rogy-AquaLab/sinsei_UMIUSI_pcb/README.md

# 新生UMIUSIの回路
- 円形基板を積層し、スペースを有効利用
- 表面実装部品の多用による小型化
- 補助マイコン廃止によるプログラムの簡略化
