rogy-AquaLab/sinsei_UMIUSI_pcb/AQUA_VESC/silk.docx

VESC for azimuth thruster

Based on Cheap FOCer

You can use XA or XH for J1, J2, J3

VESC ID

CAN ID

set-servo

SERVO(output only)

This PCB is intended to drive tk Azimuth Thruster
