rogy-AquaLab/sinsei_UMIUSI_pcb/AQUA_VESC/20250817_073502733_iOS.jpg

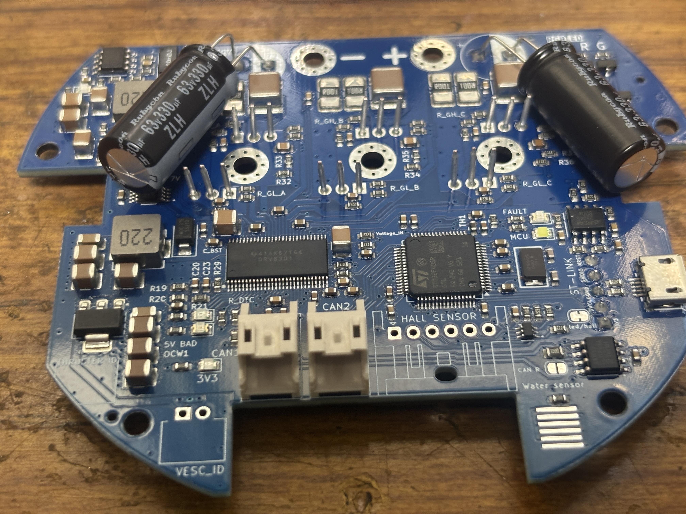
AQUA_VESC/20250817_073502733_iOS.jpg
