rogy-AquaLab/sinsei_UMIUSI_pcb/AQUA_VESC/20250819_080514195_iOS.jpg

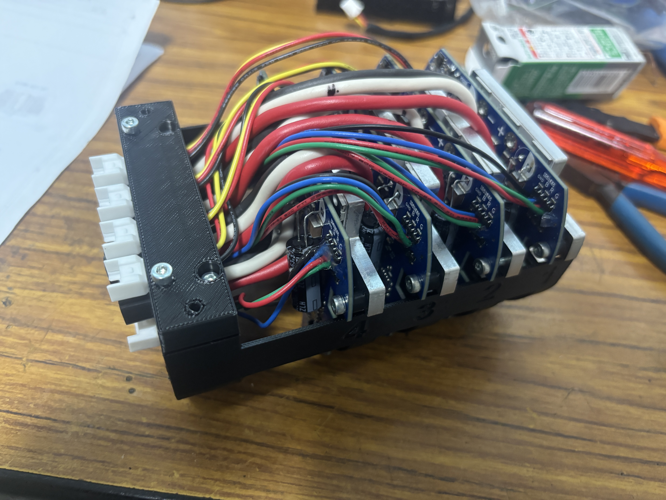
AQUA_VESC/20250819_080514195_iOS.jpg
