rogy-AquaLab/sinsei_UMIUSI_pcb/AQUA_VESC/no_limit.png

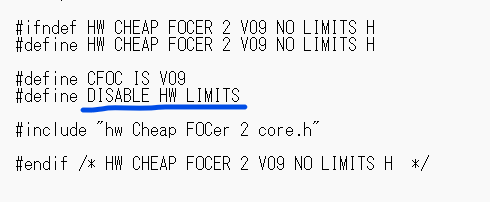
AQUA_VESC/no_limit.png
