rogy-AquaLab/sinsei_UMIUSI_pcb/AQUA_VESC/PSPICE/DRV8301.png

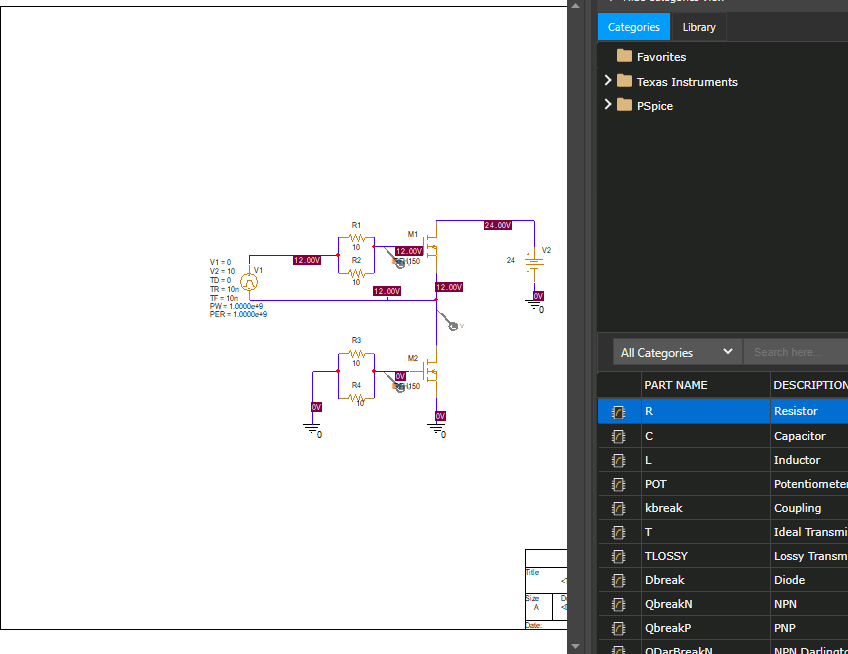
AQUA_VESC/PSPICE/DRV8301.png
