rogy-AquaLab/sinsei_UMIUSI_pcb/back_connector_base/aqua_rogo.png

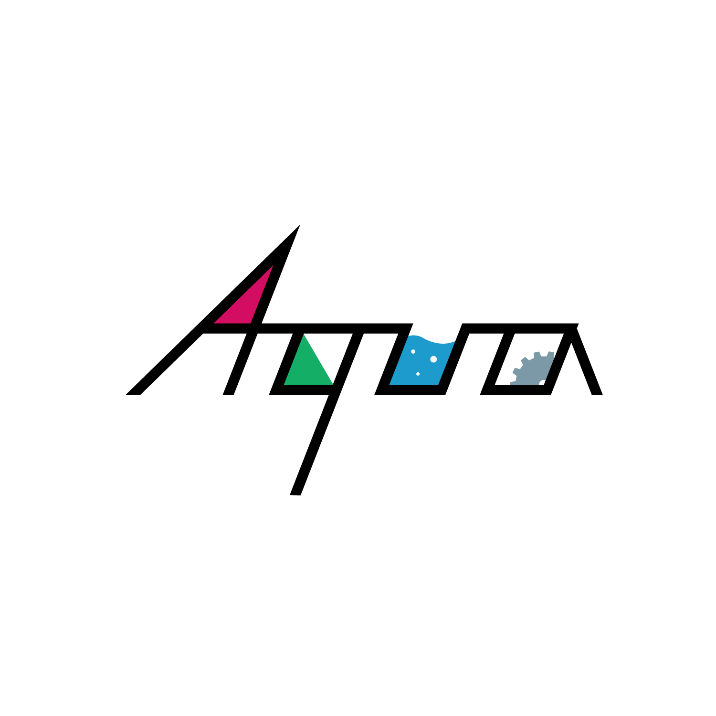
back_connector_base/aqua_rogo.png
