rogy-AquaLab/sinsei_UMIUSI_pcb/back_connector_base/auv_rov_core_unit.png

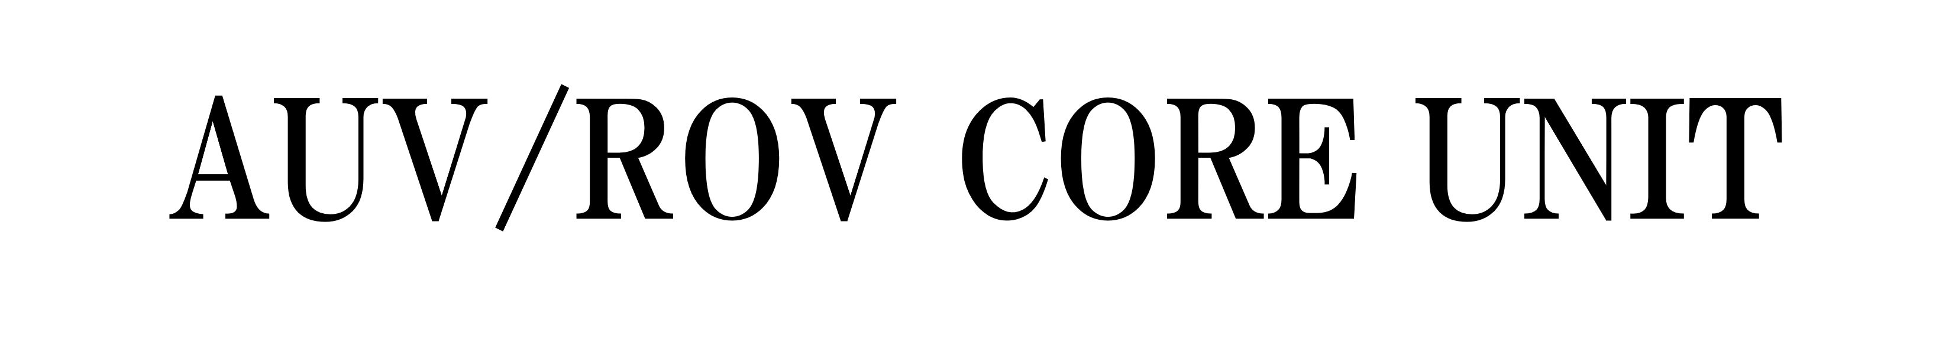
back_connector_base/auv_rov_core_unit.png
