rogy-AquaLab/sinsei_UMIUSI_pcb/control_unit/REV00 LED基板接続表.png

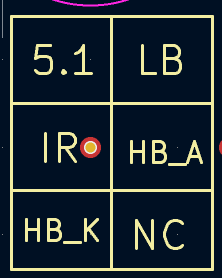
control_unit/REV00 LED基板接続表.png
