rogy-AquaLab/sinsei_UMIUSI_pcb/ESC画像.png

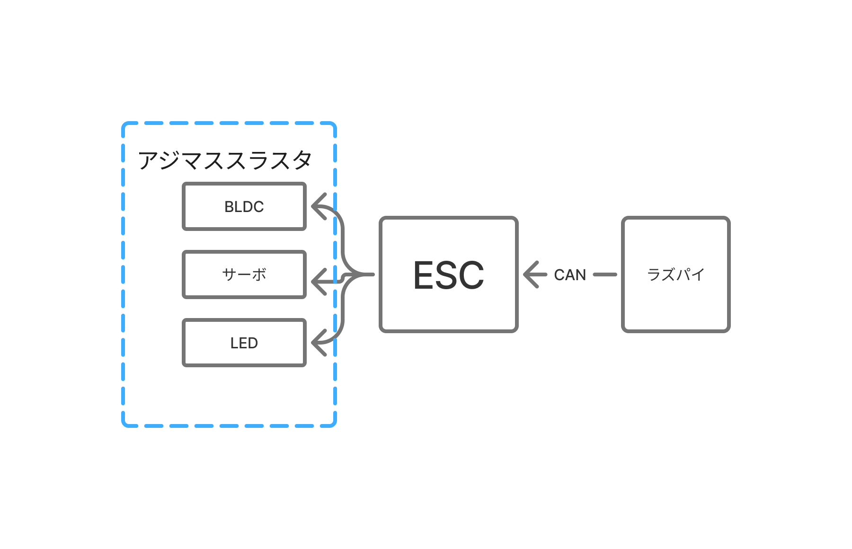
ESC画像.png
