rogy-AquaLab/sinsei_UMIUSI_pcb/新生UMIUSI回路.png

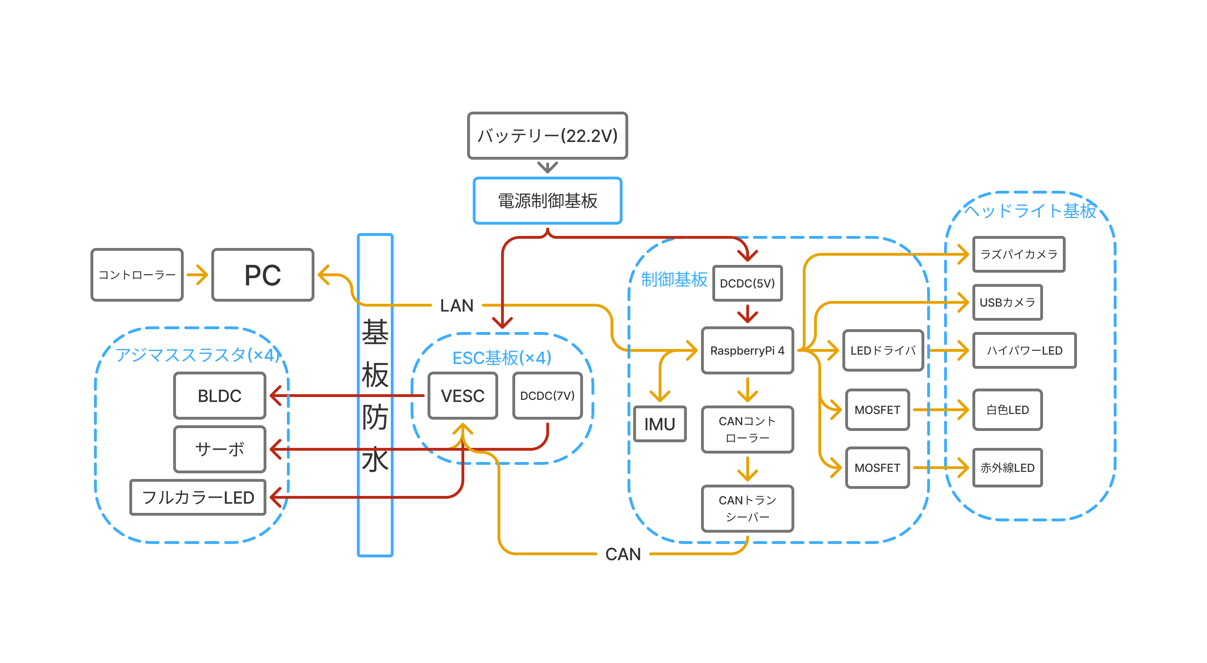
新生UMIUSI回路.png
