rogy-AquaLab/sinsei_UMIUSI_pcb/control_unit/bom.csv

Reference | Value | 所持 | 必要個数 | 売り場 | リンク
Analog_IN1 | Conn_01x04_Pin | 〇
CAN1 | Conn_01x02_Pin | 〇
CAN2 | Conn_01x02_Pin | 〇
Cc1 | 5.6n | 〇
Cc2 | 82p | 〇
Cc3 | 1500p | 〇
headlight1 | Conn_02x03_Odd_Even | △
J2 | Conn_01x02_Socket | 〇
J4 | SERVO_PWM | 〇
J5 | BLDC1 | 〇
J6 | BLDC1 | 〇
J7 | BLDC1 | 〇
J8 | BLDC1 | 〇
J9 | Barrel_Jack_Switch | 〇
M1 | Motor_Servo | 〇
M2 | Fan | 〇
Q1 | MTB7D0N6RJ3 |  | 2 | 36番売場 2段目 | https://akizukidenshi.com/catalog/g/g117191/
R1 | 20m |  | 1 | 1F 15番売場 下段スチール棚の引出 | https://akizukidenshi.com/catalog/g/g106668/
TP1 | TestPoint |  | 3 | 1F 12番売場 下段スチール棚の引出 | https://akizukidenshi.com/catalog/g/g107593/
U1 | CL6808 |  | 1 | 1F 34番売場 4段目 | https://akizukidenshi.com/catalog/g/g106278/
U2 | ~ | 〇
U3 | ATA6561-GAQW-N |  | 1 | 1F 38番売場 3段目 | https://akizukidenshi.com/catalog/g/g130008/
U4 | ADS1015IDGS |  | 1 | なし
U15 | BNO055 DIP | 〇
