rogy-AquaLab/sinsei_UMIUSI_pcb/LM25145_test/タイプ3位相補償設計/LM25145_quickstart_calculator_A5.xlsm

Sheet: Design Regulator
LM(2)5145/46-Q1 DC-DC Controller Design Tool
About |  | xx (http://www.ti.com/pol) |  |  | = Input Box |  |  |  |  | TERMS OF USE
Step 1: Operating Specifications
 |  |  | Input Voltage ‒ Min, VIN(min) | 18 | V
 |  |  | Input Voltage ‒ Nom, VIN(nom) | 24 | V
 |  |  | Input Voltage ‒ Max, VIN(max) | 36 | V
 |  |  | Output Voltage, VOUT | 5.1 | V
 |  |  | Maximum Output Current, IOUT | 6 | A
 |  |  | Free-running Switching Frequency, FSW | 300 | kHz
 |  |  | SYNC Frequency (if used), FSW-SYNC | 300 | kHz
 |  |  | Frequency Set Resistor, RRT | 33.2 | kΩ
Step 2: Filter Inductor
 |  |  | Recommended Filter Inductance | 6.7 | µH
 |  |  | Inductance, LF | 9.5 | µH
 |  |  | Inductor DCR | 20 | mΩ
 |  |  | Pk-to-Pk Ripple Current at VIN(nom), DIL | 1.5 | Apk-pk
 |  |  | Inductor Ripple Current as a % of Max IOUT | 24.20526316 | %
 |  |  | Estimate Core Loss at VIN(nom) | 0.2 | W
Step 3: RDS(on) or Shunt-Based Current Limit
 |  |  | Shunt, RS | 6 | mΩ |  |  |  |  |  | \
 |  |  | Required Current Limit Setpoint | 6.5 | A
 |  |  | Current Limit Set Resistor, RILIM | 174 | Ω
 |  |  | Min Inductor Sat Current, IL(SAT) | 8.4 | A
 |  |  | Power Loss in RS at Full Load, Max VIN | 0.16 | W
Step 4: Output Capacitance
 |  |  | Output Voltage Ripple Specification | 20 | mVpk-pk
 |  |  | Minimum Ideal Output Capacitance | 30.25657895 | µF
 |  |  | Total Output Capacitance (Derated), COUT | 135 | µF
 |  |  | Maximum Permitted ESR | 13.42078516 | mΩ
 |  |  | Output Capacitor ESR | 1 | mΩ
 |  |  | Resulting Output Voltage Ripple | 4.711861013 | mVpk-pk
 |  |  | Output Capacitor Ripple Current | 0.4 | A (rms)
Step 5: Input Capacitance
 |  |  | Input Voltage Ripple Specification | 50 | mVpk-pk
 |  |  | Minimum Ideal Input Capacitance | 68.4156 | µF
 |  |  | Total Input Capacitance (Derated), CIN | 110 | µF
 |  |  | Maximum Permitted ESR | 2.810222462 | mΩ
 |  |  | Input Capacitor ESR | 2 | mΩ
 |  |  | Resulting Input Voltage Ripple | 44.55031579 | mVpk-pk
 |  |  | Input Capacitor Ripple Current | 2.5 | A (rms)
Step 6: Soft-start, UVLO
 |  |  | Soft-Start Time, tSS | 8 | ms
 |  |  | Soft-Start Capacitance, CSS | 100 | nF
 |  |  | Input Voltage UVLO Turn-On | 8.33 | V
 |  |  | Input Voltage UVLO Turn-Off | 7.58 | V
 |  |  | UVLO Upper Resistor, RUV1 | 75 | kΩ
 |  |  | UVLO Lower Resistor, RUV2 | 12.7 | kΩ
If the SYNC feature is not required, connect SYNCIN to GND
or VCC for DCM or CCM operation, respectively
Step 7: Compensation Design
 |  |  | LC Complex Pole Frequency | 4.5 | kHz
 |  |  | ESR Zero Frequency | 1178.925506 | kHz
 |  |  | Desired Crossover Frequency | 48 | kHz
 |  |  | Appropriate Midband Gain | 0.71 | V/V
 |  |  | Upper Feedback Resistor, RFB1 | 18 | kΩ
 |  |  | Lower Feedback Resistor, RFB2 | 3.32 | kΩ
 |  |  | Actual Output Voltage, VOUT | 5.137 | V
Pole & Zero Placement |  |  | FZ1 | 4.1 | kHz
Baseline P/Z Frequencies: |  |  | FZ2 | 5.0 | kHz
 |  |  | FP1 | 200 | kHz
 |  |  | FP2 | 250 | kHz
Compensation Components
 | Calculated / | Std Values | Selected |  | Actual P/Z Frequencies
RC1 | 12.8 | 12.7 | 12 | kΩ | 4.0 | kHz (FZ1)
CC1 | 3028.309592 | 3300 | 3300 | pF | 5.7 | kHz (FZ2)
CC2 | 50.49235187 | 47 | 47 | pF | 225.7516926 | kHz (FP1)
RC2 | 461.5384615 | 464 | 470 | Ω | 286.20868 | kHz (FP2)
CC3 | 1724.178552 | 1800 | 1500 | pF |  |  | ** Specify Inductor Core Loss ** | 0.4 | W
Efficiency / Power Loss Analyzer
Step 8: Efficiency
 |  |  | High-Side MOSFET (Q1) Specifications | CSD18563Q5D
 |  |  | On-State Resistance, RDS(on) | 6 | mΩ
 |  |  | Total Gate Charge, QG | 27 | nC
 |  |  | Gate-Drain Charge, QGD | 9 | nC
 |  |  | Gate-Source Charge, QGS | 8 | nC
 |  |  | Output Capacitance, COSS | 338 | pF
 |  |  | Gate Resistance, RG | 2 | Ω
 |  |  | Transconductance, gFS | 100 | S
 |  |  | Gate-Source Plateau Voltage, VGS(MP) | 3.8 | V
 |  |  | Body Diode Forward Voltage, VBD1 | 0.8 | V
 |  |  | Thermal Resistance, θJA | 50 | °C/W
 |  |  | Low-Side MOSFET (Q2) Specifications | CSD18563Q5D
 |  |  | On-State Resistance, RDS(on) | 6 | mΩ
 |  |  | Total Gate Charge, QG | 27 | nC
 |  |  | Output Charge, QOSS | 20 | nC
 |  |  | Output Capacitance, COSS | 338 | pF
 |  |  | Body Diode Forward Voltage, VBD2 | 0.8 | V
 |  |  | Body Diode Recovery Charge, QRR | 19 | nC
 |  |  | Thermal Resistance, θJA | 50 | °C/W
 |  |  | Antiparallel Schottky Diode (if applicable)
 |  |  | Schottky Diode Forward Voltage, VSD | 0 | V
 |  |  | Schottky Diode Recovery Charge, QRR2 | 0 | nC
Step 9: IC Power Loss
 |  |  | IC Power Dissipation | 0.17 | W
 |  |  | IC Junction Temperature Rise (est) | 8.5 | °C

Sheet: Schematic & BOM
 | ** Tie SYNCIN to VCC and GND for CCM and DCM operation, respectively **
VIN = 24 V, VOUT = 5.1 V, IOUT = 6 A, Fsw = 300 kHz, Current Limit = 7 A
Wide VIN, High Efficiency Synchronous Buck Regulator BOM
Count | Ref Des | Value | Description | Size | Part Number | MFR | Footprint (mm) | Area (mm2)
1 | CBOOT | 0.1µF | Capacitor, Ceramic,0.1µF, 25V, X7R, 20% |  | Std | Std | 1.6 x 0.8 | 1.3 |  |  |  | 2
1 | CC1 | 3300pF | Capacitor, Ceramic,3300pF, 16V, X7R, 10% |  | Std | Std | 1.0 x 0.5 | 0.5 |  |  |  | 1
1 | CC2 | 47pF | Capacitor, Ceramic,47pF, 50V, NP0, 5% |  | Std | Std | 1.0 x 0.5 | 0.5 |  |  |  | 1
1 | CC3 | 1500pF | Capacitor, Ceramic,1500pF, 50V, NP0, 5% |  | Std | Std | 1.0 x 0.5 | 0.5 |  |  |  | 1
1 | CS | 33pF | Capacitor, Ceramic, 33pF, 100V, X7R, 20% |  | Std | Std | 1.6 x 0.8 | 1.3 |  |  |  | 2
11 | CIN | 4.7µF | Capacitor, Ceramic, 4.7µF, 50V, X7R, 10% |  | Std | Std | 3.2 x 2.5 | 88.0 |  |  |  | 5
3 | COUT | 47µF | Capacitor, Ceramic, 47µF, 10V, X7R, 10% |  | Std | Std | 3.2 x 2.5 | 24.0 |  |  |  | 5
1 | CSS | 100nF | Capacitor, Ceramic,100nF, 16V, X7R, 10% |  | Std | Std | 1.6 x 0.8 | 1.3 |  |  |  | 2
1 | CVCC | 2.2µF | Capacitor, Ceramic,2.2µF, 25V, X7R, 20% |  | Std | Std | 2.0 x 1.25 | 2.5 |  |  |  | 3
1 | CVIN | 0.1µF | Capacitor, Ceramic,0.1µF, 50V, X7R, 20% |  | Std | Std | 1.6 x 0.8 | 1.3 |  |  |  | 2
1 | LF | 9.5µH | Inductor, 9.5µH, 20mΩ, >9A |  | Various | Various | 10.0 x 10.0 | 100.0 |  |  |  | 7
1 | Q1 | See description | MOSFET, N-CH, 80V/100V,6mΩ |  | CSD18563Q5D | TI | 5.0 x 6.0 | 30.0 |  |  |  | 1 | 1
1 | Q2 | See description | MOSFET, N-CH, 80V/100V,6mΩ |  | CSD18563Q5D | TI | 5.0 x 6.0 | 30.0 |  |  |  | 1 | 1
1 | RC1 | 12k | Resistor, Chip,12kΩ, 1/16W, 1% |  | Std | Std | 1.0 x 0.5 | 0.5 |  |  |  | 1
1 | RC2 | 470 | Resistor, Chip,470Ω, 1/16W, 1% |  | Std | Std | 1.0 x 0.5 | 0.5 |  |  |  | 1
1 | RILIM | 174 | Resistor, Chip,174Ω, 1/16W, 1% |  | Std | Std | 1.0 x 0.5 | 2.5 |  |  |  | 3
1 | RRT | 33.2k | Resistor, Chip,33.2kΩ, 1/16W, 1% |  | Std | Std | 1.0 x 0.5 | 0.5 |  |  |  | 1
1 | RFB1 | 18k | Resistor, Chip,18kΩ, 1/16W, 1% |  | Std | Std | 1.0 x 0.5 | 0.5 |  |  |  | 1
1 | RFB2 | 3.32k | Resistor, Chip,3.32kΩ, 1/16W, 1% |  | Std | Std | 1.0 x 0.5 | 0.5 |  |  |  | 1
1 | RPGOOD | 20k | Resistor, Chip,20kΩ, 1/16W, 1% |  | Std | Std | 1.0 x 0.5 | 0.5 |  |  |  | 1
1 | RS | 6mΩ | Resistor,6mΩ, 1/4W, 1% | 1206 | Std | Std | 3.2 x 1.6 | 0.0
1 | RUV1 | 75k | Resistor, Chip,75kΩ, 1/16W, 1% |  | Std | Std | 1.6 x 0.8 | 1.3 |  |  |  | 2
1 | RUV2 | 12.7k | Resistor, Chip,12.7kΩ, 1/16W, 1% |  | Std | Std | 1.0 x 0.5 | 0.5 |  |  |  | 1
1 | RVIN | 2.2 | Resistor, Chip,2.2Ω, 1/16W, 1% |  | Std | Std | 1.0 x 0.5 | 0.5 |  |  |  | 1
1 | U1 | LM25145 | IC, LM25145, PWM Controller, 6V-42V Input | VQFN-20 | LM25145RGYR | TI | 3.5 x 4.5 x 1.0 | 15.75
 |  |  |  |  | Total Solution Size (buffered by 25%) |  |  | 380.9 | mm2 = | 0.5905 | in2
NOTES:
** Inductor saturation current should be higher than the current limit setpoint at all operating temperatures **
** Effective output capacitance should be appropriately derated for applied voltage and temperature, particularly with ceramics **
 |  |  |  |  |  |  |  |  |  |  |  | 2

Sheet: EVMs
LM(2)5145/6/-Q1 Quickstart Calculator
 | LM5146-Q1-EVM12V
 | LM5145EVM-HD-20A PCB Layout
 |  | Top
 |  | Layer | x
 |  | Layer 2
 |  | Layer 3
 |  | Bottom
