rogy-AquaLab/sinsei_UMIUSI_pcb/AQUA_VESC-to-relay-pcb/AQUA_VESC-to-relay-pcb.step

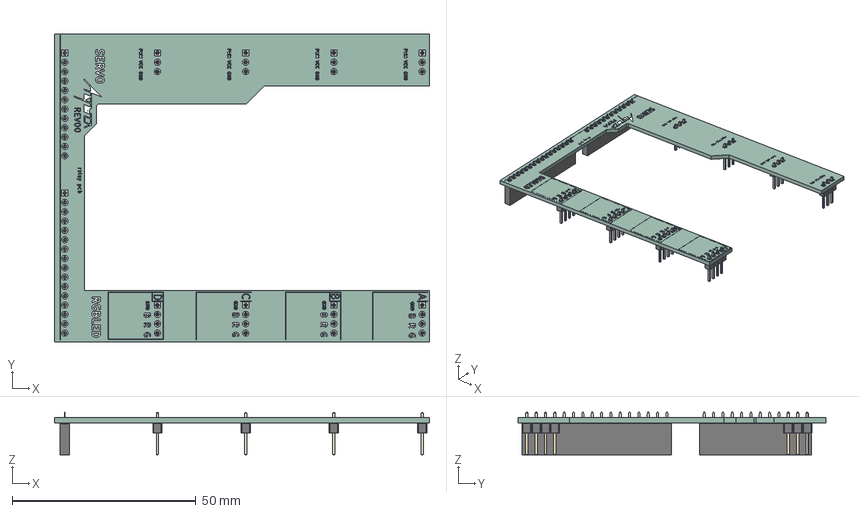
[picture p12: CAD file, 2025-10-03]
AQUA_VESC-to-relay-pcb/AQUA_VESC-to-relay-pcb.step
102.0 x 83.7 x 11.6 mm
PinHeader_1x04_P2.54mm_Vertical x 4
PinHeader_1x03_P2.54mm_Vertical x 4
PinSocket_1x16_P2.54mm_Vertical
PinSocket_1x12_P2.54mm_Vertical
AQUA_VESC-to-relay-pcb_pad
AQUA_VESC-to-relay-pcb_silkscreen
AQUA_VESC-to-relay-pcb_PCB
