rogy-AquaLab/sinsei_UMIUSI_pcb/back_connector_base/back_connector_base.dxf

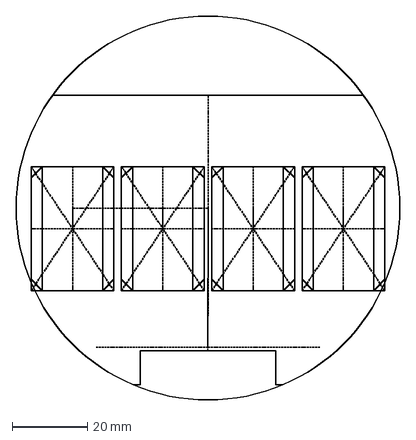
[picture p13: CAD file, 2025-10-03]
back_connector_base/back_connector_base.dxf
102.0 x 102.0 mm
