rogy-AquaLab/sinsei_UMIUSI_pcb/back_connector_esc/back_connector_esc.step

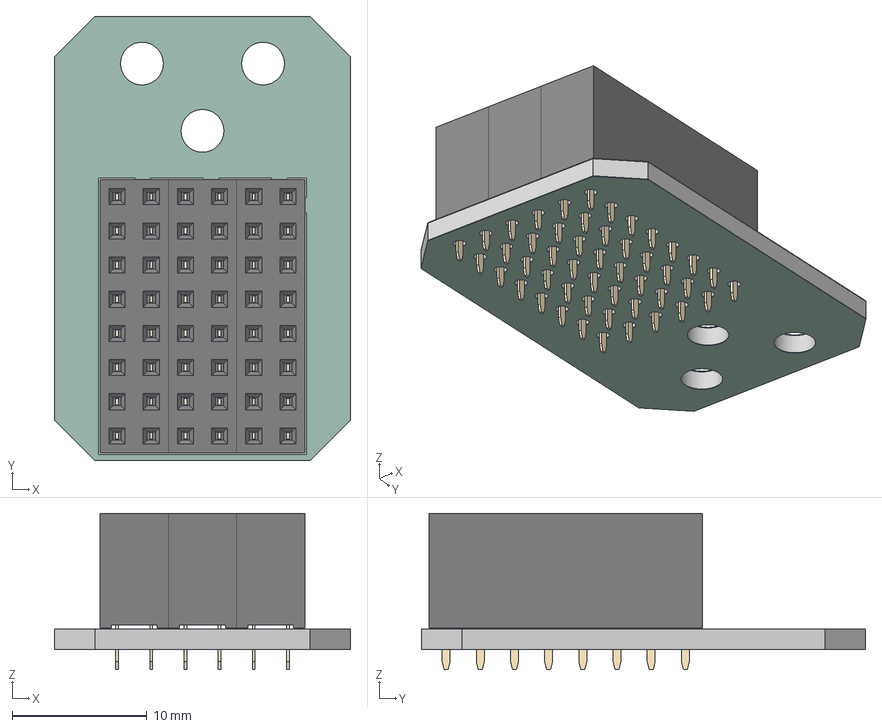
[picture p14: CAD file, 2025-10-03]
back_connector_esc/back_connector_esc.step
22.0 x 33.0 x 11.6 mm
PinSocket_2x08_P2.54mm_Vertical x 3
back_connector_esc_silkscreen
back_connector_esc_soldermask
back_connector_esc_PCB
