rogy-AquaLab/sinsei_UMIUSI_pcb/can_connector/can_connector.step

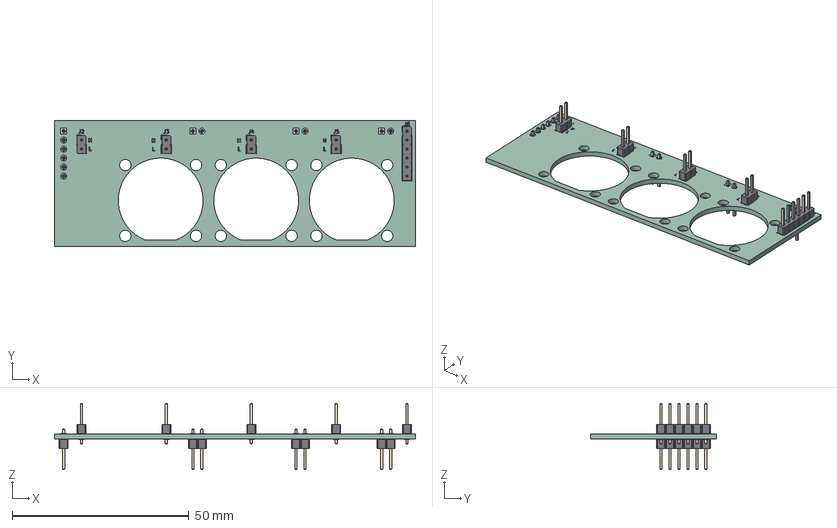
[picture p15: CAD file, 2025-10-03]
can_connector/can_connector.step
102.0 x 35.6 x 18.8 mm
PinHeader_1x02_P2.54mm_Vertical x 7
PinHeader_1x06_P2.54mm_Vertical x 2
can_connector_pad
can_connector_silkscreen
can_connector_PCB
