rogy-AquaLab/sinsei_UMIUSI_pcb/control_unit/CAD/Pin Header - RaspberryPi - Stacking - 2.54mm_V2.step

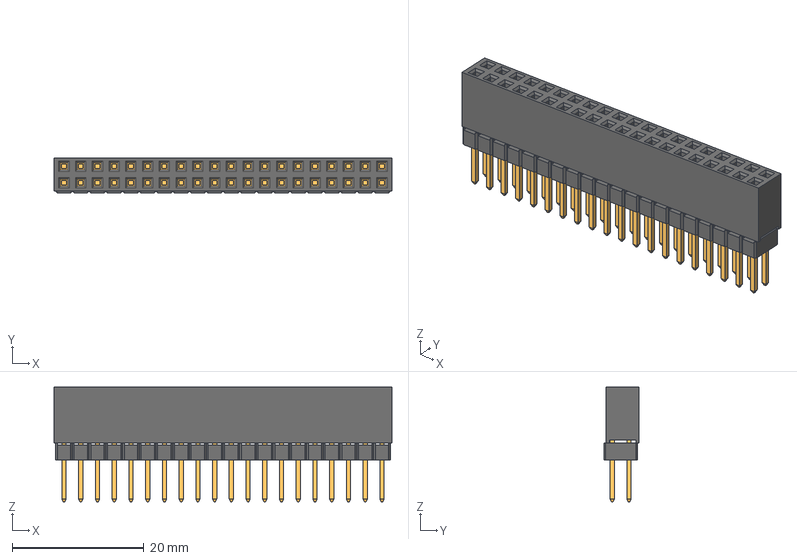
[picture p16: CAD file, 2025-06-03]
control_unit/CAD/Pin Header - RaspberryPi - Stacking - 2.54mm_V2.step
51.3 x 5.33 x 17.4 mm
