rogy-AquaLab/sinsei_UMIUSI_pcb/frame/基板ホルダ3.step

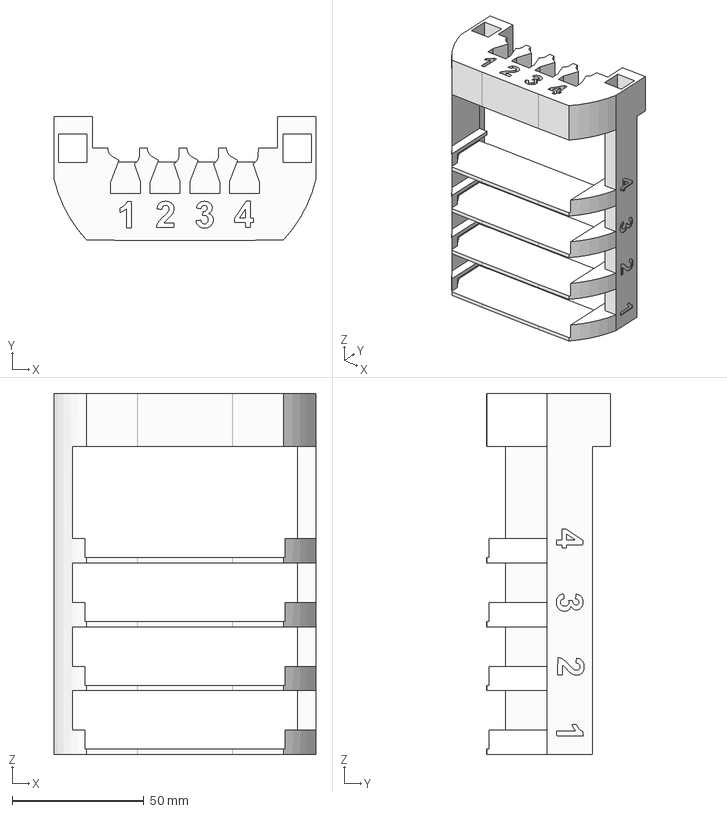
[picture p17: CAD file, 2025-08-26]
frame/基板ホルダ3.step
99.1 x 47.0 x 136.8 mm
