rogy-AquaLab/sinsei_UMIUSI_pcb/headlight_lower_side/headlight_lower_side.step

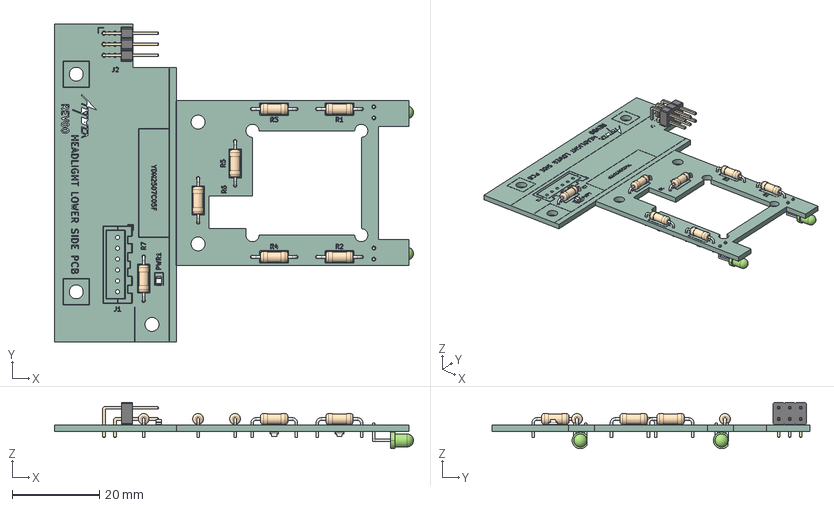
[picture p18: CAD file, 2025-07-05]
headlight_lower_side/headlight_lower_side.step
82.5 x 73.0 x 10.7 mm
R_Axial_DIN0207_L6.3mm_D2.5mm_P10.16mm_Horizontal x 7
LED_0805_2012Metric x 5
PinHeader_2x03_P2.54mm_Horizontal
LED_D3.0mm_Horizontal_O3.81mm_Z2.0mm x 2
headlight_lower_side_silkscreen
headlight_lower_side_PCB
