rogy-AquaLab/sinsei_UMIUSI_pcb/headlight_upper_side/headlight_upper_side.step

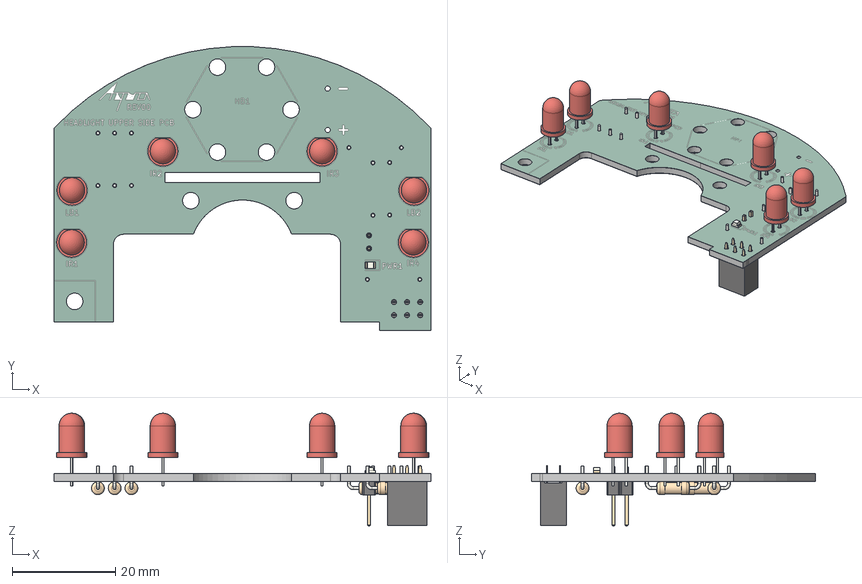
[picture p19: CAD file, 2025-07-05]
headlight_upper_side/headlight_upper_side.step
73.0 x 54.9 x 21.8 mm
LED_D5.0mm x 6
LED_0805_2012Metric
R_Axial_DIN0207_L6.3mm_D2.5mm_P10.16mm_Horizontal x 7
PinSocket_2x03_P2.54mm_Vertical
PinHeader_1x02_P2.54mm_Vertical
headlight_upper_side_silkscreen
headlight_upper_side_soldermask
headlight_upper_side_PCB
