rogy-AquaLab/sinsei_UMIUSI_pcb/LED基板概要.dxf

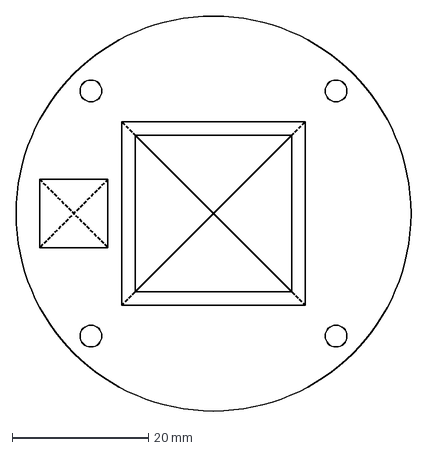
[picture p20: CAD file, 2025-04-20]
LED基板概要.dxf
58.0 x 58.0 mm
