rogy-AquaLab/sinsei_UMIUSI_pcb/pcb_connector_azimuth_thruster/pcb_connector_azimuth_thruster.step

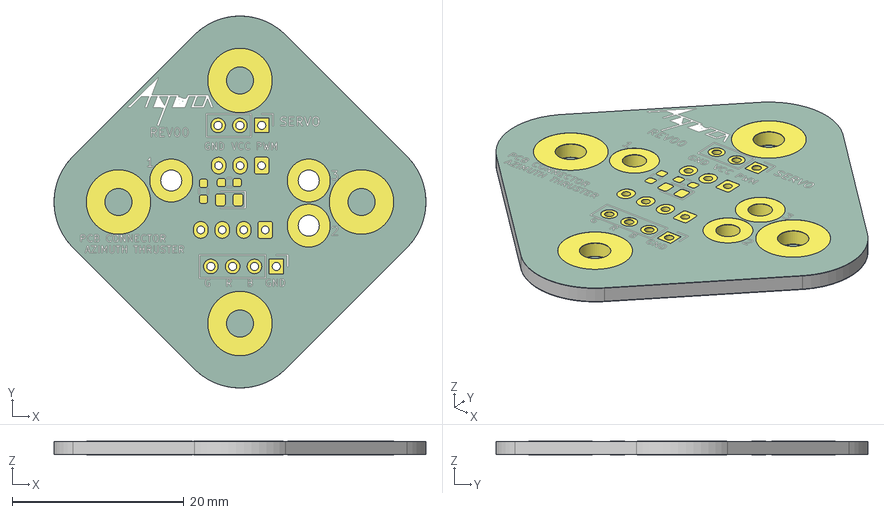
[picture p21: CAD file, 2025-07-05]
pcb_connector_azimuth_thruster/pcb_connector_azimuth_thruster.step
43.3 x 43.3 x 1.66 mm
pcb_connector_azimuth_thruster_pad
pcb_connector_azimuth_thruster_silkscreen
pcb_connector_azimuth_thruster_soldermask
pcb_connector_azimuth_thruster_PCB
