rogy-AquaLab/sinsei_UMIUSI_pcb/pcb_connector_lan(inner)/pcb_connector_lan(inner).step

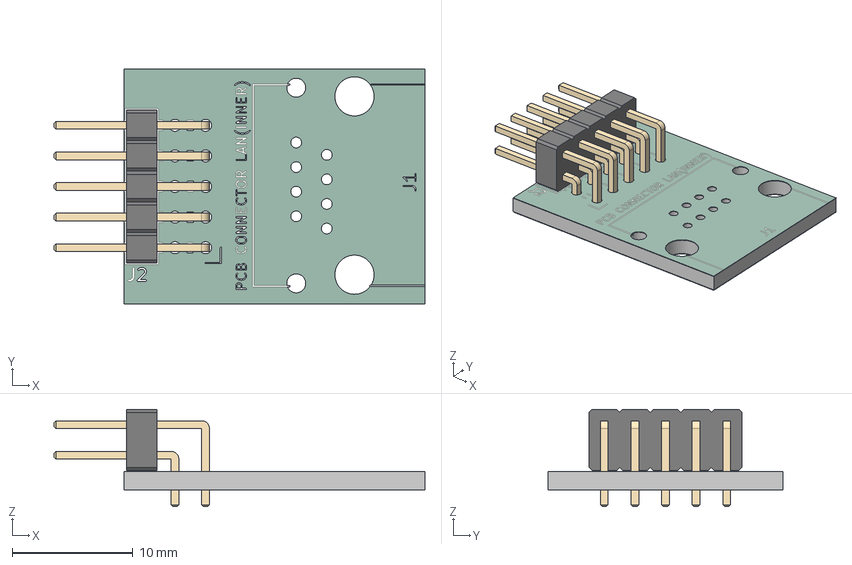
[picture p22: CAD file, 2025-07-05]
pcb_connector_lan(inner)/pcb_connector_lan(inner).step
30.8 x 19.5 x 8.08 mm
PinHeader_2x05_P2.54mm_Horizontal
pcb_connector_lan_silkscreen
pcb_connector_lan_soldermask
pcb_connector_lan_PCB
