rogy-AquaLab/sinsei_UMIUSI_pcb/pcb_connector_lan(outer)/pcb_connector_lan(outer).step

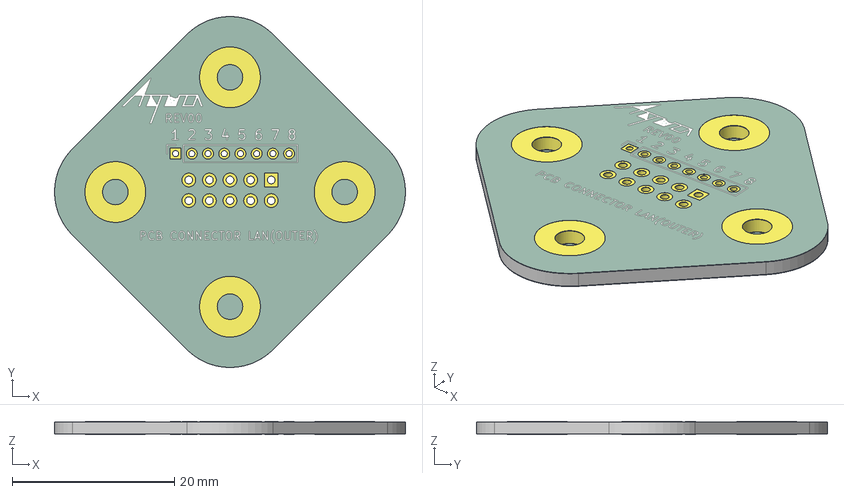
[picture p23: CAD file, 2025-07-05]
pcb_connector_lan(outer)/pcb_connector_lan(outer).step
43.3 x 43.3 x 1.66 mm
pcb_connector_lan(outer)_pad
pcb_connector_lan(outer)_silkscreen
pcb_connector_lan(outer)_soldermask
pcb_connector_lan(outer)_PCB
