rogy-AquaLab/sinsei_UMIUSI_pcb/pcb_connector_led_tape/pcb_connector_led_tape.step

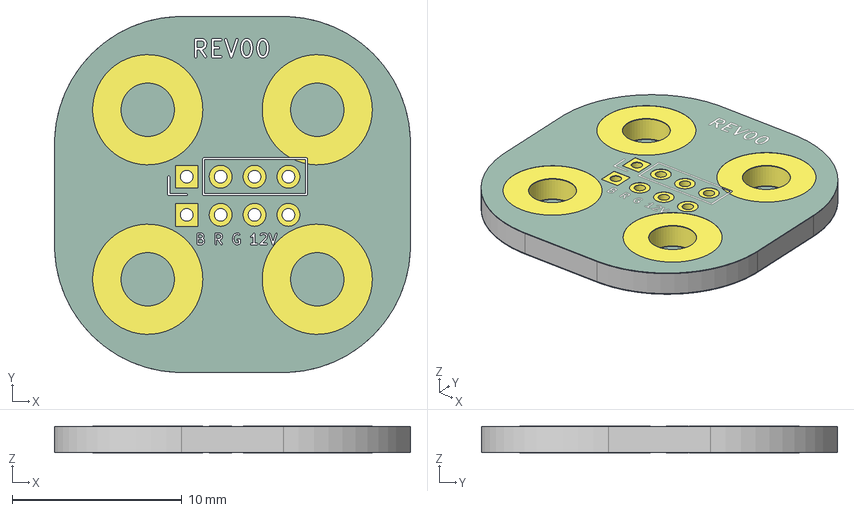
[picture p24: CAD file, 2025-07-05]
pcb_connector_led_tape/pcb_connector_led_tape.step
21.0 x 21.0 x 1.66 mm
pcb_connector_led_tape_pad
pcb_connector_led_tape_silkscreen
pcb_connector_led_tape_soldermask
pcb_connector_led_tape_PCB
