rogy-AquaLab/sinsei_UMIUSI_pcb/power_circuit_2/スケッチ1.dxf

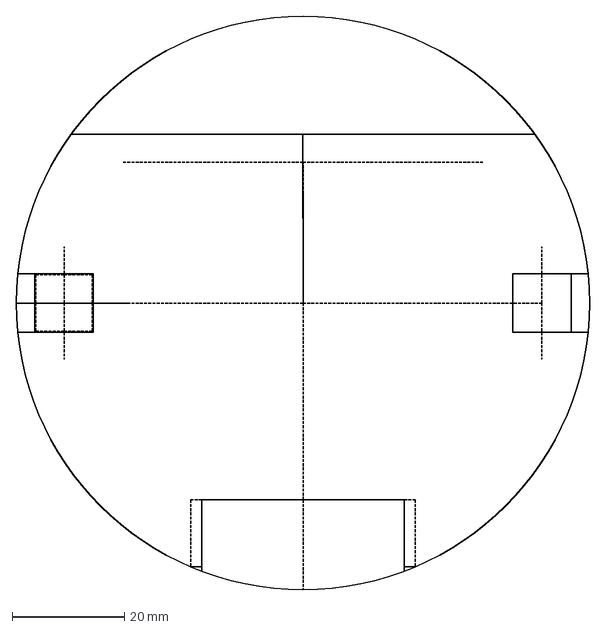
[picture p25: CAD file, 2025-07-21]
power_circuit_2/スケッチ1.dxf
102.0 x 102.0 mm
