rogy-AquaLab/sinsei_UMIUSI_pcb/UmiusiThrusterLEDUnit/UmiusiThrusterLEDUnit.step

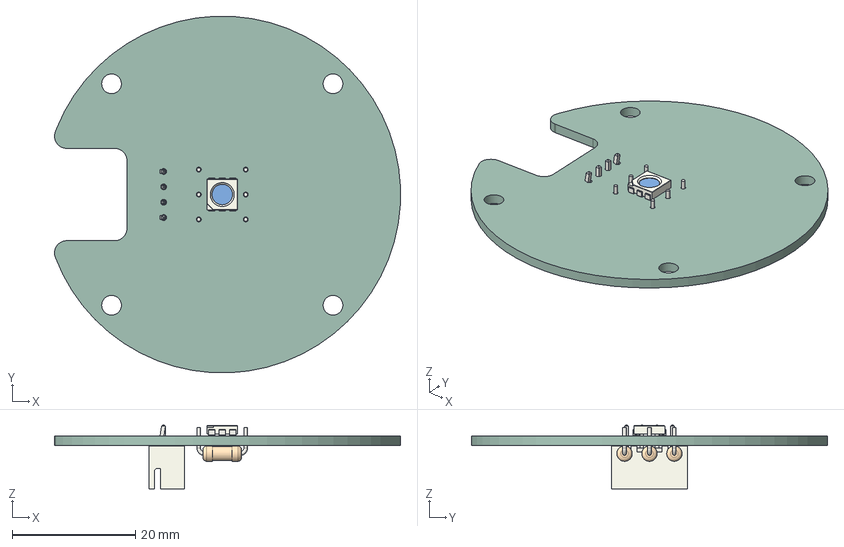
[picture p26: CAD file, 2025-04-28]
UmiusiThrusterLEDUnit/UmiusiThrusterLEDUnit.step
56.3 x 57.9 x 10.4 mm
LED_RGB_5050_6
JST_B4B_XH_A
R_Axial_DIN0207_L63mm_D25mm_P762mm_Horizontal x 3
_autosave-UmiusiThrusterLEDUnit_PCB
