rogy-AquaLab/sinsei_UMIUSI_pcb/frame/制御基板取付用 v6.stl

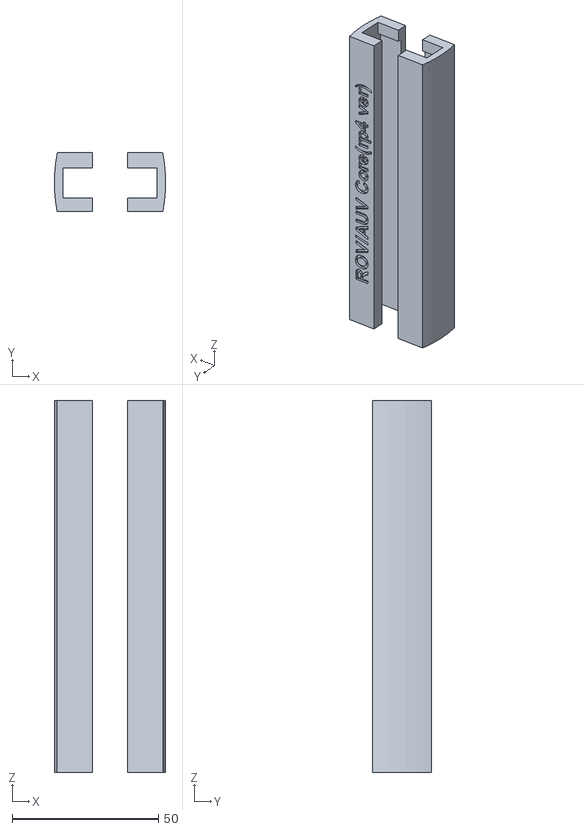
[picture p27: CAD file, 2025-08-26]
frame/制御基板取付用 v6.stl
38.0 x 20.0 x 127.0
