rogy-AquaLab/sinsei_UMIUSI_pcb/headlight_lower_side/headlight_upper_side.dxf

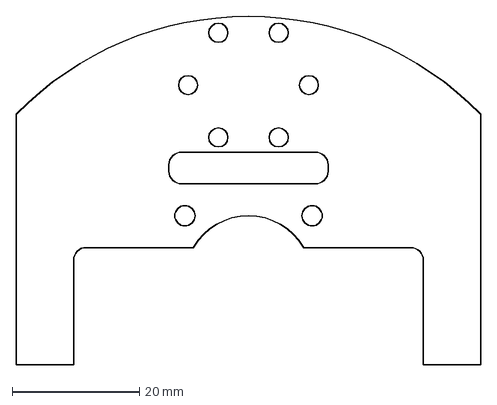
[picture p28: CAD file, 2025-06-10]
headlight_lower_side/headlight_upper_side.dxf
73.0 x 54.8 mm
