rogy-AquaLab/sinsei_UMIUSI_pcb/UmiusiThrusterLEDUnit/UmiusiThrusterLEDUnit-User_1.dxf

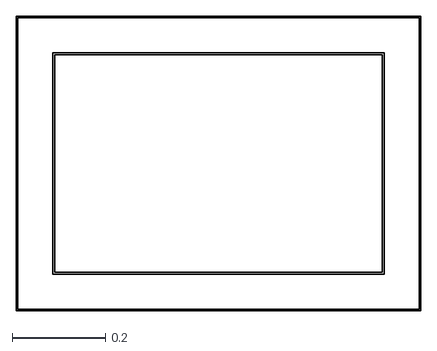
[picture p29: CAD file, 2025-04-28]
UmiusiThrusterLEDUnit/UmiusiThrusterLEDUnit-User_1.dxf
0.87 x 0.634
