rogy-AquaLab/sinsei_UMIUSI_pcb/headlight_lower_side/スケッチ9.dxf

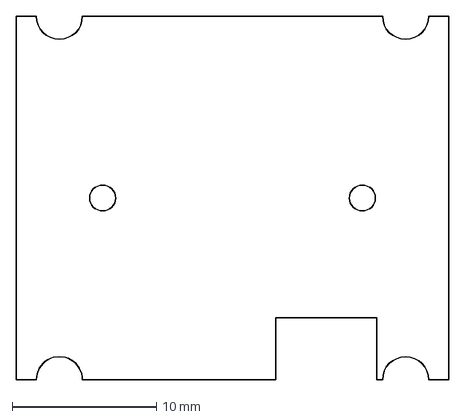
[picture p30: CAD file, 2025-06-03]
headlight_lower_side/スケッチ9.dxf
30.0 x 25.2 mm
