rogy-AquaLab/sinsei_UMIUSI_pcb/UmiusiThrusterLEDUnit/Component8.step

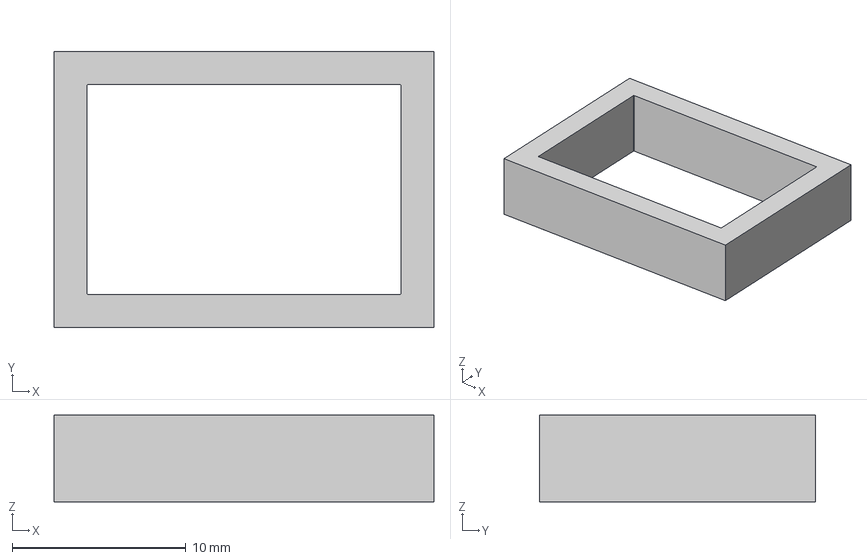
[picture p31: CAD file, 2025-04-28]
UmiusiThrusterLEDUnit/Component8.step
21.9 x 15.9 x 5.00 mm
