rogy-AquaLab/sinsei_UMIUSI_pcb/frame/基板ホルダ2.step

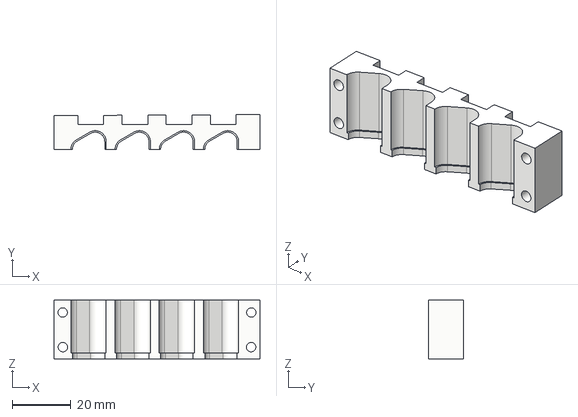
[picture p32: CAD file, 2025-08-26]
frame/基板ホルダ2.step
70.0 x 11.8 x 20.0 mm
