rogy-AquaLab/sinsei_UMIUSI_pcb/headlight_lower_side/high power LED.dxf

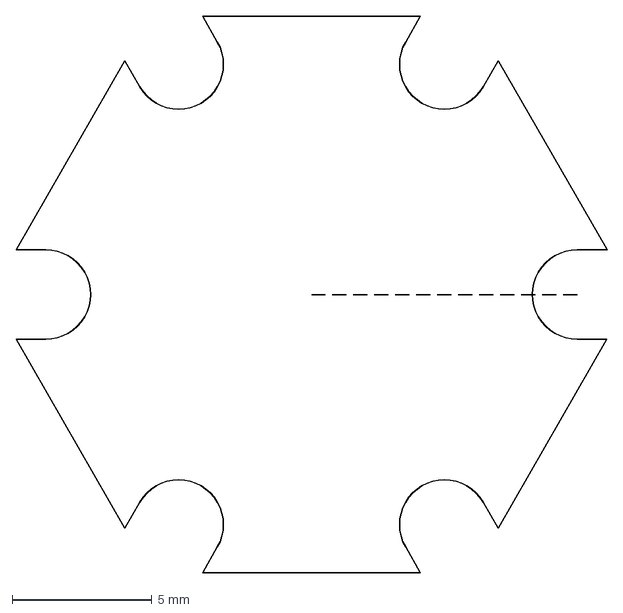
[picture p33: CAD file, 2025-06-03]
headlight_lower_side/high power LED.dxf
21.1 x 19.9 mm
