rogy-AquaLab/sinsei_UMIUSI_pcb/frame/4.5mmスペーサ- 3Dプリンター製 v3.stl

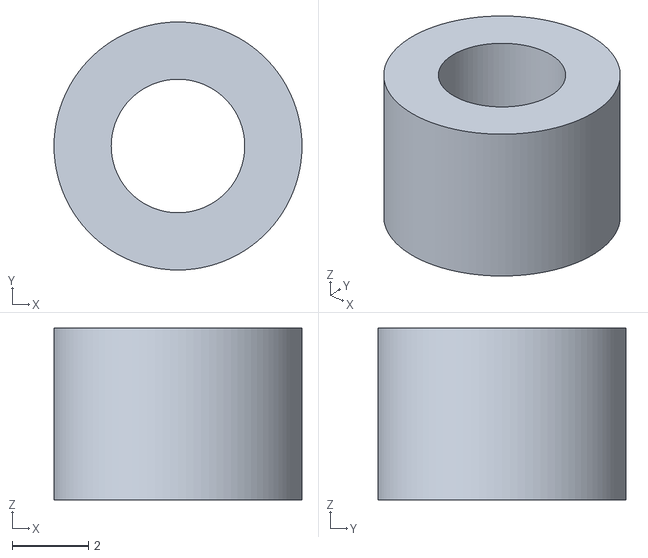
[picture p34: CAD file, 2025-08-18]
frame/4.5mmスペーサ- 3Dプリンター製 v3.stl
6.50 x 6.50 x 4.50
