rogy-AquaLab/sinsei_UMIUSI_pcb/frame/基盤ホルダ蓋1.step

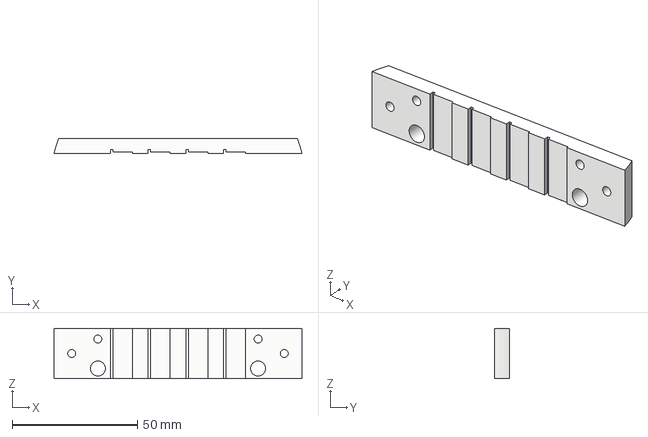
[picture p35: CAD file, 2025-08-18]
frame/基盤ホルダ蓋1.step
99.1 x 6.00 x 20.0 mm
