rogy-AquaLab/sinsei_UMIUSI_pcb/frame/基盤防水ガード(小型) v1.stl

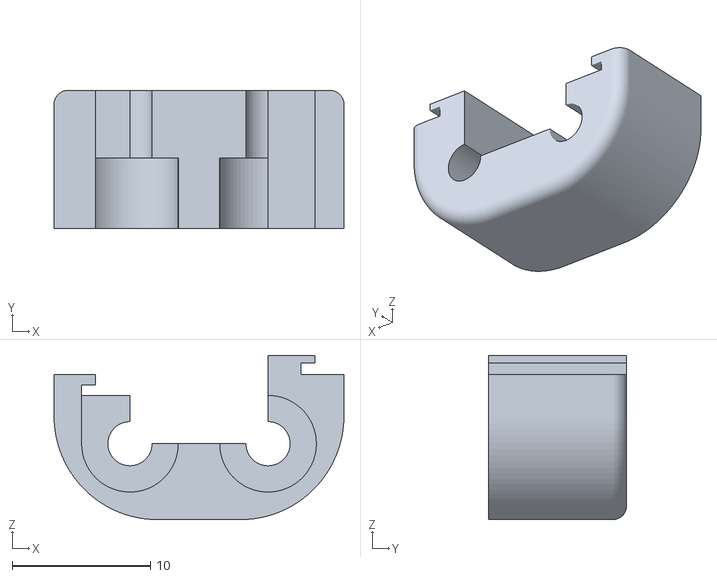
[picture p36: CAD file, 2025-07-05]
frame/基盤防水ガード(小型) v1.stl
21.0 x 10.0 x 11.9
