rogy-AquaLab/sinsei_UMIUSI_pcb/frame/カメラ用 v1.stl

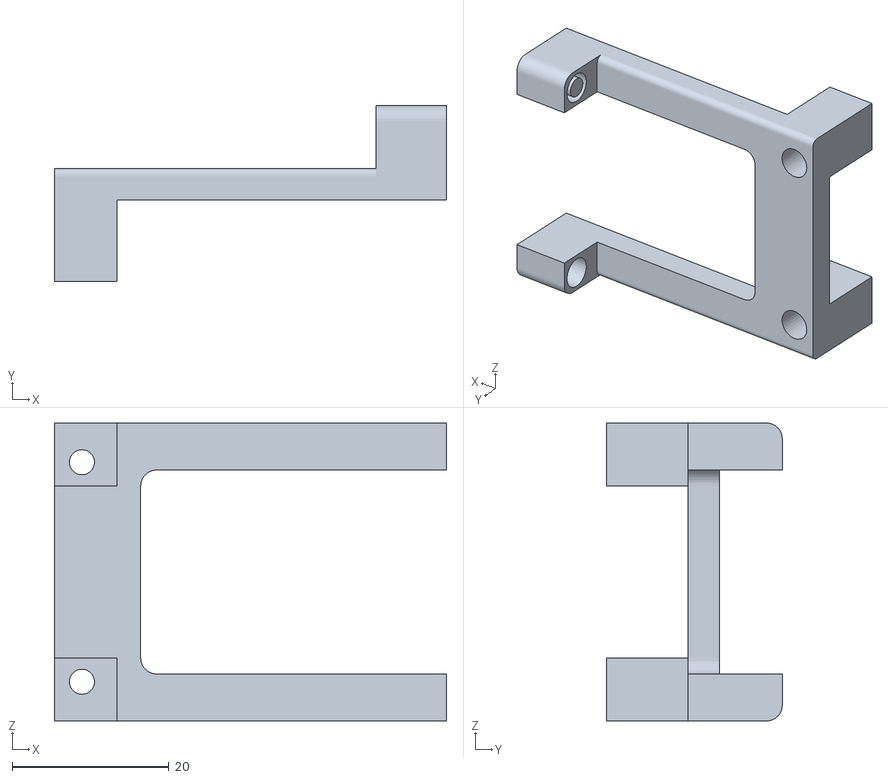
[picture p37: CAD file, 2025-07-05]
frame/カメラ用 v1.stl
50.0 x 22.4 x 38.0
