rogy-AquaLab/sinsei_UMIUSI_pcb/frame/基盤防水ガード(大型)　印刷用 v1.stl

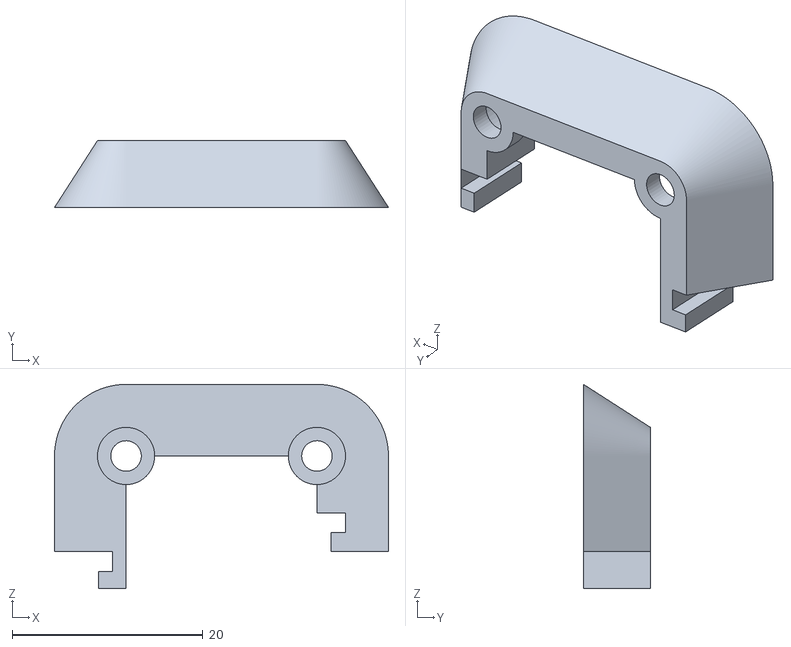
[picture p38: CAD file, 2025-07-05]
frame/基盤防水ガード(大型) 印刷用 v1.stl
35.0 x 7.00 x 21.4
