rogy-AquaLab/sinsei_UMIUSI_pcb/frame/battery_holder_front v5.stl

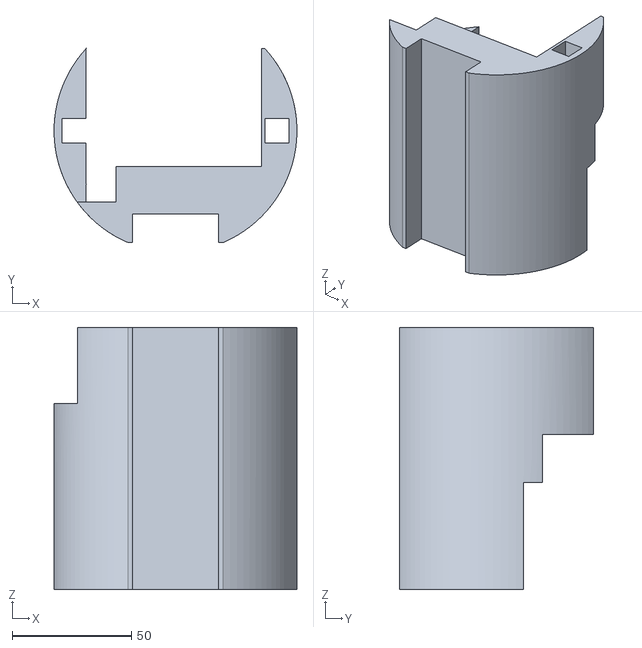
[picture p39: CAD file, 2025-06-10]
frame/battery_holder_front v5.stl
102.0 x 81.5 x 110.0
