rogy-AquaLab/sinsei_UMIUSI_pcb/frame/battery_holder_back v3.stl

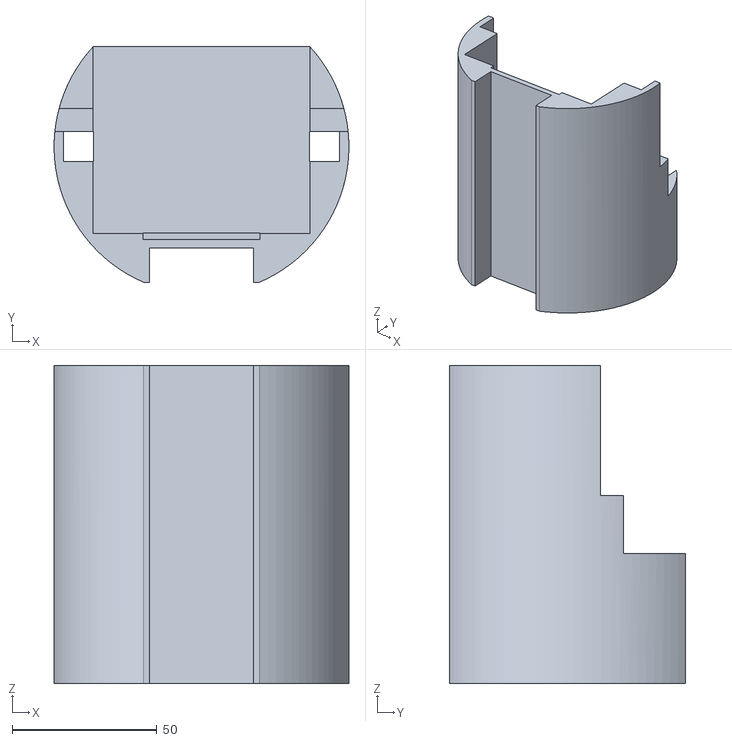
[picture p40: CAD file, 2025-06-10]
frame/battery_holder_back v3.stl
102.0 x 81.5 x 110.0
