rogy-AquaLab/sinsei_UMIUSI_pcb/(list of files, cad)

Other CAD files:
frame/ESCホルダ蓋2.f3d
frame/制御基板取付用 v4.stl
frame/制御基板取付用 v5.stl
frame/基板ホルダ2.f3d
headlight_lower_side/headlight_lower_side.dxf
headlight_upper_side/headlight_upper_side.dxf
