rogy-AquaLab/sinsei_UMIUSI_pcb/LM25145_test/タイプ3位相補償設計/タイプ3位相補償、5パターン.xlsx

インダクタ |  | 9.5uF
出力コンデンサ |  | 135uF
LCダブルポール |  | 4444Hz
応答性重視 | 0 | ① | ② | ③(デフォルト） | ④ | 安定性重視 | ⑤（WEBBENCH DESINGERの推奨）
位相交差周波数(kHz) |  | 43 | 37 | 31 | 29 |  | 34
位相余裕(°) |  | 60 | 58 | 59 | 57 |  | 45
ゲイン余裕(dB) |  | 12 | 12 | 13 | 24 |  | 25
Fz1(kHz) |  | 3.2 | 4.1 | 3 | 3 |  | 1.5
Fz2(kHz) |  | 5.8 | 5 | 6 | 6 |  | 10.7
Fp1(kHz) |  | 322 | 200 | 200 | 100 |  | 1903
Fp2(kHz) |  | 229 | 250 | 200 | 1700 |  | 74
Rc1(Ω) |  | 15k | 10k | 10k | 9.1k |  | 22k
Cc1(F) |  | 3300p | 3300p | 6800p | 5600p |  | 4700p
Cc2(F) |  | 47p | 47p | 82p | 10p |  | 100p
Rc2(Ω) |  | 330 | 470 | 560 | 1150 |  | 102
Cc3(F) |  | 1500p | 1500p | 1500p | 1500p |  | 820p
ボード線図 |  | #VALUE! | #VALUE! | #VALUE! | #VALUE! |  | #VALUE!
Vout(ave) |  | 5.21V |  | 5.14
fsw |  | 309k |  | 307.8
Ven |  | 8.7 |  | 8.7
Vdis |  | 7.9 |  | 7.9
以下はVin=24V
Ilim(おおよそ) |  | 7.5 |  | 7.5
ΔVout(Iout=1A)
ΔVout(Iout=2.5A)
ΔVout(Iout=5A)
ΔIL(Iout=5A) |  | 測定不能
ΔVin(Iout=5A)
ΔIin(Iout=5A) |  | 分解能20mVでも測定不能
負荷変動時の過渡応答 （Iout = 1A --> 3.5A)
ΔVundershoot
負荷変動時の過渡応答 (Iout = 3.5A --> 1A)
ΔVovershoot
負荷変動時の過渡応答 （Iout = 1A --> 6A)
ΔVundershoot
負荷変動時の過渡応答 （Iout = 6A --> 1A)
ΔVovershoot
