rogy-AquaLab/sinsei_UMIUSI_pcb/LM25145_test/タイプ3位相補償設計/5.png

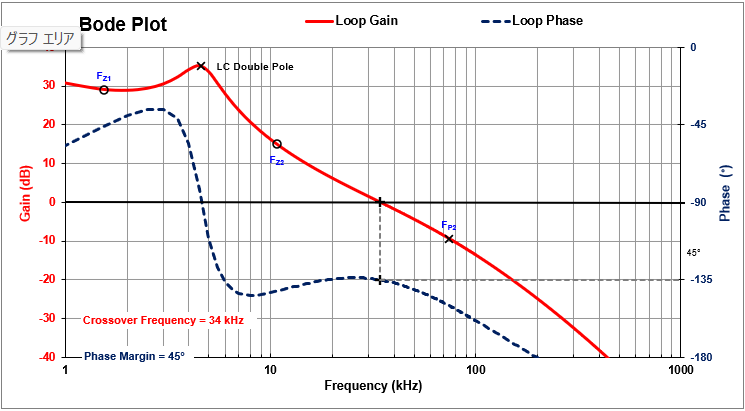
LM25145_test/タイプ3位相補償設計/5.png
