rogy-AquaLab/sinsei_UMIUSI_pcb/LM25145_test/タイプ3位相補償設計/過渡応答試験/1/1A ΔVout.jpg

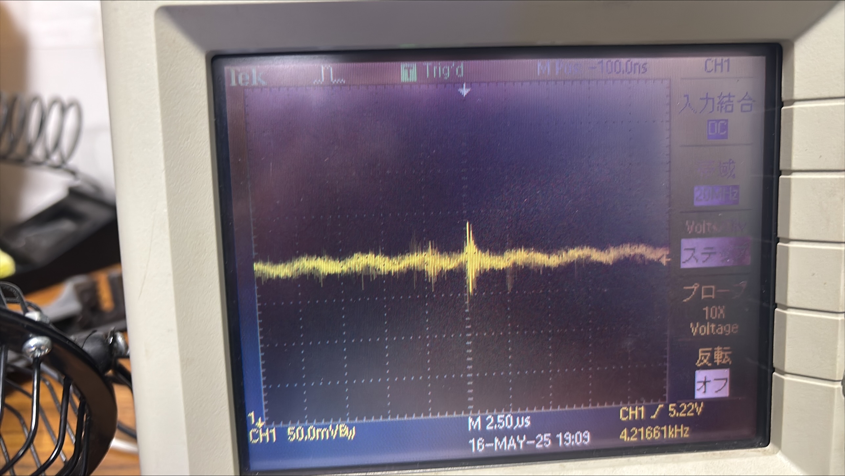
LM25145_test/タイプ3位相補償設計/過渡応答試験/1/1A ΔVout.jpg
