rogy-AquaLab/sinsei_UMIUSI_pcb/LM25145_test/タイプ3位相補償設計/過渡応答試験/OKL-T6-W12N-C/0 2.5.jpg

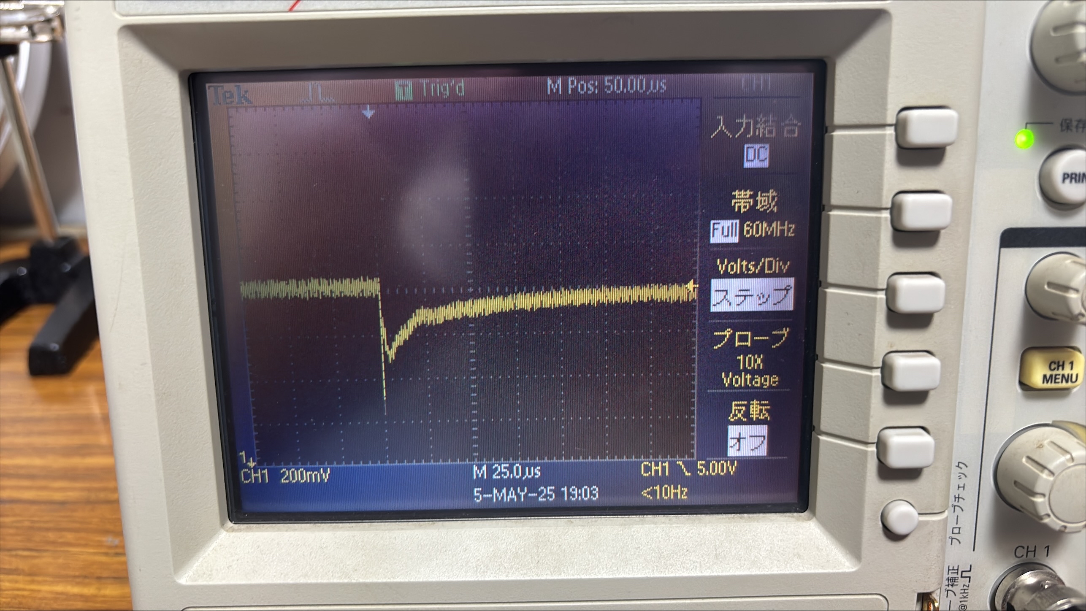
LM25145_test/タイプ3位相補償設計/過渡応答試験/OKL-T6-W12N-C/0 2.5.jpg
