rogy-AquaLab/sinsei_UMIUSI_pcb/(list of files, drawings)

Other design files:
AQUA_VESC/PSPICE/DRV8301.opj
AQUA_VESC/PSPICE/TK3R2E06PL.OLB
