rogy-AquaLab/sinsei_UMIUSI_pcb/back_connector_esc/back_connector_esc.kicad_pcb

## KiCad design back_connector_esc/back_connector_esc.kicad_pcb (2025-10-03)

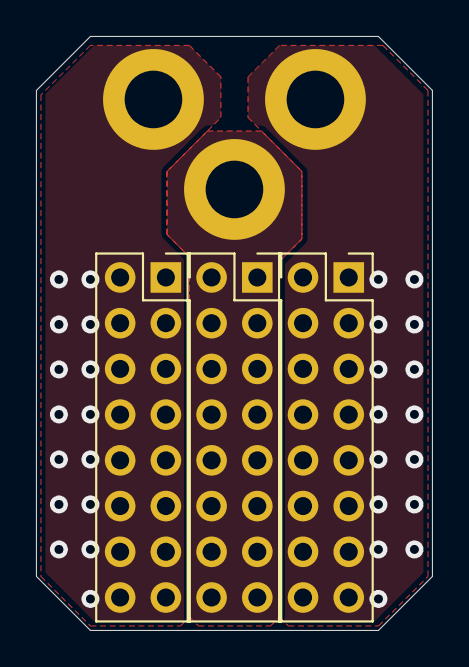
[picture p76: board back_connector_esc.kicad_pcb from above]

Board: 2 copper layers, 22.0 x 33.0 mm, 6 parts (0 on the bottom side), 3 nets, no tracks yet.

Parts:
H1, H2, H3: MountingHole_Pad; MountingHole_3.2mm_M3_DIN965_Pad
J2, J3, J4: Conn_02x08_Odd_Even; PinSocket_2x08_P2.54mm_Vertical

Connections:
PHASE1: H1.1, J2.1, J2.2, J2.3, J2.4, J2.5, J2.6, J2.7, J2.8, J2.9, J2.10, J2.11, J2.12, J2.13, J2.14, J2.15, J2.16
PHASE2: H2.1, J3.1, J3.2, J3.3, J3.4, J3.5, J3.6, J3.7, J3.8, J3.9, J3.10, J3.11, J3.12, J3.13, J3.14, J3.15, J3.16
PHASE3: H3.1, J4.1, J4.2, J4.3, J4.4, J4.5, J4.6, J4.7, J4.8, J4.9, J4.10, J4.11, J4.12, J4.13, J4.14, J4.15, J4.16
