rogy-AquaLab/sinsei_UMIUSI_pcb/can_connector/can_connector.kicad_pcb

## KiCad design can_connector/can_connector.kicad_pcb (2025-10-03)

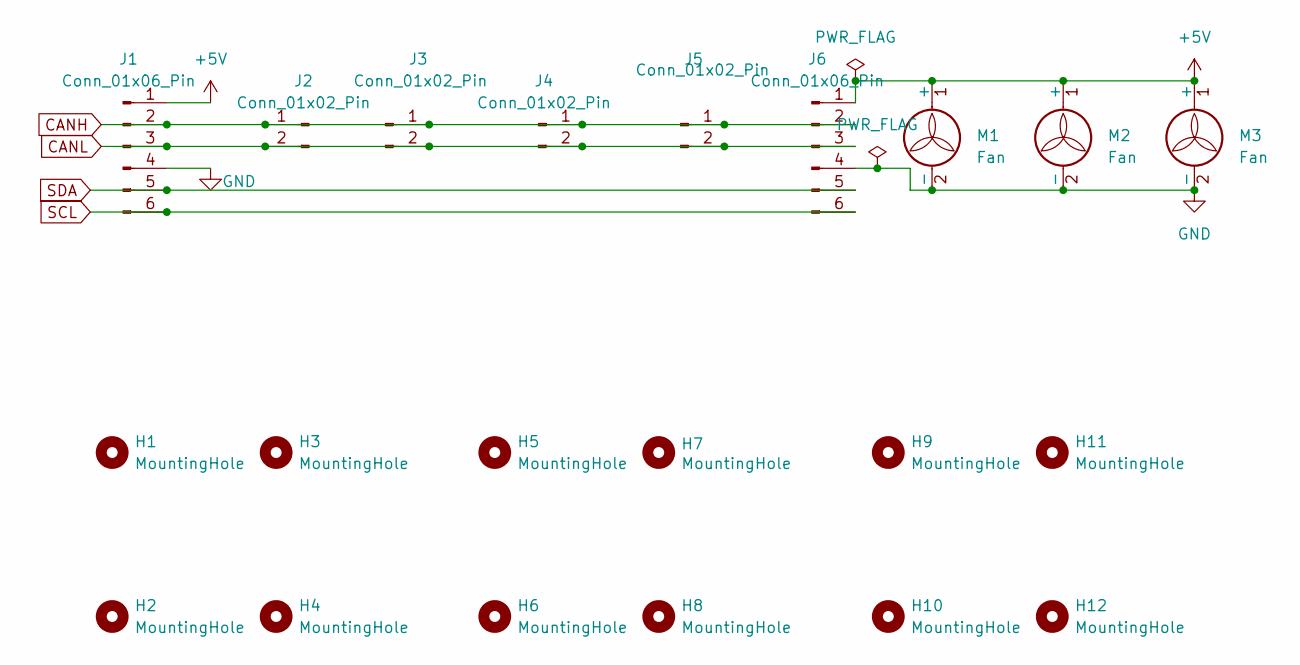
[picture p77: schematic can_connector.kicad_sch, can connector]

Parts:
H1, H2, H3, H4, H5, H6, H7, H8, H9, H10, H11, H12: MountingHole; MountingHole_3.2mm_M3
J1: Conn_01x06_Pin; PinHeader_1x06_P2.54mm_Vertical
J2, J3, J4, J5: Conn_01x02_Pin; PinHeader_1x02_P2.54mm_Vertical
J6: Conn_01x06_Pin; JST_XH_S6B-XH-A-1_1x06_P2.50mm_Horizontal
M1, M2, M3: Fan; PinHeader_1x02_P2.54mm_Vertical

Connections:
+5V: J1.1, J6.1, M1.1 (+), M2.1 (+), M3.1 (+)
CANH: J1.2, J2.1, J3.1, J4.1, J5.1, J6.2
CANL: J1.3, J2.2, J3.2, J4.2, J5.2, J6.3
GND: J1.4, J6.4, M1.2 (-), M2.2 (-), M3.2 (-)
SCL: J1.6, J6.6
SDA: J1.5, J6.5

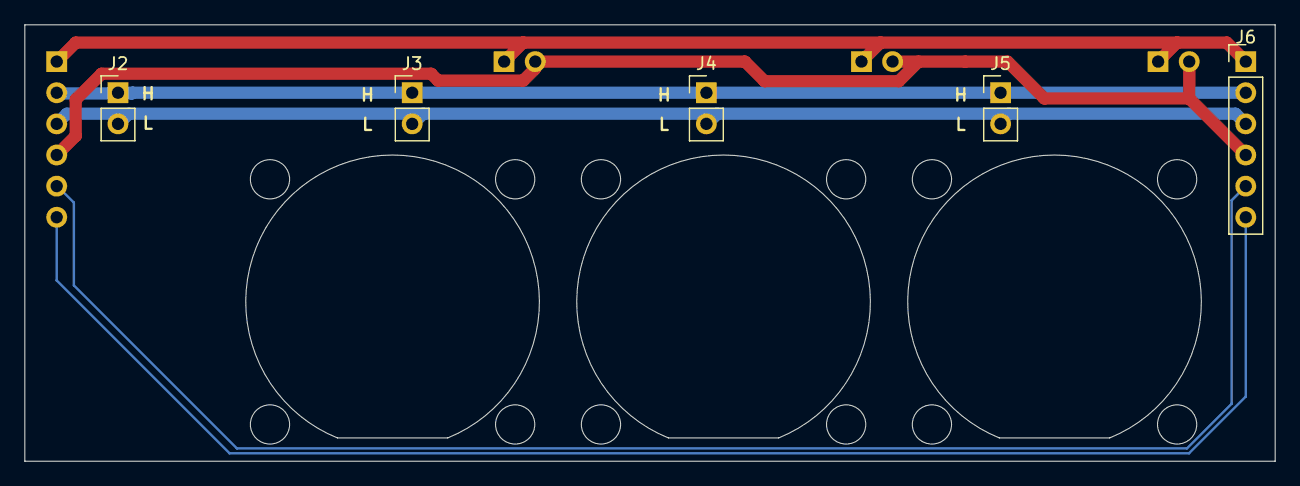
[picture p78: board can_connector.kicad_pcb from above]

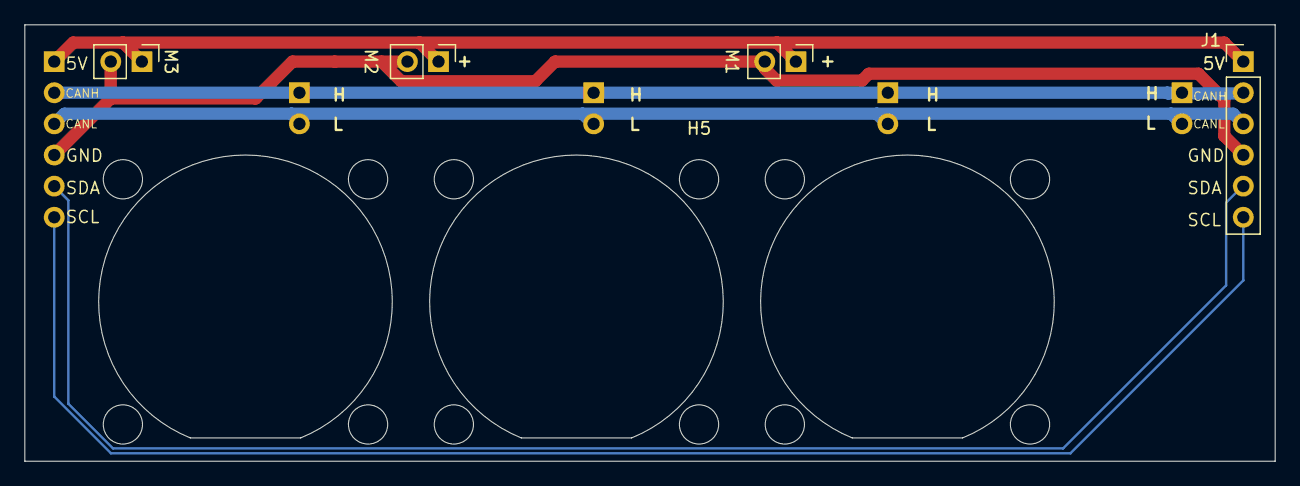
[picture p79: board can_connector.kicad_pcb from below]

Board: 2 copper layers, 102.0 x 35.6 mm, 21 parts (16 on the bottom side), 6 nets.
