rogy-AquaLab/sinsei_UMIUSI_pcb/back_connector_base/back_connector_base.kicad_pcb

## KiCad design back_connector_base/back_connector_base.kicad_pcb (2025-10-03)

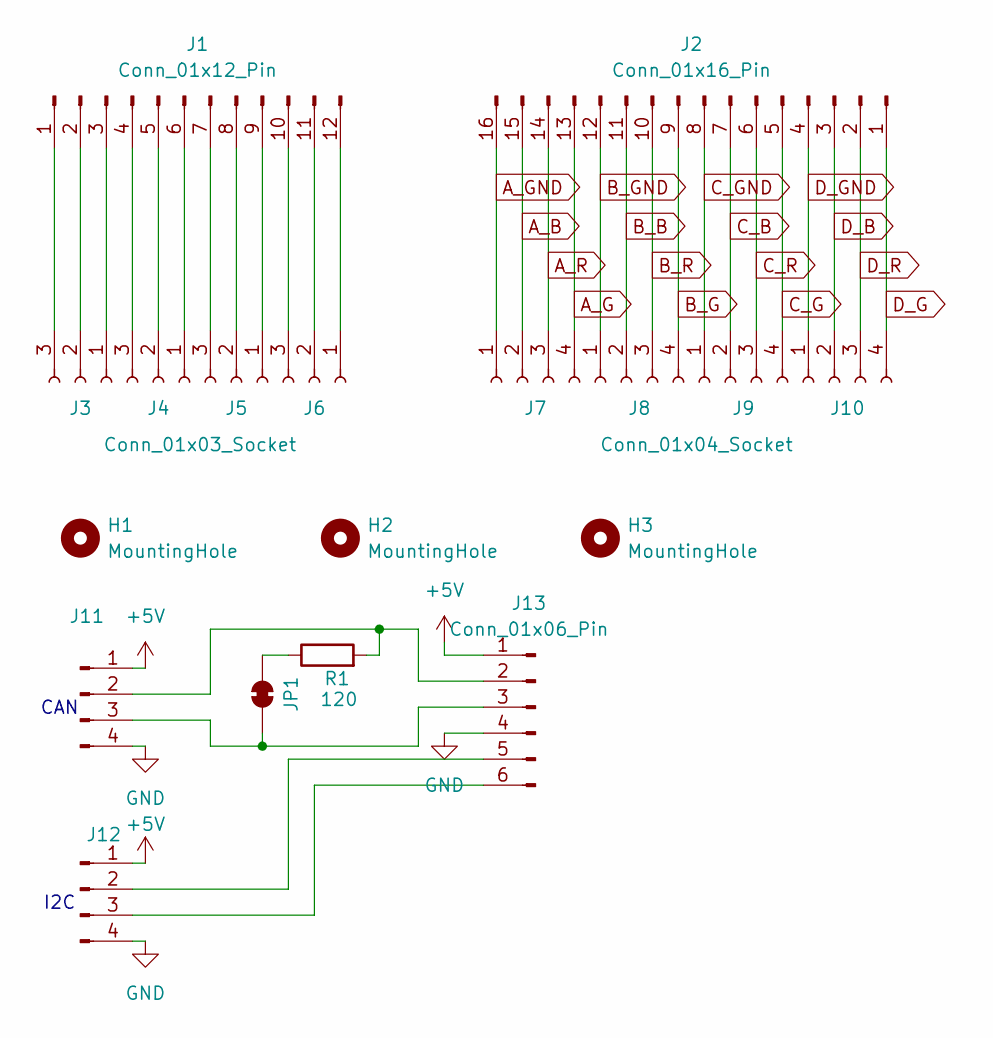
[picture p80: schematic back_connector_base.kicad_sch]

Parts:
H1, H2, H3: MountingHole; MountingHole_3.2mm_M3
J1: Conn_01x12_Pin; PinHeader_1x12_P2.54mm_Horizontal
J2: Conn_01x16_Pin; PinHeader_1x16_P2.54mm_Horizontal
J3, J4, J5, J6: Conn_01x03_Socket; PinSocket_1x03_P2.54mm_Vertical
J7, J8, J9, J10: Conn_01x04_Socket; PinSocket_1x04_P2.54mm_Vertical
J11, J12: Conn_01x04_Pin; JST_XH_B4B-XH-A_1x04_P2.50mm_Vertical
J13: Conn_01x06_Pin; JST_XH_B6B-XH-A_1x06_P2.50mm_Vertical
JP1: SolderJumper_2_Bridged; SolderJumper-2_P1.3mm_Bridged_RoundedPad1.0x1.5mm
R1: 120; R_Axial_DIN0207_L6.3mm_D2.5mm_P10.16mm_Horizontal

Connections:
+5V: J11.1, J12.1, J13.1
A_B: J2.15, J7.2
A_G: J2.13, J7.4
A_GND: J2.16, J7.1
A_R: J2.14, J7.3
B_B: J2.11, J8.2
B_G: J2.9, J8.4
B_GND: J2.12, J8.1
B_R: J2.10, J8.3
C_B: J2.7, J9.2
C_G: J2.5, J9.4
C_GND: J2.8, J9.1
C_R: J2.6, J9.3
D_B: J2.3, J10.2
D_G: J2.1, J10.4
D_GND: J2.4, J10.1
D_R: J2.2, J10.3
GND: J11.4, J12.4, J13.4
unnamed: J1.1, J3.3
unnamed: J1.2, J3.2
unnamed: J1.3, J3.1
unnamed: J1.4, J4.3
unnamed: J1.5, J4.2
unnamed: J1.6, J4.1
unnamed: J1.7, J5.3
unnamed: J1.8, J5.2
unnamed: J1.9, J5.1
unnamed: J1.10, J6.3
unnamed: J1.11, J6.2
unnamed: J1.12, J6.1
unnamed: J11.2, J13.2, R1.2
unnamed: J11.3, J13.3, JP1.2 (B)
unnamed: J12.2, J13.5
unnamed: J12.3, J13.6
unnamed: JP1.1 (A), R1.1

Notes on the sheet:
CAN
I2C

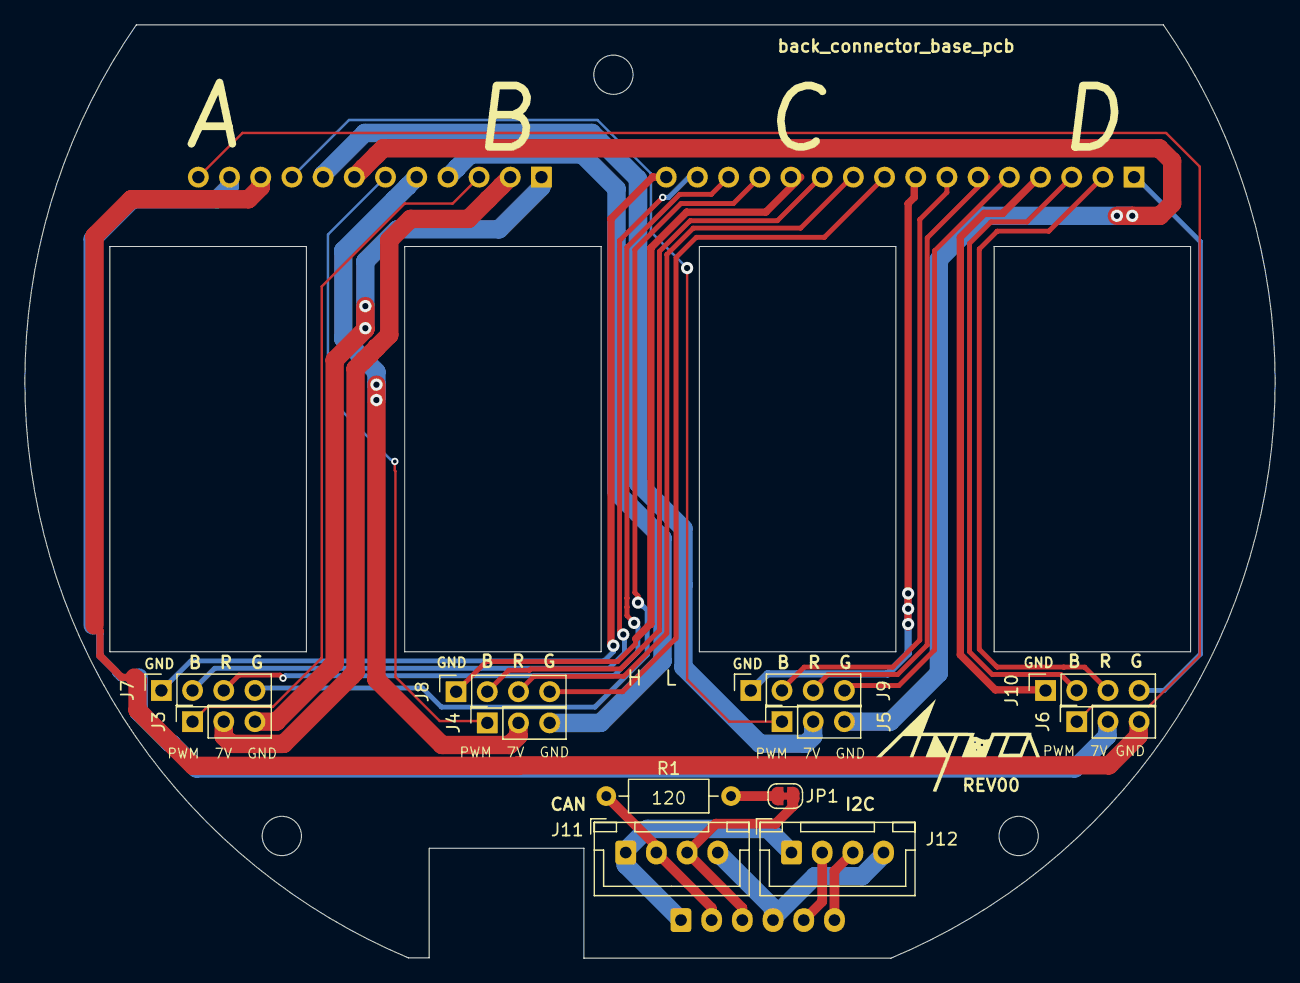
[picture p81: board back_connector_base.kicad_pcb from above]

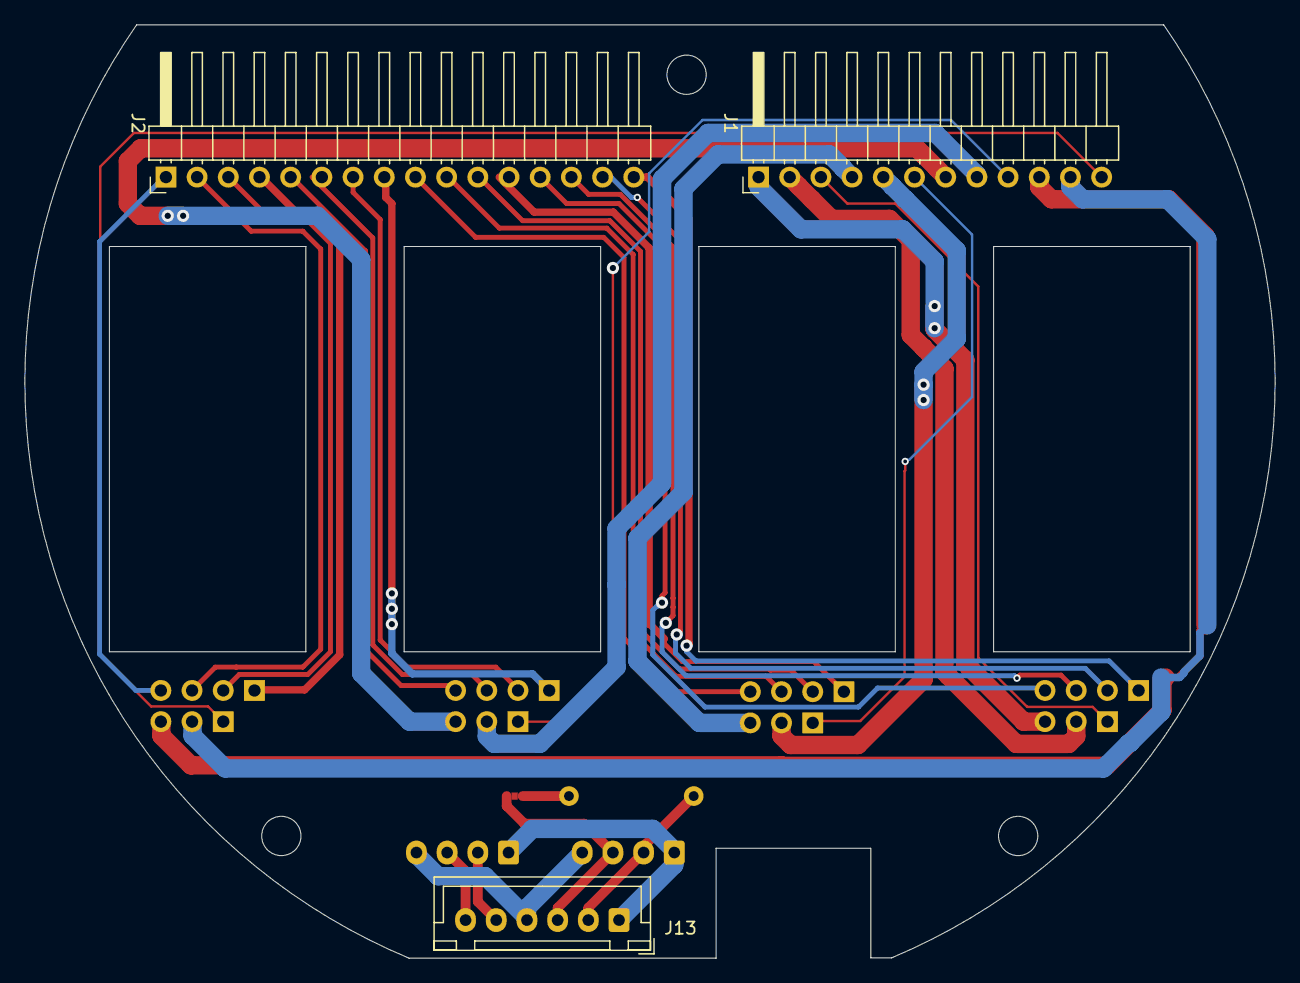
[picture p82: board back_connector_base.kicad_pcb from below]

Board: 2 copper layers, 101.8 x 76.0 mm, 18 parts (3 on the bottom side), 35 nets.
