rogy-AquaLab/sinsei_UMIUSI_pcb/AQUA_VESC/AQUA_VESC.kicad_pcb

## KiCad design AQUA_VESC/AQUA_VESC.kicad_pcb (2025-10-03)

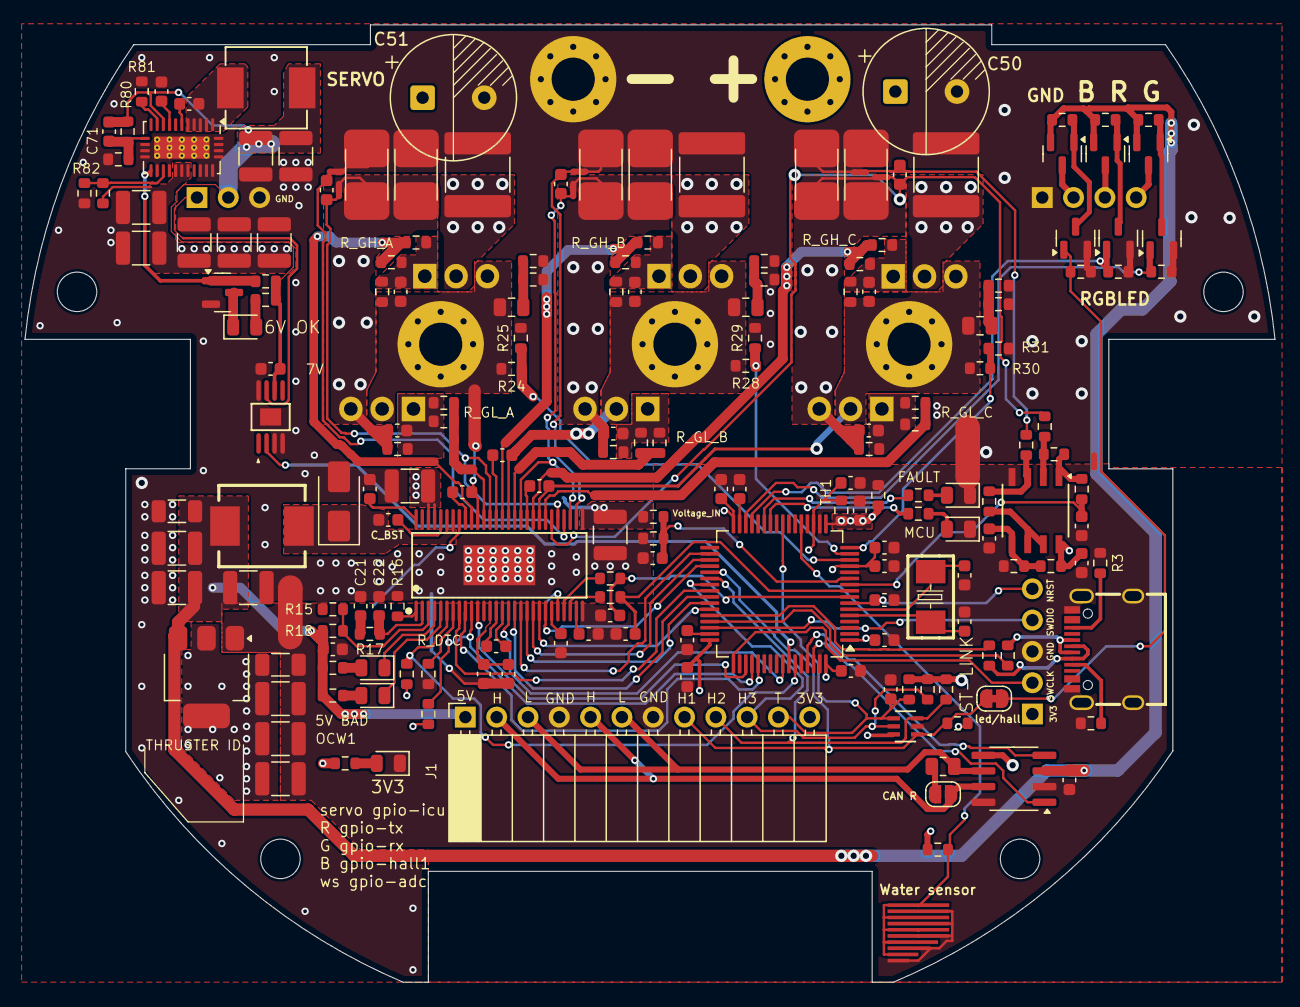
[picture p86: board AQUA_VESC.kicad_pcb from above]

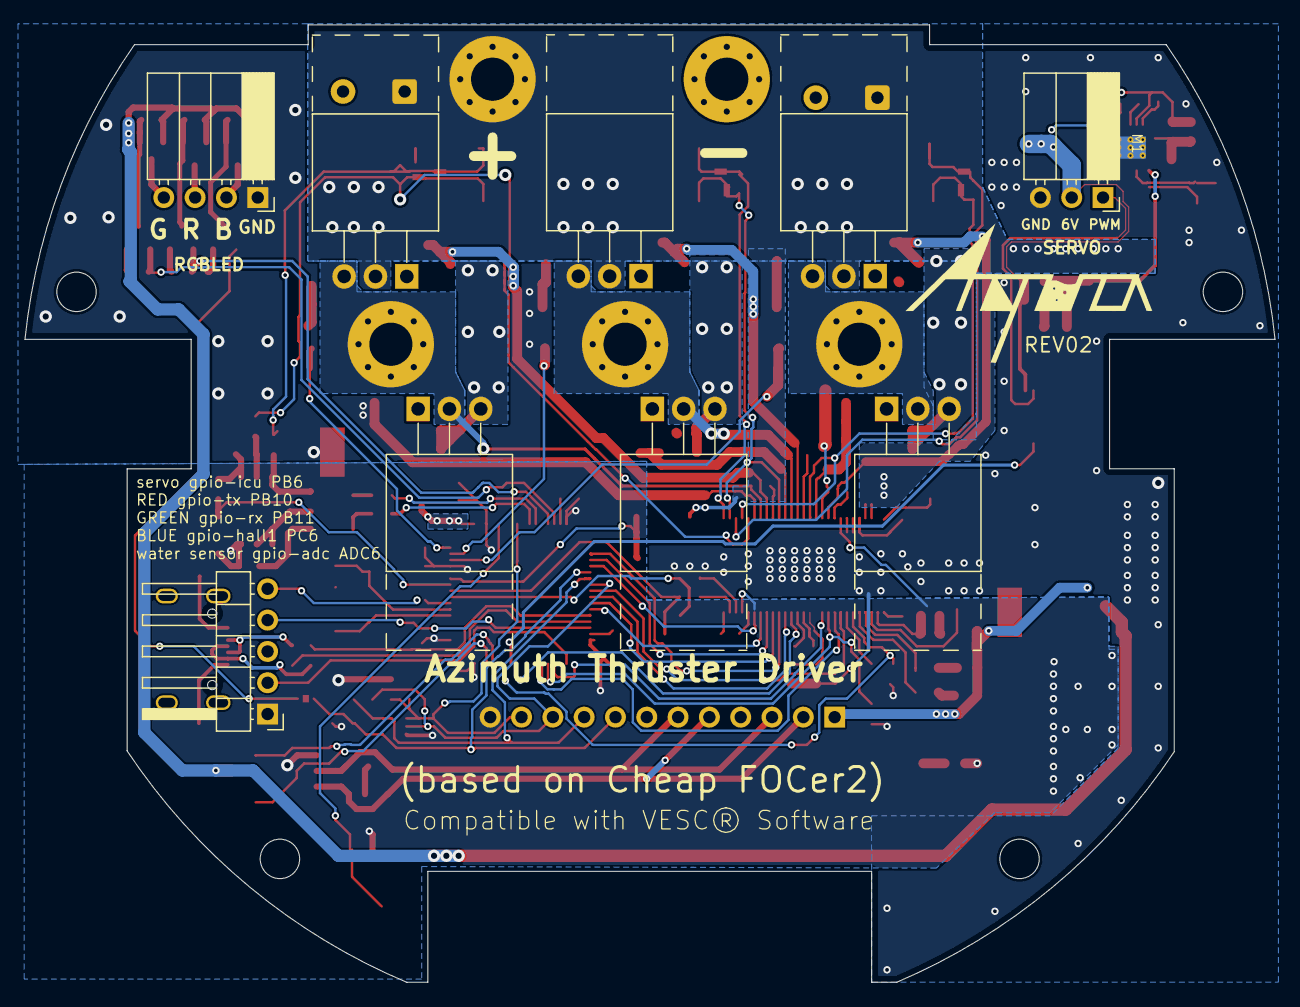
[picture p87: board AQUA_VESC.kicad_pcb from below]

Board: 2 copper layers, 101.4 x 77.7 mm, 213 parts (9 on the bottom side), 128 nets.

Parts:
5V1, 6V_OK1: YELLOW; LED_0805_2012Metric
C1, C2, C4, C5, C6, C7, C8, C10, C15, C16, C25, C44, C46: 100n; C_0603_1608Metric
C3: 4.7u; C_0603_1608Metric
C9, C62: 1u; C_0603_1608Metric
C11, C12: 15p; C_0603_1608Metric
C13, C14, C32, C33, C36, C41, C52, C72: 2.2u; C_0603_1608Metric
C17, C26: 2.2u; C_1206_3216Metric
C18, C19, C20, C27, C28, C29, C69, C70: 22u; C_1210_3225Metric
C21: 6.8n; C_0603_1608Metric
C22: 150p; C_0603_1608Metric
C23, C53, C54, C55, C59, C60, C61: 10n; C_0603_1608Metric
C24, C42, C63, C64, C65, C66, C67: 4.7u, 100V; C_1210_3225Metric
C30, C34, C35: 220n; C_0603_1608Metric
C31: 22n; C_0603_1608Metric
C37, C38, C39, C40, C43, C45: 1n; C_0603_1608Metric
C47, C48, C49: 10uF, 100V; C_2220_5750Metric
C50, C51: 330u; CP_Radial_D10.0mm_P5.00mm_nofill
C56, C57, C58: 4.7n, 100V; C_0805_2012Metric
C68: 0.47u; C_0603_1608Metric
C71: 12p; C_0603_1608Metric
D1: RED; LED_0805_2012Metric
D2: WHITE; LED_0805_2012Metric
D3: EMERALD; LED_0805_2012Metric
D4: SS210; D_SMA
H1, H6, H7, H8, H9: MountingHole_Pad; MountingHole_3.5mm_Pad_Via
H2, H3, H4, H5: MountingHole; MountingHole_3.2mm_M3
J1: Conn_01x12_Socket; PinSocket_1x12_P2.54mm_Horizontal
J2: Conn_01x05_Pin; PinHeader_1x05_P2.54mm_Horizontal
JP1: SolderJumper_2_Bridged; SolderJumper-2_P1.3mm_Bridged_RoundedPad1.0x1.5mm
JP2: SolderJumper_2_Open; SolderJumper-2_P1.3mm_Open_RoundedPad1.0x1.5mm
M1: Motor_Servo_Hitec; PinSocket_1x03_P2.54mm_Horizontal
NT1, NT2: NetTie_2; NetTie-2_SMD_Pad2.0mm
NT3, NT4, NT5, NT6, NT7, NT8, NT9: NetTie_2; NetTie-2_SMD_Pad0.5mm
OCW1: RED; LED_0805_2012Metric
Q1, Q2, Q3, Q4, Q5, Q6: TK3R2E06PL; TO-220-3_Horizontal_TabUp_no_hole
Q7, Q8, Q9: AO3401A; SOT-23
Q10, Q11, Q12, Q13: 2N7002; SOT-23
R1, R24, R28, R30: 39k; R_0603_1608Metric
R2, R7, R8, R9, R25, R29, R31: 2.2k; R_0603_1608Metric
R3, R6: 5.1k; R_0603_1608Metric
R4, R5: 22; R_0603_1608Metric
R10, R21, R22, R34, R37, R39, R70, R71, R72, R73, R74, R75: 10k; R_0603_1608Metric
R11, R77, R80: 100k; R_0603_1608Metric
R12, R13, R14: 100; R_0603_1608Metric
R15: 3.3k; R_0603_1608Metric
R16: 220k; R_0603_1608Metric
R17, R33, R38, R82: 20k; R_0603_1608Metric
R18: 18k; R_0603_1608Metric
R19, R20, R23, R26, R27, R32, R35, R36: 1k; R_0603_1608Metric
R40, R41, R42, R43, R44, R45, R49, R50, R51, R52, R53, R54, R55, R56, R57, R58, R59, R60: 10; R_0603_1608Metric
R46, R47, R48, R61, R62, R63: 4.7k; R_0603_1608Metric
R64, R65, R66, R67, R68, R69: 1mΩ; R_2512_Yageo_big_pads
R76: 390; R_0603_1608Metric
R78: 15k; R_0603_1608Metric
R79: 51k; R_0603_1608Metric
R81: 82k; R_0603_1608Metric
RGBLED1: Conn_01x04_Pin; PinSocket_1x04_P2.54mm_Horizontal
R_can_termination1: 120; R_0805_2012Metric
TH1: Thermistor_NTC; R_0603_1608Metric
U1: SMF05CT1G; SOT-363-6_2P2X1P35_ONS
U2: wetness sensor
U3: STM32F405RGTx; LQFP-64_10x10mm_P0.5mm
U4: TJA1051T-3; SOIC-8_3.9x4.9mm_P1.27mm
U5: AMS1117-3.3; SOT-223-3_TabPin2
U6: DRV8301QDCAQ1; HTSSOP-56_L14.0-W6.0-P0.50-LS8.0-BL
U7: 22uH; IND-SMD_L7.0-W6.6
U8: TP2604-SR; SO-8SOIC-8_TPK
U9: MX27524ES; EMSOP-8_L3.0-W3.0-P0.65-LS4.9-BL-EP
U10: 15uH; IND-SMD_L7.1-W6.6
U11: LM76002; Texas_RNP0030B_WQFN-30-1EP_4x6mm_P0.5mm_EP1.8x4.5mm_Thermal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
USB1: TYPEC; USB-C_SMD-TYPE-C-31-M-12
X1: 8MHz; CRYSTAL-SMD_L5.0-W3.2

Connections:
+3V3: C3.1, C4.1, C5.1, C6.1, C7.1, C8.1, C9.1, C17.1, C18.1, C19.1, C20.1, C44.1, J1.12, J2.1, R7.1, R8.1, R9.1, R10.1, R11.2, R14.1, R21.1, R23.1, R34.1, TH1.1, U1.6 (CATHODE), U3.1 (VBAT), U3.13 (VDDA), U3.19 (VDD), U3.32 (VDD), U3.48 (VDD), U3.64 (VDD), U4.5 (VIO), U5.2 (VO), U6.24 (REF), U6.49 (VDD_SPI), U8.8 (+VS)
+5V: C15.1, C16.1, C26.1, C27.1, C28.1, C29.1, J1.1, Q7.2 (S), Q8.2 (S), Q9.2 (S), R18.2, R19.1, R20.1, R70.2, R71.2, R72.2, U4.3 (VCC), U5.3 (VI), U7.2
+6V: C62.1, C69.1, C70.1, C71.2, M1.2 (+), R76.1, R79.1, R80.2, U9.6 (VCC), U10.2, U11.9 (BIAS)
/CAN/CANH: J1.2, J1.5, JP2.2 (B), U4.7 (CANH)
/CAN/CANL: J1.3, J1.6, R_can_termination1.2, U4.6 (CANL)
/CAN/CAN_RX: U3.61 (PB8), U4.4 (RXD)
/CAN/CAN_TX: U3.62 (PB9), U4.1 (TXD)
/DRV8301/BR_SO1: C38.1, R26.2, U3.8 (PC0)
/DRV8301/BR_SO2: C39.1, R27.2, U3.9 (PC1)
/DRV8301/BR_SO3: C43.1, R32.1, U3.10 (PC2)
/DRV8301/CS: U3.40 (PC9), U6.8 (*SCS)
/DRV8301/EN_GATE: U3.57 (PB5), U6.16 (EN_GATE)
/DRV8301/FAULT: R21.2, U3.59 (PB7), U6.6 (*FAULT)
/DRV8301/GH_A: R40.1, R43.1, U6.47 (GH_A)
/DRV8301/GH_B: R41.1, R44.1, U6.42 (GH_B)
/DRV8301/GH_C: R42.1, R45.1, U6.37 (GH_C)
/DRV8301/GL_A: R49.1, R52.1, U6.45 (GL_A)
/DRV8301/GL_B: R50.1, R53.1, U6.40 (GL_B)
/DRV8301/GL_C: R51.1, R54.1, U6.35 (GL_C)
/DRV8301/H1: U3.41 (PA8), U6.17 (INH_A)
/DRV8301/H1_LOW: C37.2, NT4.1, U6.33 (SN1), U6.44 (SL_A)
/DRV8301/H1_VS: C30.2, C53.2, C56.1, H7.1, Q1.3 (S), Q4.2 (D), R24.2, R46.2, U6.46 (SH_A)
/DRV8301/H2: U3.42 (PA9), U6.19 (INH_B)
/DRV8301/H2_LOW: C40.2, NT5.1, U6.31 (SN2), U6.39 (SL_B)
/DRV8301/H2_VS: C34.2, C54.2, C57.1, H8.1, Q2.3 (S), Q5.2 (D), R28.2, R47.2, U6.41 (SH_B)
/DRV8301/H3: U3.43 (PA10), U6.21 (INH_C)
/DRV8301/H3_LOW: C45.1, NT6.1, R35.1, U6.34 (SL_C)
/DRV8301/H3_VS: C35.2, C55.2, C58.1, H9.1, Q3.3 (S), Q6.2 (D), R30.2, R48.2, U6.36 (SH_C)
/DRV8301/L1: U3.34 (PB13), U6.18 (INL_A)
/DRV8301/L2: U3.35 (PB14), U6.20 (INL_B)
/DRV8301/L3: U3.36 (PB15), U6.22 (INL_C)
/DRV8301/SCLK: U3.51 (PC10), U6.11 (SCLK)
/DRV8301/SDI: U3.53 (PC12), U6.9 (SDI)
/DRV8301/SDO: R23.2, U3.52 (PC11), U6.10 (SDO)
/DRV8301/SENS1: R24.1, R25.1, U3.14 (PA0)
/DRV8301/SENS2: R28.1, R29.1, U3.15 (PA1)
/DRV8301/SENS3: R30.1, R31.1, U3.16 (PA2)
/DRV8301/SPA: C37.1, NT7.1, U6.32 (SP1)
/DRV8301/SPB: C40.1, NT8.1, U6.30 (SP2)
/DRV8301/SPC: C45.2, NT9.1, R36.1
/Power MOSFETs/TEMP: C52.1, R39.1, TH1.2, U3.17 (PA3)
/RGBLED_Driver/BLUE_OUT: Q9.3 (D), RGBLED1.2
/RGBLED_Driver/GREEN_GATE: Q11.1 (G), R74.1, U3.30 (PB11)
/RGBLED_Driver/GREEN_OUT: Q8.3 (D), RGBLED1.4
/RGBLED_Driver/RED_GATE: Q10.1 (G), R73.1, U3.29 (PB10)
/RGBLED_Driver/RED_OUT: Q7.3 (D), RGBLED1.3
/SERVO/SERVO_PWM: U3.58 (PB6), U9.2 (INA)
/STM32F405/ADC_EXT: R11.1, U2.1 (A), U3.21 (PA5)
/STM32F405/AN_IN: C1.1, R1.2, R2.1, U3.11 (PC3)
/STM32F405/HALL_1: J1.8, JP1.1 (A), R7.2, U1.1 (CATHODE), U3.37 (PC6)
/STM32F405/HALL_2: J1.9, R8.2, U1.3 (CATHODE), U3.38 (PC7)
/STM32F405/HALL_3: J1.10, R9.2, U1.5 (CATHODE), U3.39 (PC8)
/STM32F405/LED_GREEN: R13.1, U3.26 (PB0)
/STM32F405/LED_RED: R12.1, U3.27 (PB1)
/STM32F405/TEMP_MOTER: C2.1, J1.11, R10.2, U1.4 (CATHODE), U3.24 (PC4)
/STM32F405/USB_DM: R4.1, U3.44 (PA11)
/STM32F405/USB_DP: R5.1, U3.45 (PA12)
BLUE_GATE: JP1.2 (B), Q12.1 (G), R75.1
GNDD: C2.2, C3.2, C4.2, C5.2, C6.2, C7.2, C8.2, C9.2, C10.2, C11.2, C12.2, C13.2, C14.2, C15.2, C16.2, C17.2, C18.2, C19.2, C20.2, C36.1, C38.2, C39.2, C41.2, C43.2, C44.2, C46.2, C52.2, D1.1 (K), D2.1 (K), D3.1 (K), J1.4, J1.7, J2.3, NT1.1, NT2.1, NT3.1, R3.1, R6.2, R22.1, R37.2, R39.2, U1.2 (ANODE), U2.2 (B), U3.12 (VSSA), U3.18 (VSS), U3.60 (BOOT0), U3.63 (VSS), U4.2 (GND), U4.8 (S), U5.1 (GND), U6.28 (AGND), U8.4 (-VS), USB1.0 (SH), USB1.1 (SH), USB1.2 (SH), USB1.3 (SH), USB1.A1 (GND), USB1.A12 (GND), USB1.B1 (GND), USB1.B12 (GND)
GNDPWR: C1.2, C21.1, C22.1, C23.2, C24.2, C26.2, C27.2, C28.2, C29.2, C32.2, C33.2, C42.2, C47.2, C48.2, C49.2, C50.2, C51.2, C62.2, C63.2, C64.2, C65.2, C66.2, C67.2, C69.2, C70.2, C72.2, D4.2 (A), H6.1, M1.3 (-), NT1.2, NT2.2, NT3.2, NT7.2, NT8.2, NT9.2, Q10.2 (S), Q11.2 (S), Q12.2 (S), Q13.2 (S), R2.2, R15.1, R16.1, R25.2, R29.2, R31.2, R55.1, R56.1, R57.1, R58.1, R59.1, R60.1, R64.1, R65.1, R66.1, R67.1, R68.1, R69.1, R73.2, R74.2, R75.2, R78.2, R81.1, R82.2, RGBLED1.1, U6.57 (EPAD), U9.3 (GND), U9.4 (INB), U9.8 (ENB), U9.9 (EP), U11.13 (AGND), U11.14 (AGND), U11.15 (AGND), U11.17 (SYNC/MODE), U11.19 (NC_{GND}), U11.24 (PGND), U11.25 (PGND), U11.26 (PGND), U11.27 (NC_{GND}), U11.28 (NC_{GND}), U11.29 (NC_{GND}), U11.30 (NC_{GND}), U11.31 (AGND)
NRST: C10.1, J2.5, U3.7 (NRST)
unnamed: 5V1.2 (A), R19.2
unnamed: 5V1.1 (K), U6.4 (PWRGD)
unnamed: 6V_OK1.2 (A), R76.2
unnamed: 6V_OK1.1 (K), Q13.3 (D)
unnamed: C21.2, R17.1
unnamed: C56.2, R55.2, R56.2
unnamed: C57.2, R57.2, R58.2
unnamed: C58.2, R59.2, R60.2
unnamed: C68.2, U10.1, U11.1 (SW), U11.2 (SW), U11.3 (SW), U11.4 (SW), U11.5 (SW)
unnamed: D1.2 (A), R12.2
unnamed: D2.2 (A), R13.2
unnamed: D3.2 (A), R14.2
unnamed: C25.2, D4.1 (K), U6.50 (PH), U6.51 (PH), U7.1
unnamed: JP2.1 (A), R_can_termination1.1
unnamed: M1.1 (PWM), U9.7 (OUTA)
unnamed: OCW1.2 (A), R20.2
unnamed: OCW1.1 (K), U6.5 (*OCTW)
unnamed: C53.1, Q1.1 (G), R40.2, R43.2, R46.1
unnamed: C54.1, Q2.1 (G), R41.2, R44.2, R47.1
unnamed: C55.1, Q3.1 (G), R42.2, R45.2, R48.1
unnamed: C59.1, Q4.1 (G), R49.2, R52.2, R61.1
unnamed: C59.2, NT4.2, Q4.3 (S), R61.2, R64.2, R65.2
unnamed: C60.1, Q5.1 (G), R50.2, R53.2, R62.1
unnamed: C60.2, NT5.2, Q5.3 (S), R62.2, R66.2, R67.2
unnamed: C61.1, Q6.1 (G), R51.2, R54.2, R63.1
unnamed: C61.2, NT6.2, Q6.3 (S), R63.2, R68.2, R69.2
unnamed: Q7.1 (G), Q10.3 (D), R70.1
unnamed: Q8.1 (G), Q11.3 (D), R71.1
unnamed: Q9.1 (G), Q12.3 (D), R72.1
unnamed: Q13.1 (G), R79.2, U11.16 (PGOOD)
unnamed: C11.1, U3.5 (PH0), X1.2 (OSC2)
unnamed: C12.1, U3.6 (PH1), X1.1 (OSC1)
unnamed: C13.1, U3.31 (VCAP_1)
unnamed: C14.1, U3.47 (VCAP_2)
unnamed: C41.1, U6.27 (AVDD)
unnamed: C30.1, U6.48 (BST_A)
unnamed: C34.1, U6.43 (BST_B)
unnamed: C25.1, U6.52 (BST_BK)
unnamed: C35.1, U6.38 (BST_C)
unnamed: C22.2, R17.2, U6.2 (COMP)
unnamed: C31.2, U6.14 (CP1)
unnamed: C31.1, U6.15 (CP2)
unnamed: R22.2, U6.7 (DTC)
unnamed: C36.2, U6.23 (DVDD)
unnamed: C32.1, C33.1, U6.13 (GVDD)
unnamed: R16.2, U6.1 (RT_CLK)
unnamed: R26.1, U6.25 (SO1)
unnamed: R27.1, U6.26 (SO2)
unnamed: C23.1, U6.56 (SS_TR)
unnamed: R15.2, R18.1, U6.3 (VSENSE)
unnamed: R36.2, R38.1, U8.3 (+INA)
unnamed: C46.1, R34.2, R37.1, U8.5 (+INB)
unnamed: R33.1, R35.2, U8.2 (-INA)
unnamed: R38.2, U8.6 (-INB), U8.7 (OUTB)
unnamed: R32.2, R33.2, U8.1 (OUTA)
unnamed: C68.1, U11.6 (BOOT)
unnamed: R77.2, R78.1, U11.18 (EN)
unnamed: C71.1, R80.1, R82.1, U11.12 (FB)
unnamed: R81.2, U11.10 (RT)
unnamed: C72.1, U11.8 (VCC)
unnamed: R6.1, USB1.A5 (CC1)
unnamed: R3.2, USB1.B5 (CC2)
SWCLK: J2.2, U3.49 (PA14)
SWDIO: J2.4, U3.46 (PA13)
USB_D+: R5.2, USB1.A6 (DP1), USB1.B6 (DP2)
USB_D-: R4.2, USB1.A7 (DN1), USB1.B7 (DN2)
V_SUPPLY: C24.1, C42.1, C47.1, C48.1, C49.1, C50.1, C51.1, C63.1, C64.1, C65.1, C66.1, C67.1, H1.1, Q1.2 (D), Q2.2 (D), Q3.2 (D), R1.1, R77.1, U6.29 (PVDD1), U6.53 (PVDD2), U6.54 (PVDD2), U11.20 (PVIN), U11.21 (PVIN), U11.22 (PVIN)
