rogy-AquaLab/sinsei_UMIUSI_pcb/AQUA_VESC-to-relay-pcb/AQUA_VESC-to-relay-pcb.kicad_pcb

## KiCad design AQUA_VESC-to-relay-pcb/AQUA_VESC-to-relay-pcb.kicad_pcb (2025-10-03)

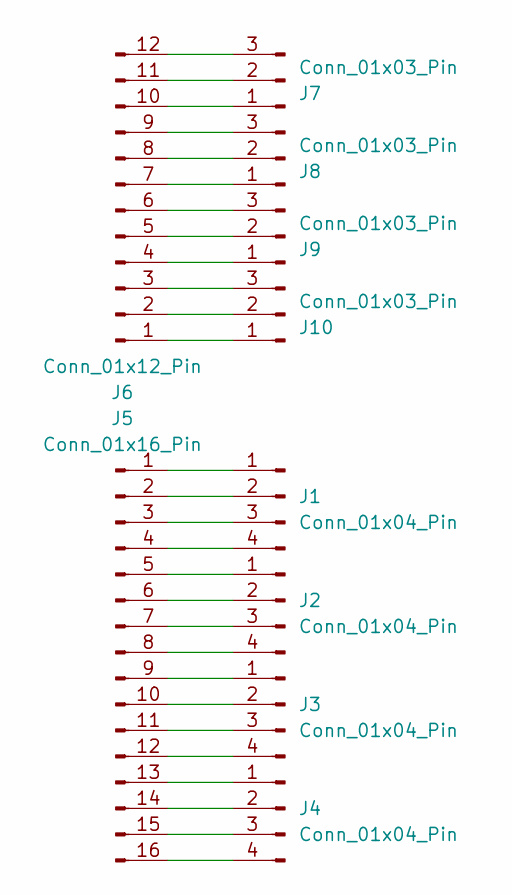
[picture p88: schematic AQUA_VESC-to-relay-pcb.kicad_sch]

Parts:
J1, J2, J3, J4: Conn_01x04_Pin; PinHeader_1x04_P2.54mm_Vertical
J5: Conn_01x16_Pin; PinSocket_1x16_P2.54mm_Vertical
J6: Conn_01x12_Pin; PinSocket_1x12_P2.54mm_Vertical
J7, J8, J9, J10: Conn_01x03_Pin; PinHeader_1x03_P2.54mm_Vertical

Connections:
unnamed: J1.1, J5.1
unnamed: J1.2, J5.2
unnamed: J1.3, J5.3
unnamed: J1.4, J5.4
unnamed: J2.1, J5.5
unnamed: J2.2, J5.6
unnamed: J2.3, J5.7
unnamed: J2.4, J5.8
unnamed: J3.1, J5.9
unnamed: J3.2, J5.10
unnamed: J3.3, J5.11
unnamed: J3.4, J5.12
unnamed: J4.1, J5.13
unnamed: J4.2, J5.14
unnamed: J4.3, J5.15
unnamed: J4.4, J5.16
unnamed: J6.4, J9.1
unnamed: J6.5, J9.2
unnamed: J6.6, J9.3
unnamed: J6.7, J8.1
unnamed: J6.8, J8.2
unnamed: J6.9, J8.3
unnamed: J6.10, J7.1
unnamed: J6.11, J7.2
unnamed: J6.12, J7.3
unnamed: J6.1, J10.1
unnamed: J6.2, J10.2
unnamed: J6.3, J10.3

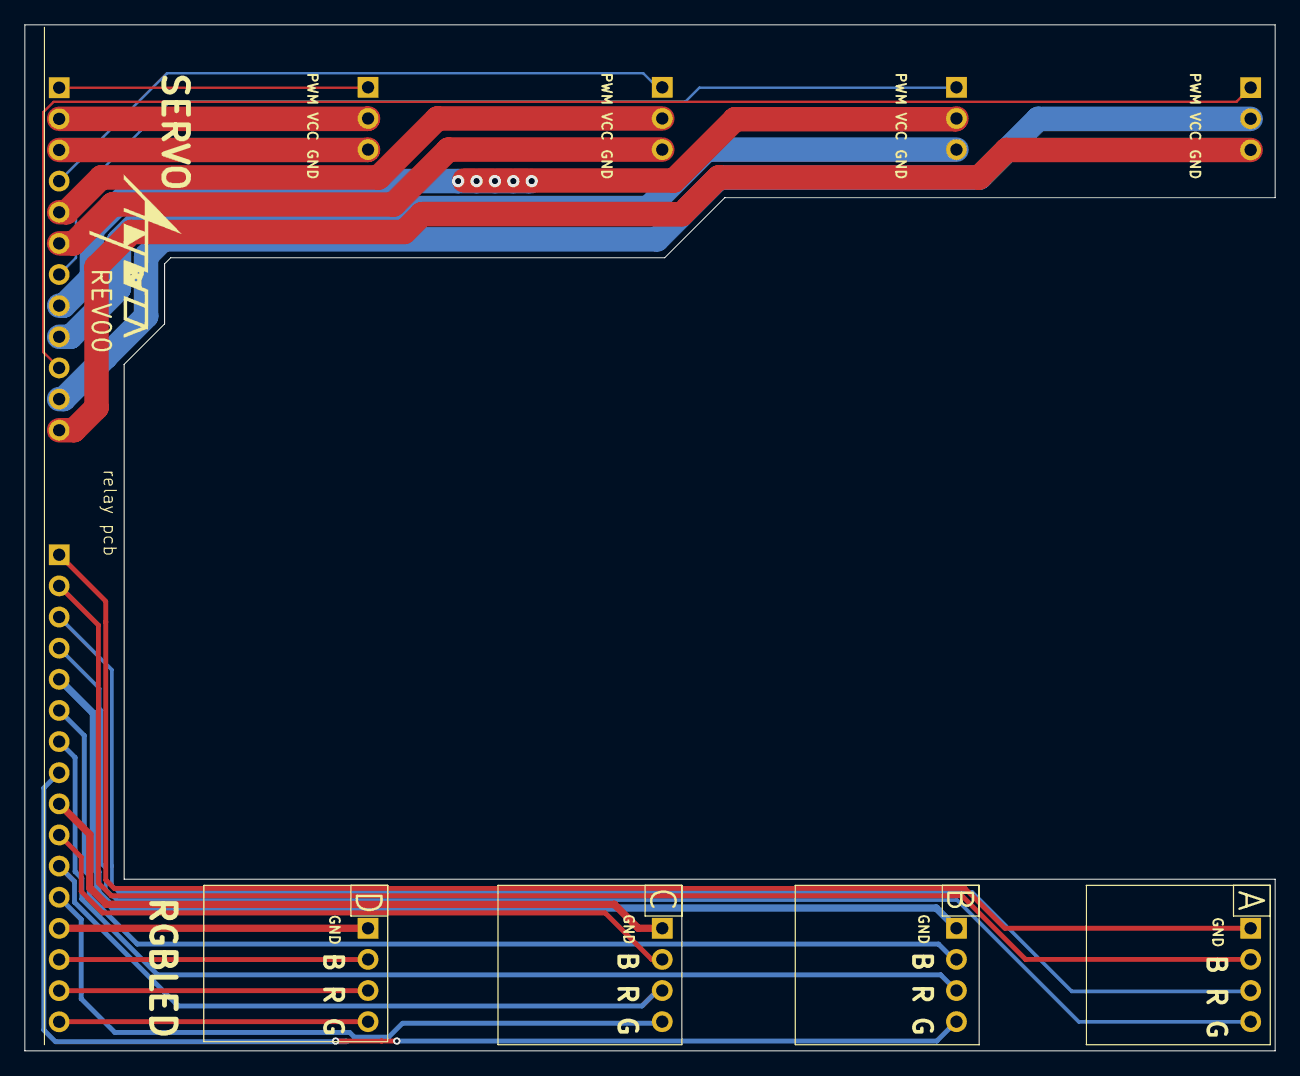
[picture p89: board AQUA_VESC-to-relay-pcb.kicad_pcb from above]

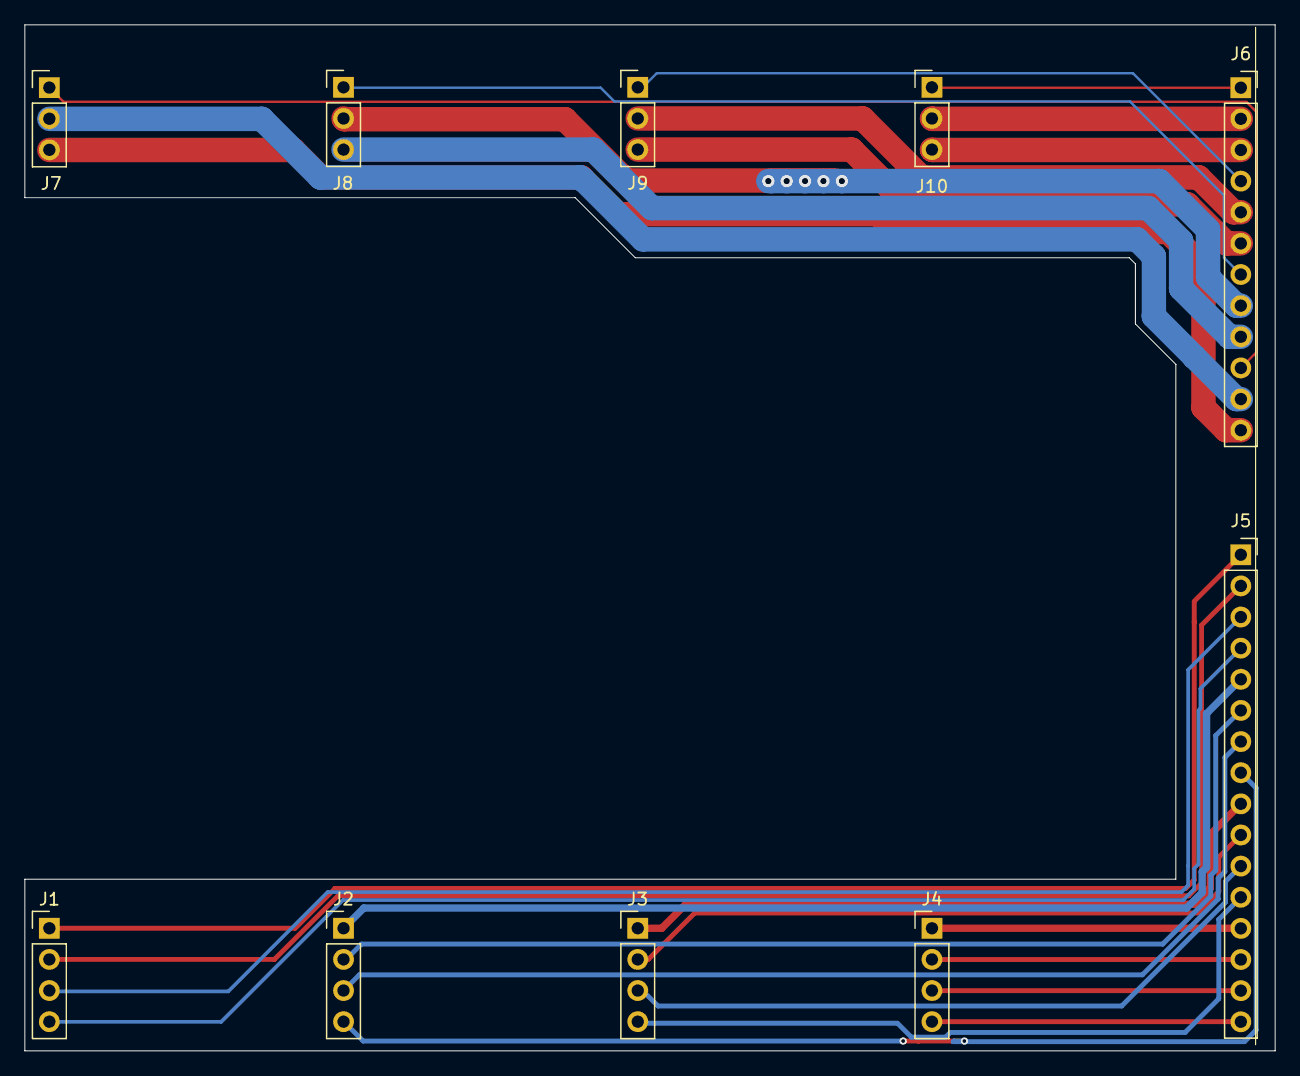
[picture p90: board AQUA_VESC-to-relay-pcb.kicad_pcb from below]

Board: 2 copper layers, 102.0 x 83.7 mm, 10 parts (10 on the bottom side), 28 nets.
