rogy-AquaLab/sinsei_UMIUSI_pcb/pcb_connector_old/pcb_connector_azimuth_thruster/pcb_connector_azimuth_thruster.kicad_pcb

## KiCad design pcb_connector_old/pcb_connector_azimuth_thruster/pcb_connector_azimuth_thruster.kicad_pcb (2025-08-26, an earlier design)

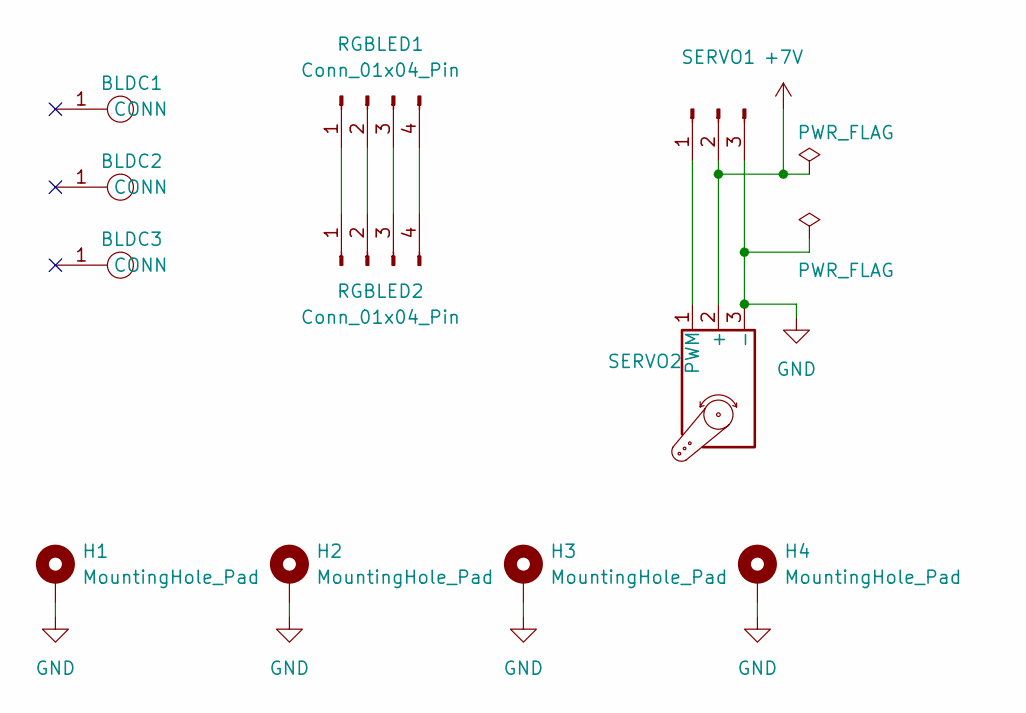
[picture p91: schematic pcb_connector_azimuth_thruster.kicad_sch, pcb connector azimuth thruster]

Parts:
BLDC1, BLDC2, BLDC3: bldc_connector
H1, H2, H3, H4: MountingHole_Pad; MountingHole_3.2mm_M3_large_PAD_for_spacer
RGBLED1, RGBLED2: Conn_01x04_Pin; PinHeader_1x04_P2.54mm_Vertical
SERVO1: PinSocket_1x03_P2.54mm_Vertical
SERVO2: PinHeader_1x03_P2.54mm_Vertical

Connections:
+7V: SERVO1.2, SERVO2.2 (+)
GND: H1.1, H2.1, H3.1, H4.1, SERVO1.3, SERVO2.3 (-)
unnamed: RGBLED1.1, RGBLED2.1
unnamed: RGBLED1.2, RGBLED2.2
unnamed: RGBLED1.3, RGBLED2.3
unnamed: RGBLED1.4, RGBLED2.4
unnamed: SERVO1.1, SERVO2.1 (PWM)

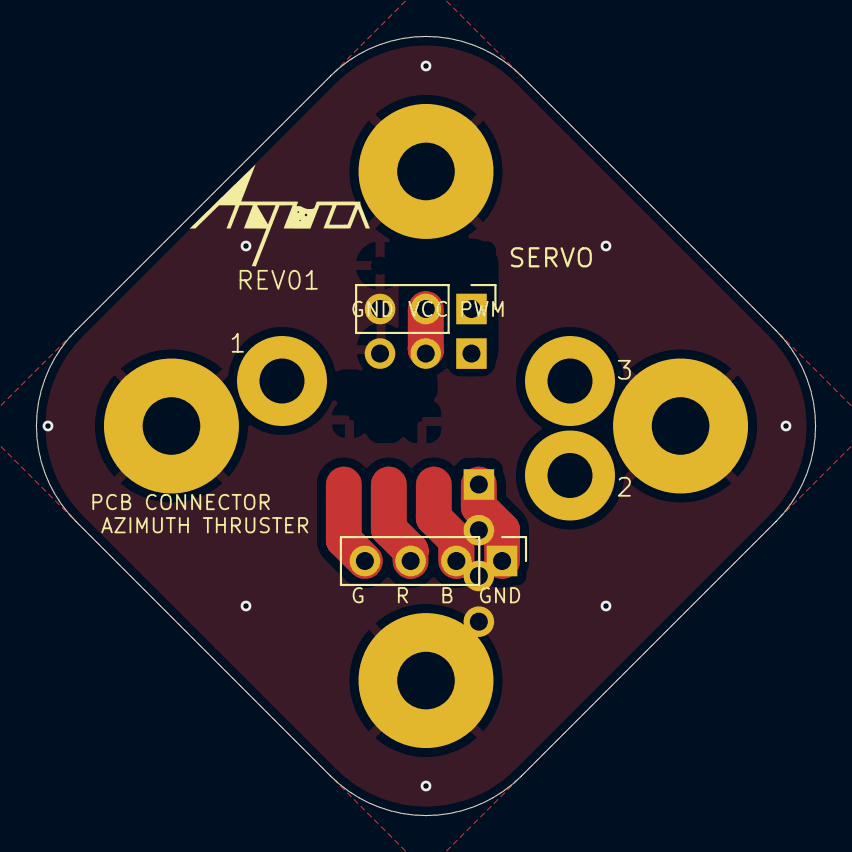
[picture p92: board pcb_connector_azimuth_thruster.kicad_pcb from above]

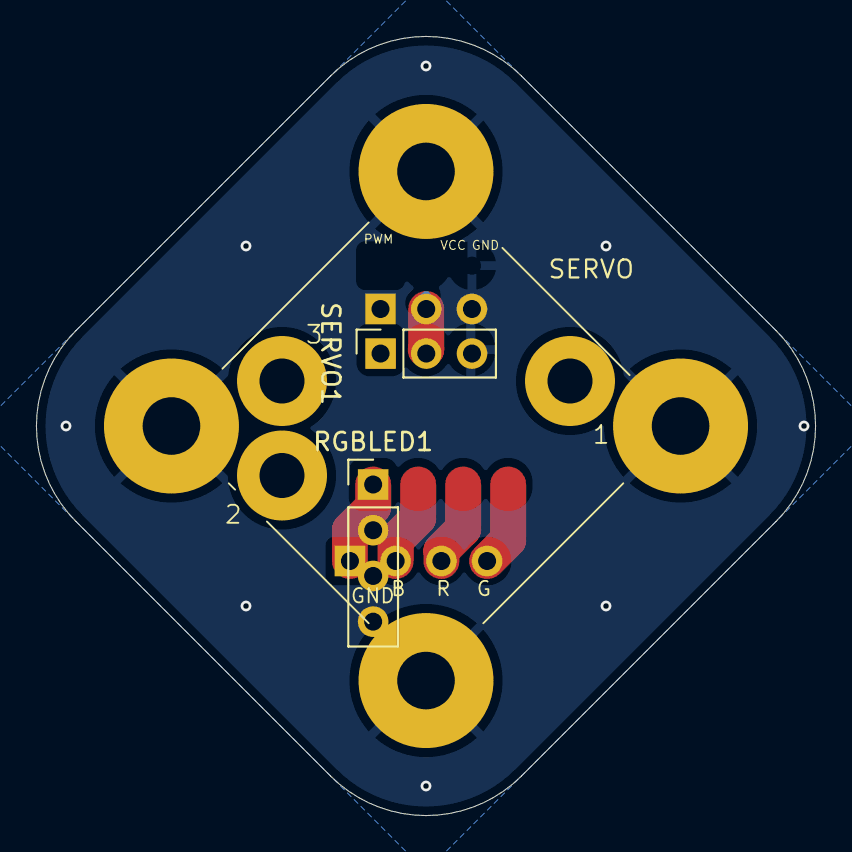
[picture p93: board pcb_connector_azimuth_thruster.kicad_pcb from below]

Board: 2 copper layers, 43.3 x 43.3 mm, 11 parts (2 on the bottom side), 7 nets.
