rogy-AquaLab/sinsei_UMIUSI_pcb/pcb_connector_led_tape/pcb_connector_led_tape.kicad_pcb

## KiCad design pcb_connector_old/pcb_connector_led_tape/pcb_connector_led_tape.kicad_pcb (2025-07-05, an earlier design)

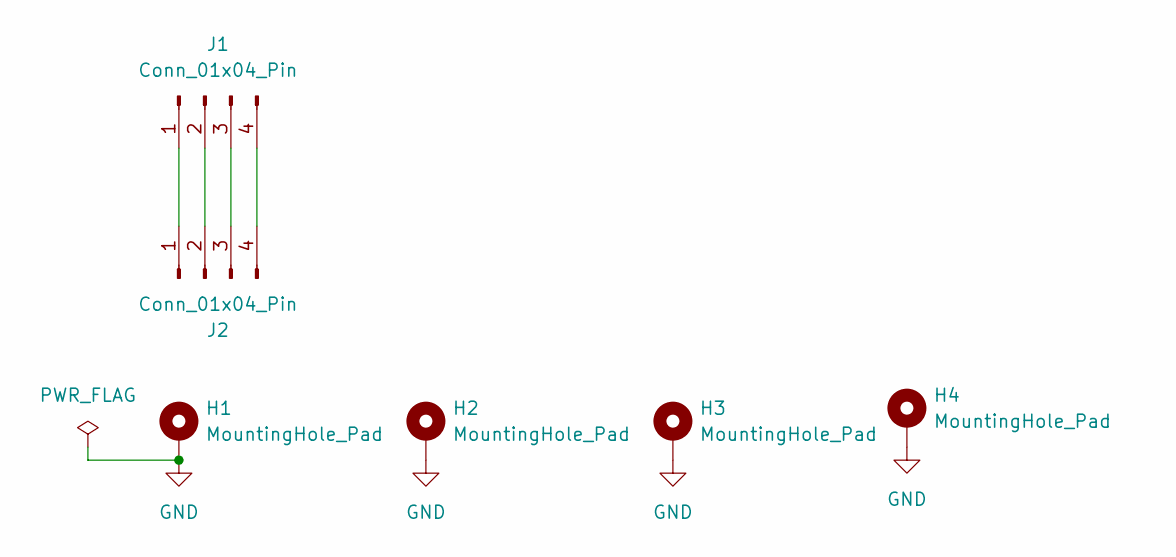
[picture p94: schematic pcb_connector_led_tape.kicad_sch, pcb connector led tape]

Parts:
H1, H2, H3, H4: MountingHole_Pad; MountingHole_3.2mm_M3_PAD_for_spacer
J1, J2: Conn_01x04_Pin; PinHeader_1x04_P2.00mm_Vertical

Connections:
GND: H1.1, H2.1, H3.1, H4.1
unnamed: J1.1, J2.1
unnamed: J1.2, J2.2
unnamed: J1.3, J2.3
unnamed: J1.4, J2.4

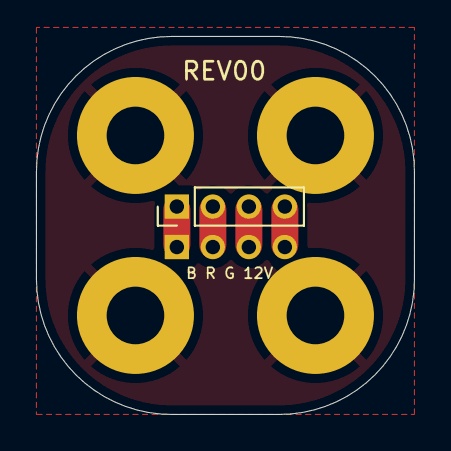
[picture p95: board pcb_connector_led_tape.kicad_pcb from above]

Board: 2 copper layers, 21.0 x 21.0 mm, 6 parts (1 on the bottom side), 5 nets.
