rogy-AquaLab/sinsei_UMIUSI_pcb/power_circuit_2/power_circuit_2.kicad_pcb

## KiCad design power_circuit_2/power_circuit_2.kicad_pcb (2025-08-18)

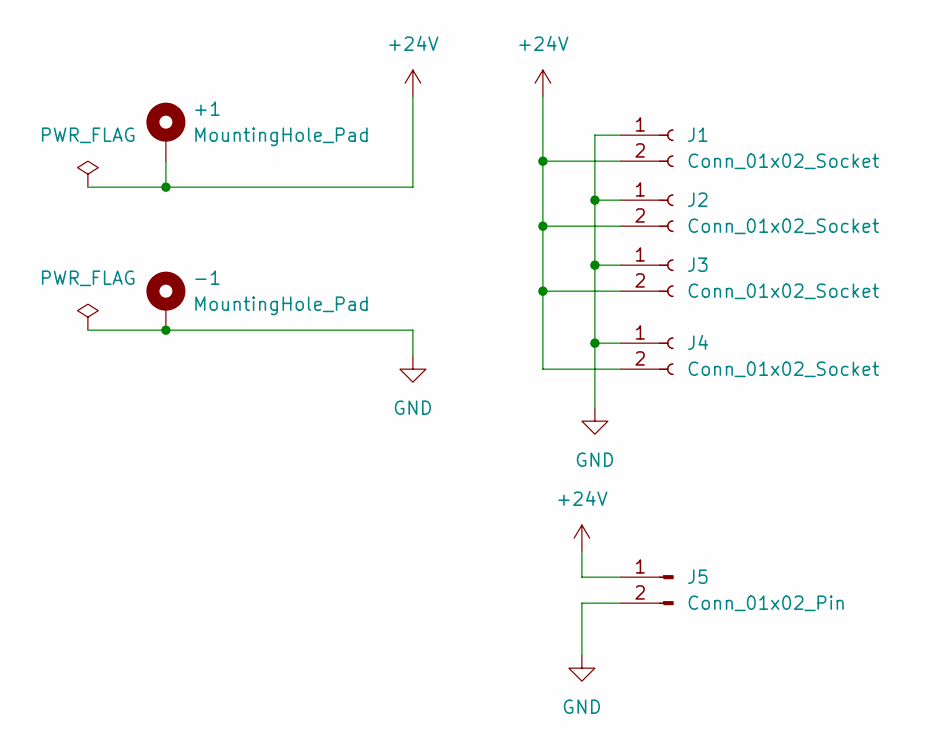
[picture p96: schematic power_circuit_2.kicad_sch]

Parts:
+1: MountingHole_Pad; MountingHole_3.2mm_M3_DIN965_Pad
-1: MountingHole_Pad; MountingHole_3.2mm_M3_DIN965_Pad
J1, J2, J3, J4: Conn_01x02_Socket; AMASS_XT60PW-F_1x02_P7.20mm_Horizontal
J5: Conn_01x02_Pin; JST_VH_B2PS-VH_1x02_P3.96mm_Horizontal

Connections:
+24V: +1.1, J1.2, J2.2, J3.2, J4.2, J5.1
GND: -1.1, J1.1, J2.1, J3.1, J4.1, J5.2

Board: 2 copper layers, 7 parts (4 on the bottom side), 2 nets, no tracks yet.
