rogy-AquaLab/sinsei_UMIUSI_pcb/power_circuit/power_circuit.kicad_pcb

## KiCad design power_circuit/power_circuit.kicad_pcb (2025-08-18)

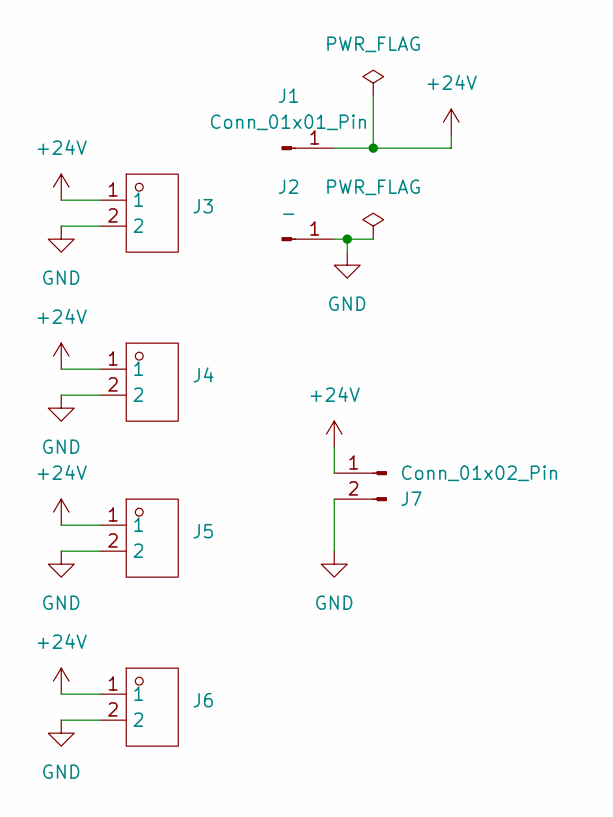
[picture p97: schematic power_circuit.kicad_sch, power circuit]

Parts:
J1: Conn_01x01_Pin; MountingHole_4.5mm_Pad_Via
J2: -; MountingHole_4.5mm_Pad_Via
J3, J4, J5, J6: TH_XT90PB-F; Manufacturer Part XT90H-F.G.Y; LCSC Part Name 两件套 AMASS(艾迈斯)焊接注塑型 2PIN 接头XT90H-F.G.Y
J7: Conn_01x02_Pin; JST_VH_B2PS-VH_1x02_P3.96mm_Horizontal

Connections:
+24V: J1.1, J3.1, J4.1, J5.1, J6.1, J7.1
GND: J2.1, J3.2, J4.2, J5.2, J6.2, J7.2

Board: 2 copper layers, 7 parts (0 on the bottom side), 2 nets, no tracks yet.
