rogy-AquaLab/sinsei_UMIUSI_pcb/UmiusiThrusterLEDUnit/UmiusiThrusterLEDUnit.kicad_pcb

## KiCad design UmiusiThrusterLEDUnit/UmiusiThrusterLEDUnit.kicad_pcb (2025-07-31)

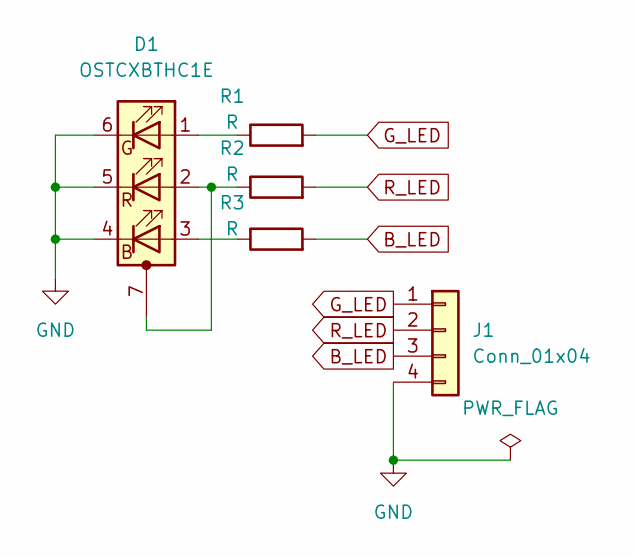
[picture p98: schematic UmiusiThrusterLEDUnit.kicad_sch]

Parts:
D1: OSTCXBTHC1E
J1: Conn_01x04; PinHeader_1x04_P2.54mm_Vertical
R1, R2, R3: R; R_Axial_DIN0207_L6.3mm_D2.5mm_P7.62mm_Horizontal

Connections:
B_LED: J1.3, R3.2
GND: D1.4 (BK), D1.5 (RK), D1.6 (GK), J1.4
G_LED: J1.1, R1.2
unnamed: D1.3 (BA), R3.1
unnamed: D1.1 (GA), R1.1
unnamed: D1.2 (RA), D1.7 (PAD), R2.1
R_LED: J1.2, R2.2

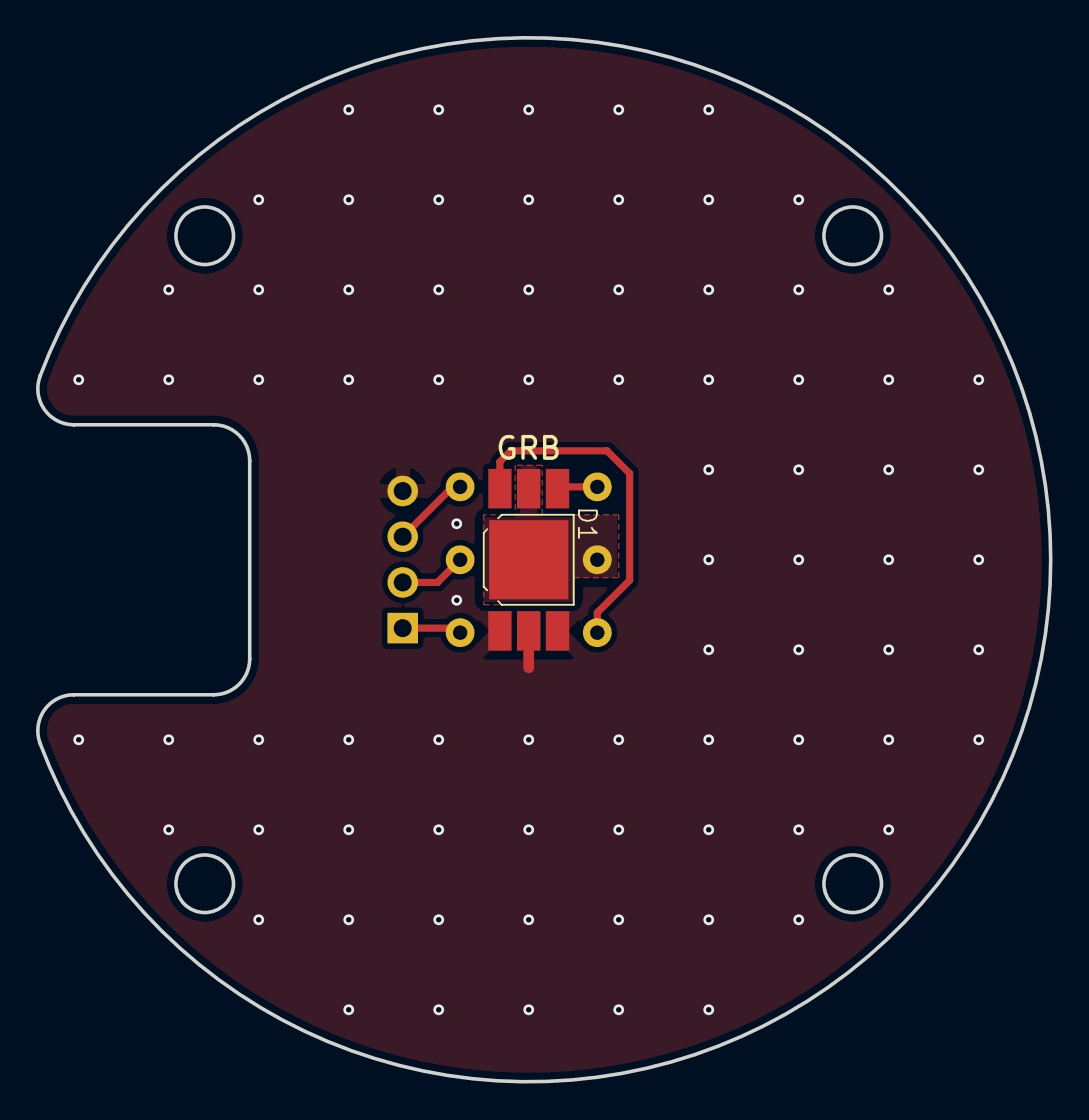
[picture p99: board UmiusiThrusterLEDUnit.kicad_pcb from above]

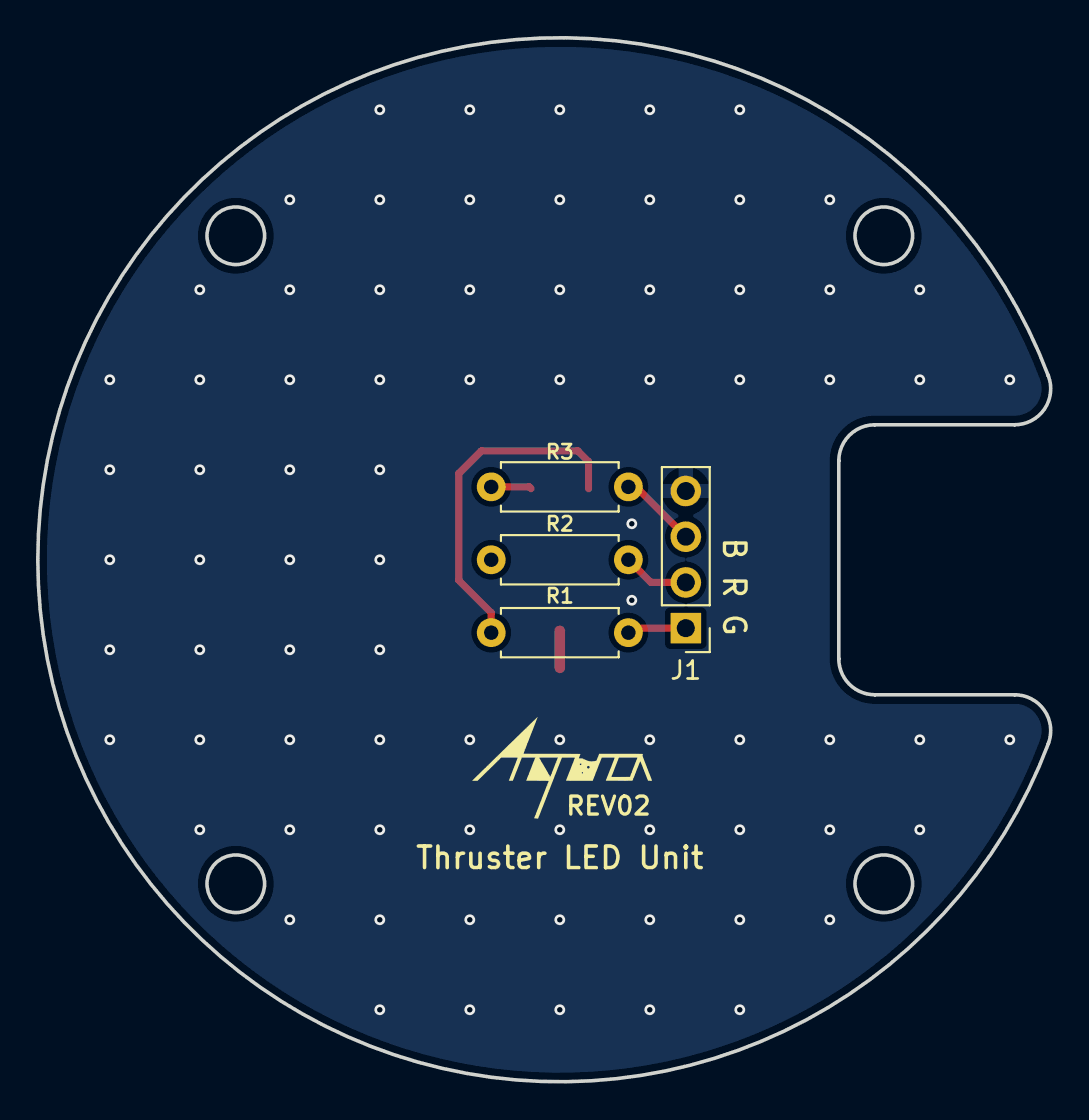
[picture p100: board UmiusiThrusterLEDUnit.kicad_pcb from below]

Board: 2 copper layers, 56.3 x 58.0 mm, 5 parts (4 on the bottom side), 7 nets.
