rogy-AquaLab/sinsei_UMIUSI_pcb/headlight_lower_side/headlight_lower_side.kicad_pcb

## KiCad design headlight_lower_side/headlight_lower_side.kicad_pcb (2025-07-05)

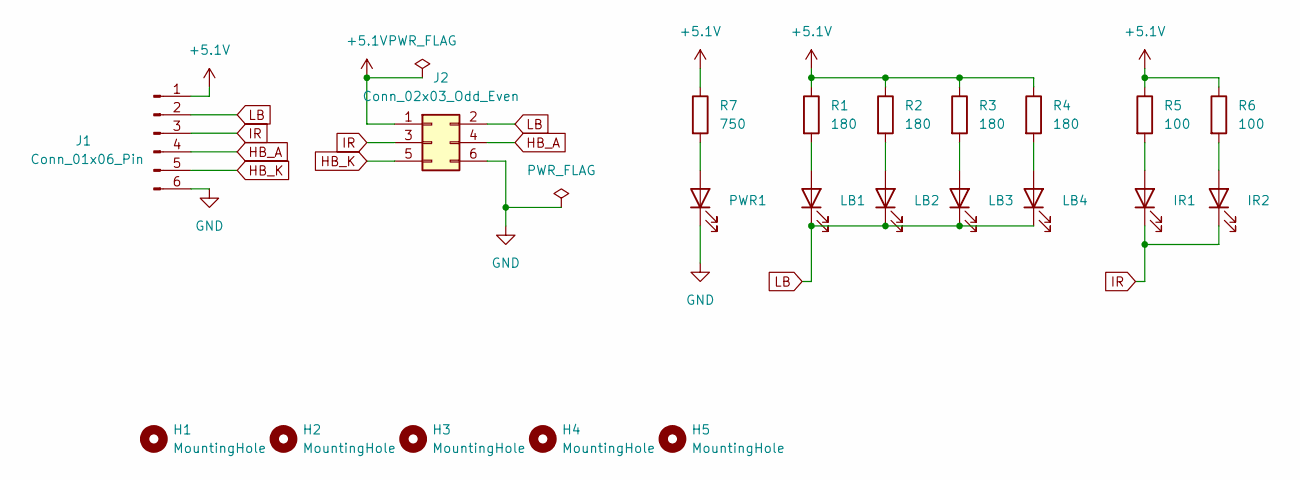
[picture p101: schematic headlight_lower_side.kicad_sch]

Parts:
H1, H2, H3, H4, H5: MountingHole; MountingHole_3.2mm_M3
IR1, IR2: LED_D3.0mm_Horizontal_O3.81mm_Z2.0mm
J1: Conn_01x06_Pin; JST_XA_B06B-XASK-1_1x06_P2.50mm_Vertical
J2: Conn_02x03_Odd_Even; PinHeader_2x03_P2.54mm_Horizontal
LB1, LB2, LB3, LB4: white; LED_0805_2012Metric_Pad1.15x1.40mm_HandSolder
PWR1: white; LED_0805_2012Metric_Pad1.15x1.40mm_HandSolder
R1, R2, R3, R4: 180; R_Axial_DIN0207_L6.3mm_D2.5mm_P10.16mm_Horizontal
R5, R6: 100; R_Axial_DIN0207_L6.3mm_D2.5mm_P10.16mm_Horizontal
R7: 750; R_Axial_DIN0207_L6.3mm_D2.5mm_P10.16mm_Horizontal

Connections:
+5.1V: J1.1, J2.1, R1.1, R2.1, R3.1, R4.1, R5.1, R6.1, R7.1
GND: J1.6, J2.6, PWR1.1 (K)
HB_A: J1.4, J2.4
HB_K: J1.5, J2.5
IR: IR1.1 (K), IR2.1 (K), J1.3, J2.3
LB: J1.2, J2.2, LB1.1 (K), LB2.1 (K), LB3.1 (K), LB4.1 (K)
unnamed: IR1.2 (A), R5.2
unnamed: IR2.2 (A), R6.2
unnamed: LB1.2 (A), R1.2
unnamed: LB2.2 (A), R2.2
unnamed: LB3.2 (A), R3.2
unnamed: LB4.2 (A), R4.2
unnamed: PWR1.2 (A), R7.2
