rogy-AquaLab/sinsei_UMIUSI_pcb/headlight_lower_side/headlight_lower_side.kicad_pcb

## KiCad design headlight_lower_side/headlight_lower_side.kicad_pcb (continued)

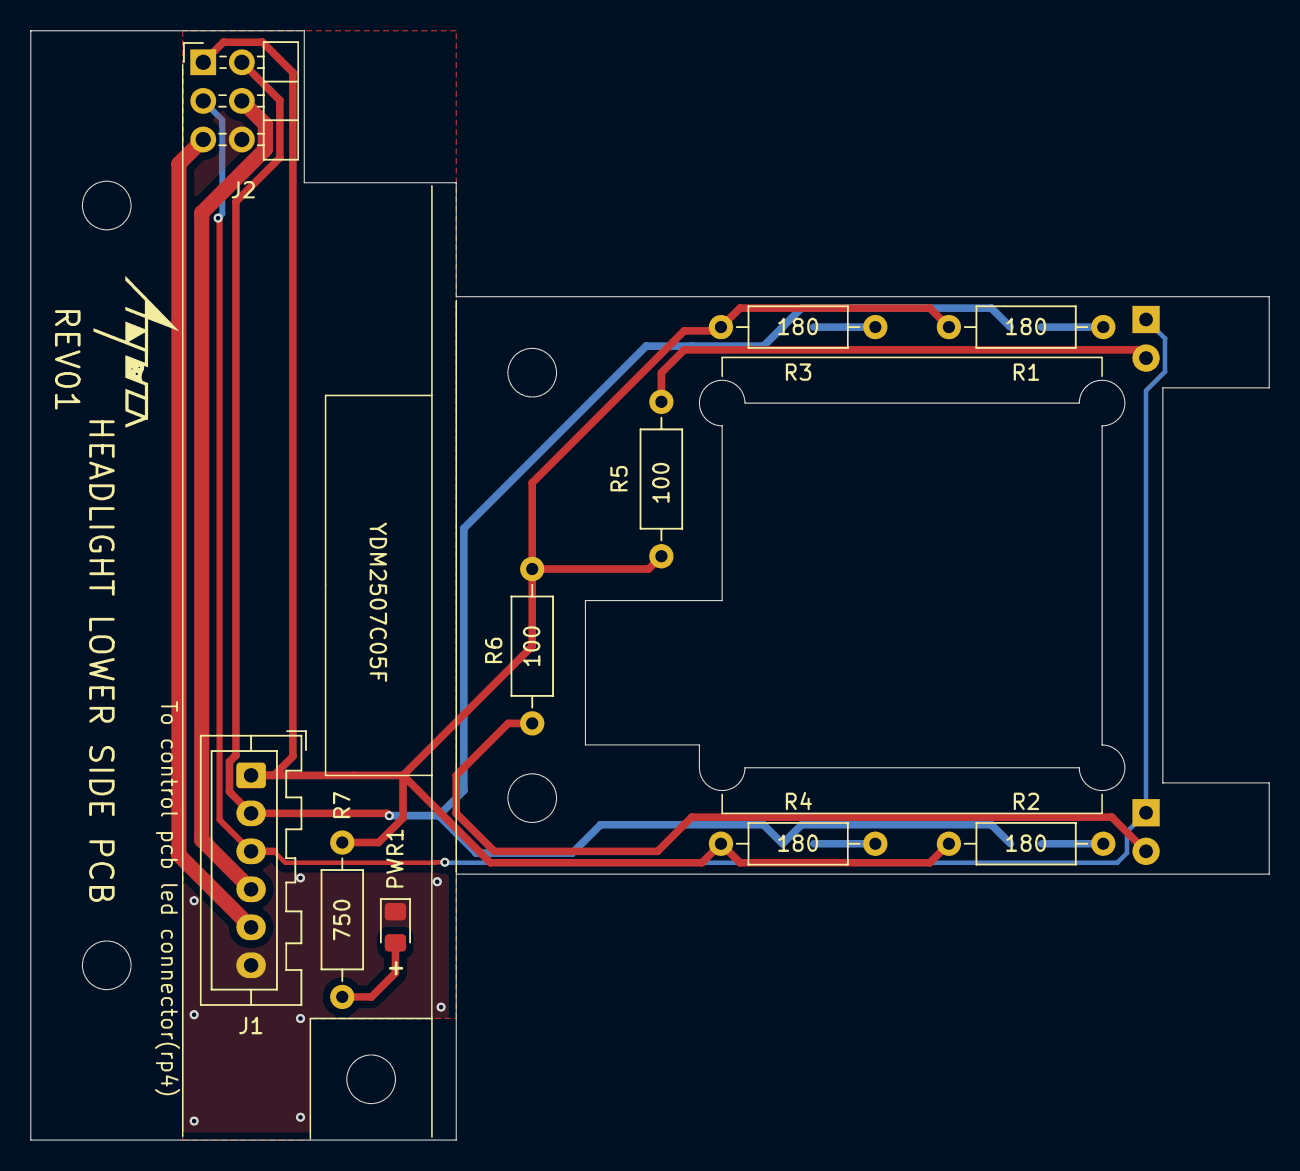
[picture p102: board headlight_lower_side.kicad_pcb from above]

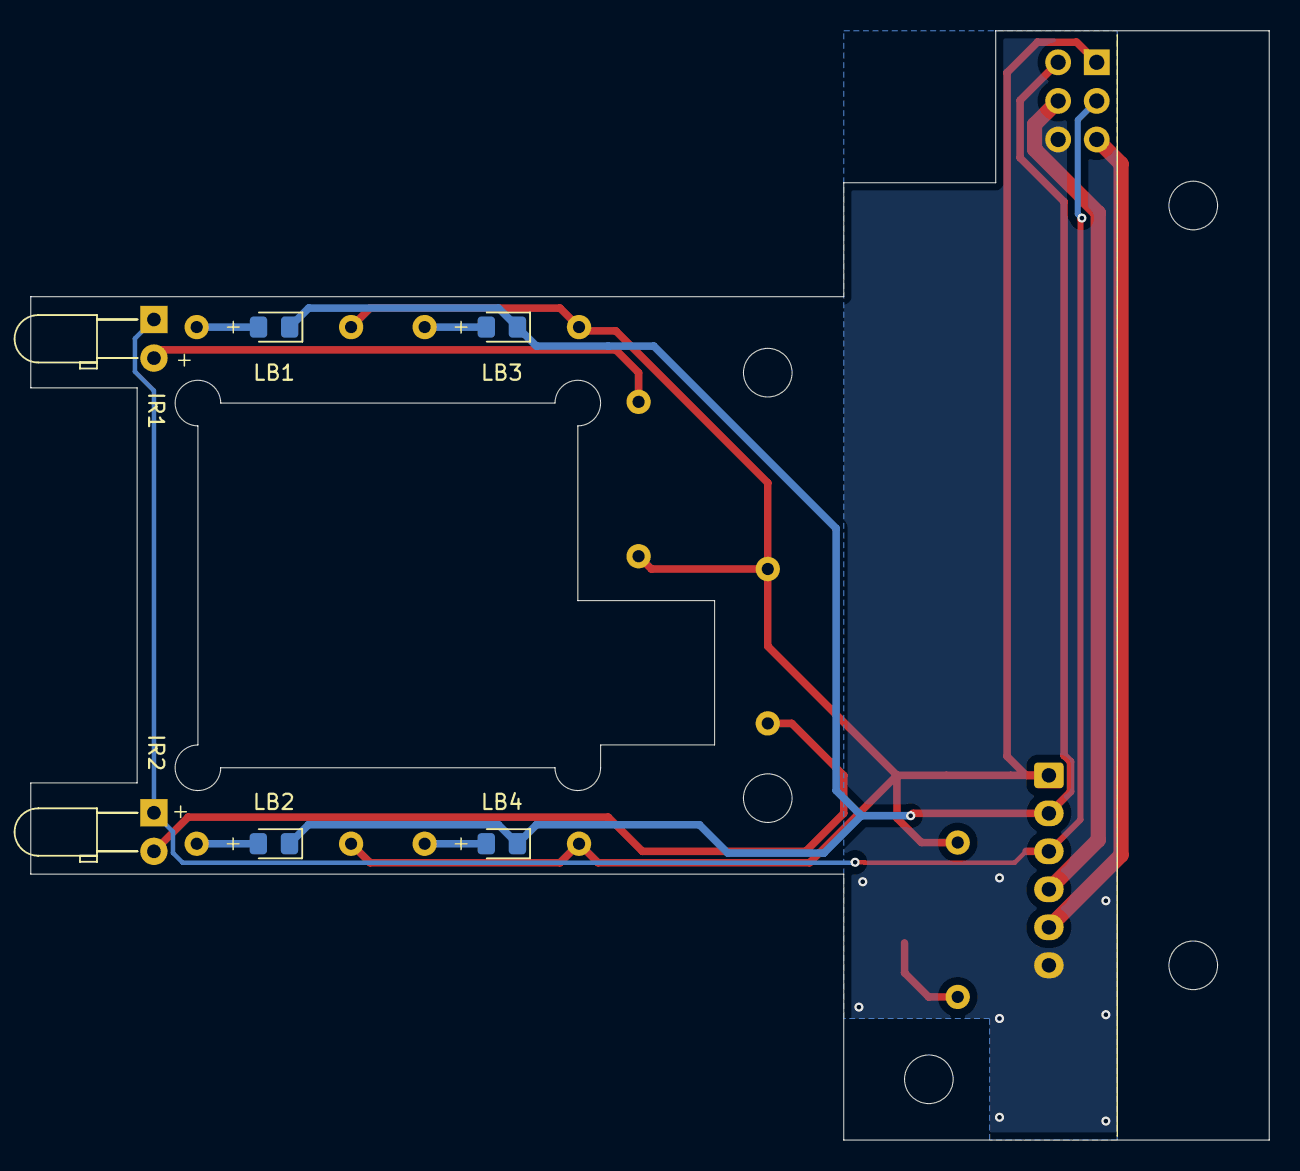
[picture p103: board headlight_lower_side.kicad_pcb from below]

Board: 2 copper layers, 81.5 x 73.0 mm, 21 parts (6 on the bottom side), 13 nets.
