rogy-AquaLab/sinsei_UMIUSI_pcb/headlight_upper_side/headlight_upper_side.kicad_pcb

## KiCad design headlight_upper_side/headlight_upper_side.kicad_pcb (2025-07-05)

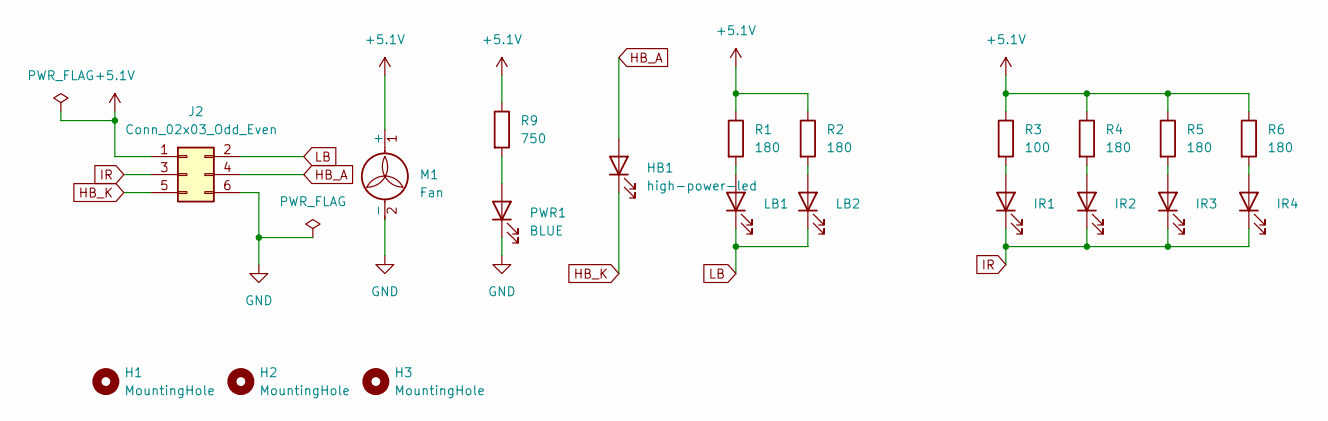
[picture p104: schematic headlight_upper_side.kicad_sch]

Parts:
H1, H2, H3: MountingHole; MountingHole_3.2mm_M3
HB1: high-power-led; power led
IR1, IR2, IR3, IR4: LED_D5.0mm
J2: Conn_02x03_Odd_Even; PinSocket_2x03_P2.54mm_Vertical
LB1, LB2: LED_D5.0mm
M1: Fan; PinHeader_1x02_P2.54mm_Vertical
PWR1: BLUE; LED_0805_2012Metric_Pad1.15x1.40mm_HandSolder
R1, R2, R4, R5, R6: 180; R_Axial_DIN0207_L6.3mm_D2.5mm_P10.16mm_Horizontal
R3: 100; R_Axial_DIN0207_L6.3mm_D2.5mm_P10.16mm_Horizontal
R9: 750; R_Axial_DIN0207_L6.3mm_D2.5mm_P10.16mm_Horizontal

Connections:
+5.1V: J2.1, M1.1 (+), R1.1, R2.1, R3.1, R4.1, R5.1, R6.1, R9.1
GND: J2.6, M1.2 (-), PWR1.1 (K)
HB_A: HB1.2 (A), J2.4
HB_K: HB1.1 (K), J2.5
IR: IR1.1 (K), IR2.1 (K), IR3.1 (K), IR4.1 (K), J2.3
LB: J2.2, LB1.1 (K), LB2.1 (K)
unnamed: IR1.2 (A), R3.2
unnamed: IR2.2 (A), R4.2
unnamed: IR3.2 (A), R5.2
unnamed: IR4.2 (A), R6.2
unnamed: LB1.2 (A), R1.2
unnamed: LB2.2 (A), R2.2
unnamed: PWR1.2 (A), R9.2

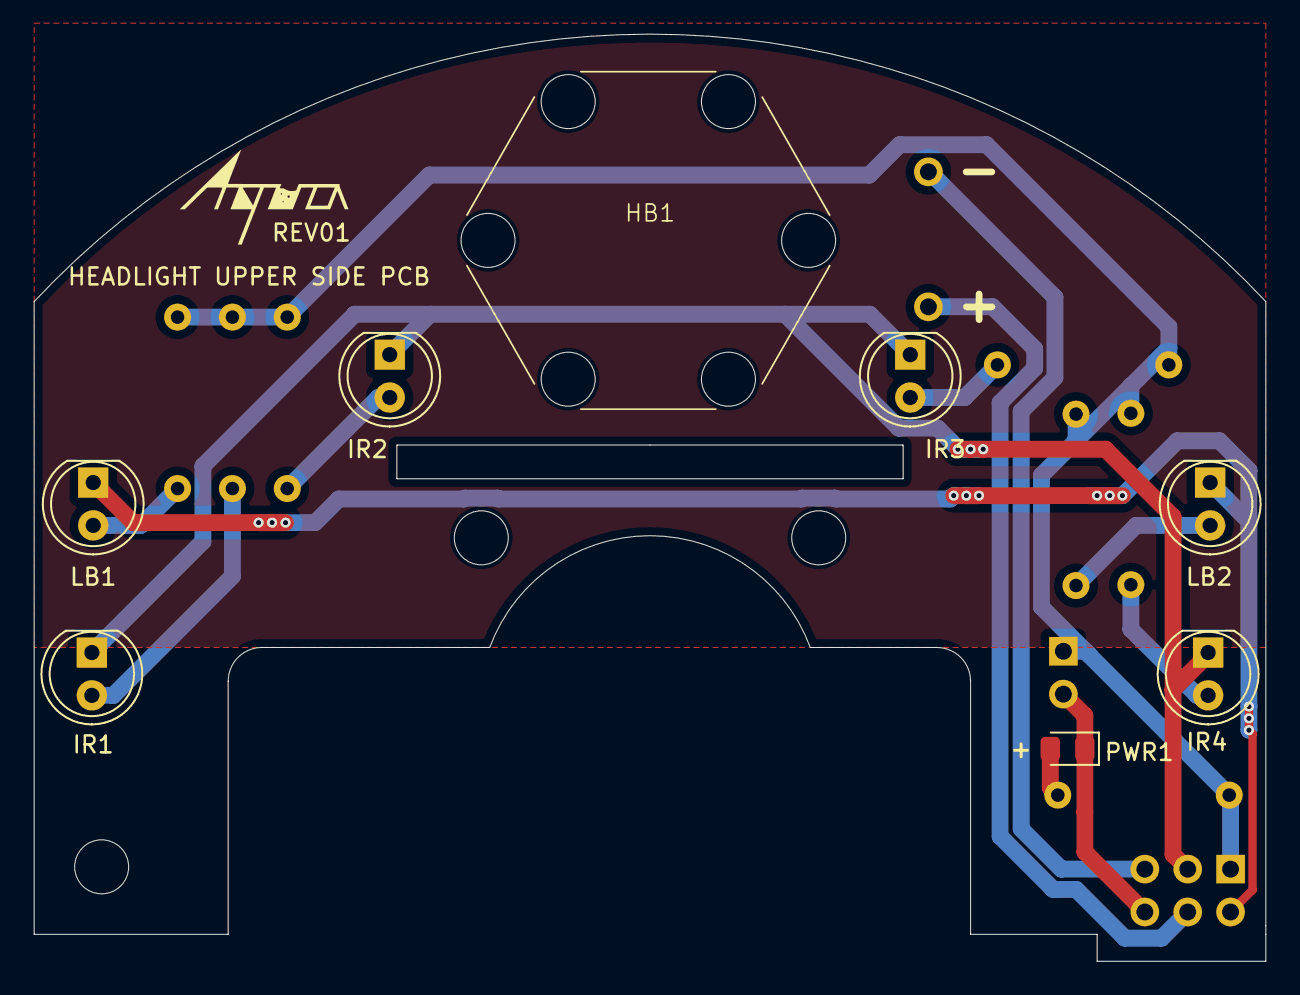
[picture p105: board headlight_upper_side.kicad_pcb from above]

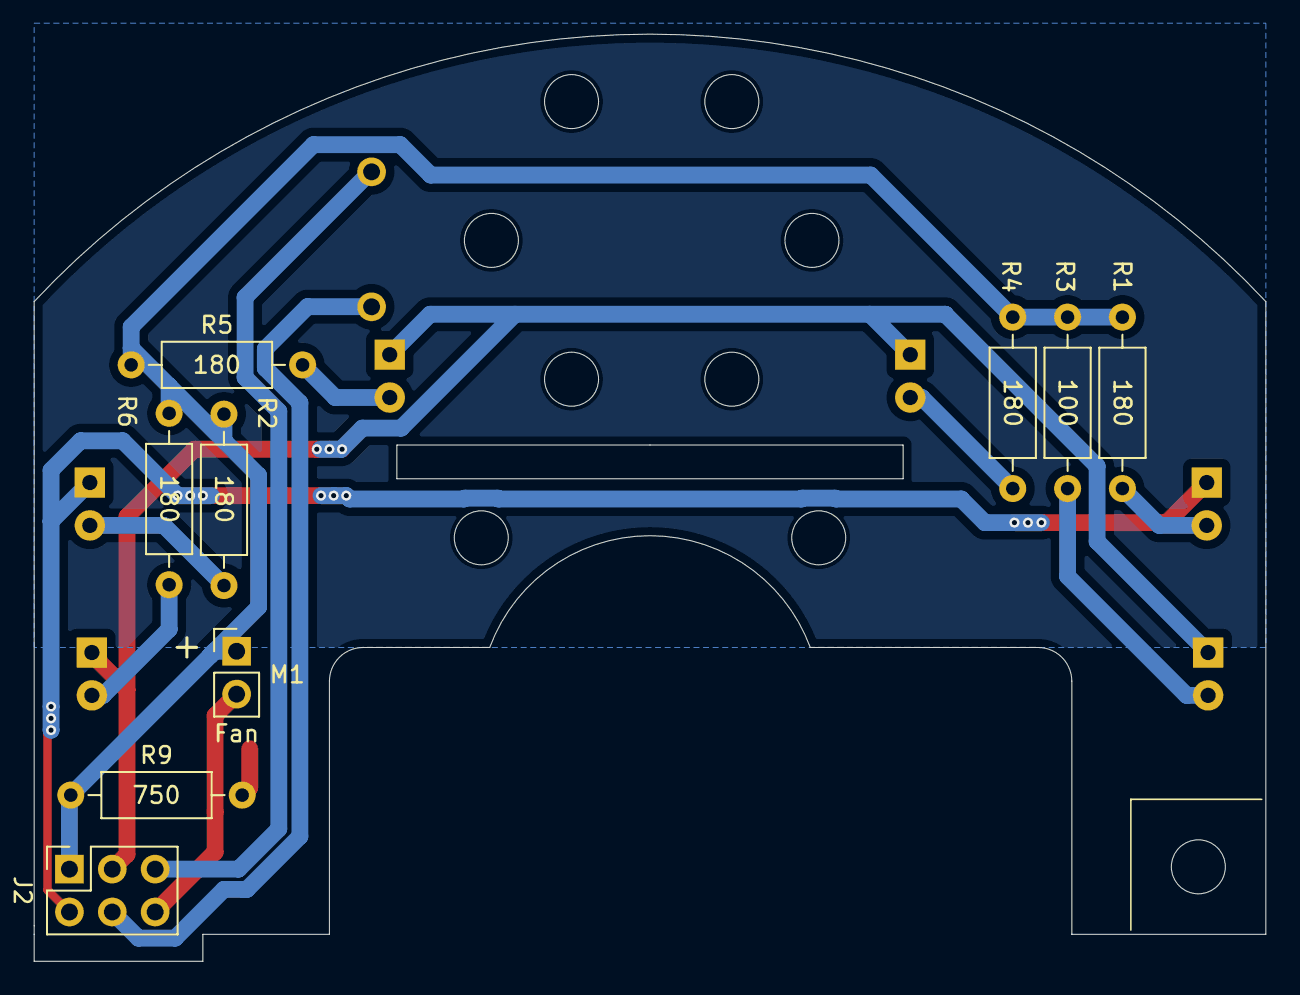
[picture p106: board headlight_upper_side.kicad_pcb from below]

Board: 2 copper layers, 73.0 x 55.0 mm, 20 parts (9 on the bottom side), 13 nets.
