rogy-AquaLab/sinsei_UMIUSI_pcb/pcb_connector_lan(outer)/pcb_connector_lan(outer).kicad_pcb

## KiCad design pcb_connector_lan(outer)/pcb_connector_lan(outer).kicad_pcb (2025-07-05)

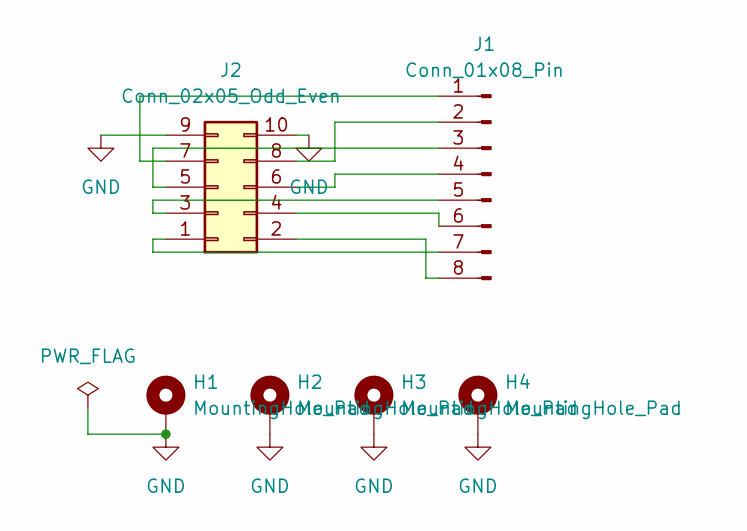
[picture p107: schematic pcb_connector_lan(outer).kicad_sch]

Parts:
H1, H2, H3, H4: MountingHole_Pad; MountingHole_3.2mm_M3_large_PAD_for_spacer
J1: Conn_01x08_Pin; PinSocket_1x08_P2.00mm_Vertical
J2: Conn_02x05_Odd_Even; PinSocket_2x05_P2.54mm_Vertical

Connections:
GND: H1.1, H2.1, H3.1, H4.1, J2.9, J2.10
unnamed: J1.1, J2.7
unnamed: J1.2, J2.8
unnamed: J1.3, J2.5
unnamed: J1.4, J2.6
unnamed: J1.5, J2.3
unnamed: J1.6, J2.4
unnamed: J1.7, J2.1
unnamed: J1.8, J2.2

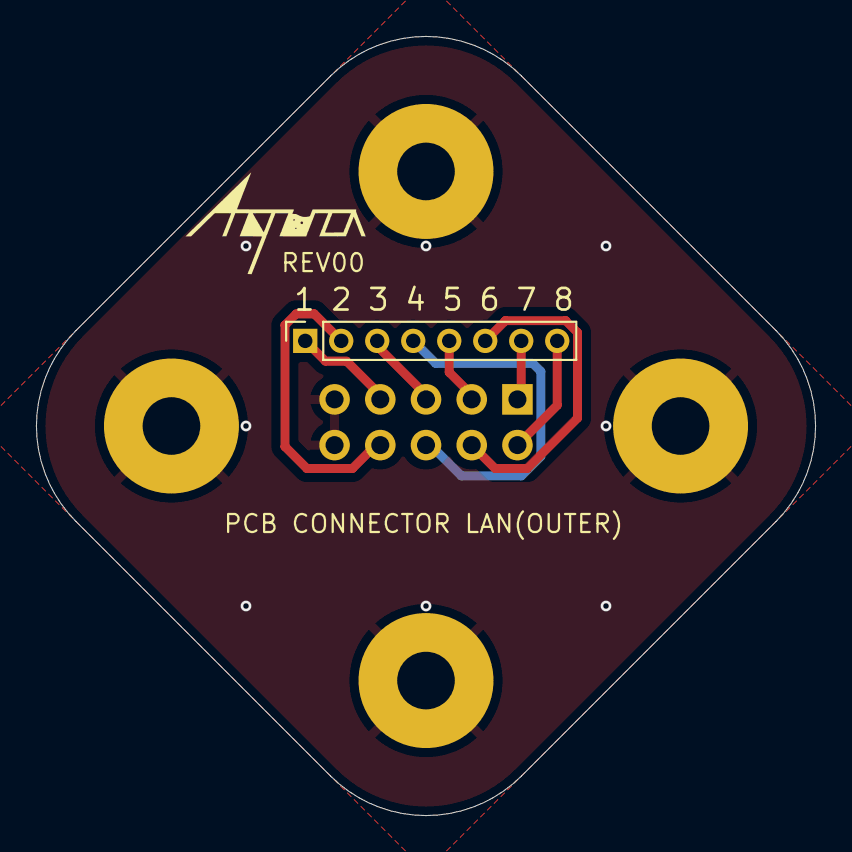
[picture p108: board pcb_connector_lan(outer).kicad_pcb from above]

Board: 2 copper layers, 43.3 x 43.3 mm, 6 parts (1 on the bottom side), 9 nets.
