rogy-AquaLab/sinsei_UMIUSI_pcb/LM25145_test/LM25145_test.kicad_pcb

## KiCad design LM25145_test/LM25145_test.kicad_pcb (2025-05-18)

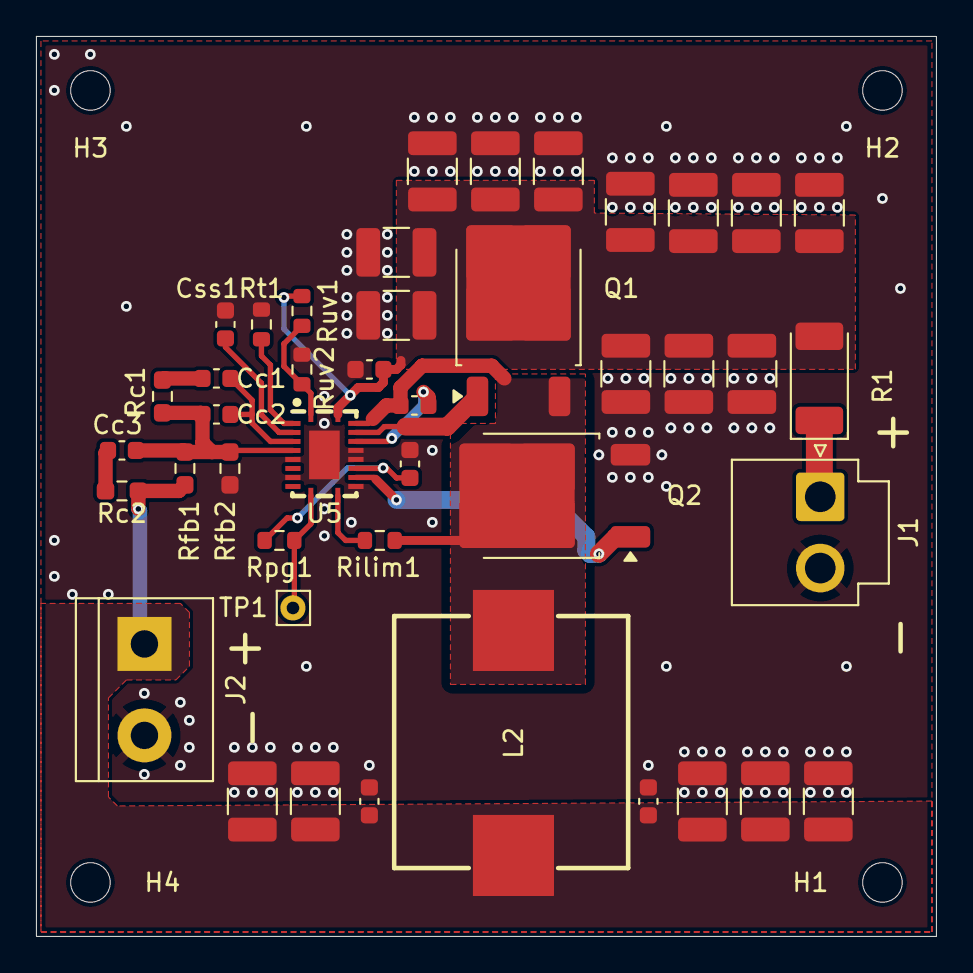
[picture p109: board LM25145_test.kicad_pcb from above]

Board: 2 copper layers, 50.0 x 50.0 mm, 47 parts (0 on the bottom side), 18 nets.

Parts:
Cbst1: 0.1u; C_0603_1608Metric
Cc1: 5.6n; C_0603_1608Metric
Cc2: 82p; C_0603_1608Metric
Cc3: 1500p; C_0603_1608Metric
Cin1, Cin2, Cin3, Cin4, Cin5, Cin6, Cin7, Cin8, Cin9, Cin10, Cin11, Cin12: 10u; C_1210_3225Metric_Pad1.33x2.70mm_HandSolder
Cout1: 100p; C_0603_1608Metric
Cout2: 0.1u; C_0603_1608Metric
Cout3: 10u; C_1210_3225Metric_Pad1.33x2.70mm_HandSolder
Cout4, Cout5, Cout6, Cout7: 47u; C_1210_3225Metric_Pad1.33x2.70mm_HandSolder
Css1: 0.1u; C_0603_1608Metric
Cvcc1: 2.2u; C_0603_1608Metric
Cvin1: 0.1u; C_0603_1608Metric
H1, H2, H3, H4: MountingHole; MountingHole_2.2mm_M2
J1: Conn_01x02_Socket; JST_VH_B2P-VH_1x02_P3.96mm_Vertical
J2: Conn_01x02_Socket; TerminalBlock_bornier-2_P5.08mm
L2: 10u; IND-SMD_L13.8-W12.6
Q1, Q2: TO-252-2
R1: 20m; D_2010_5025Metric_Pad1.52x2.65mm_HandSolder
Rc1: 10k; R_0603_1608Metric_Pad0.98x0.95mm_HandSolder
Rc2: 560; R_0603_1608Metric_Pad0.98x0.95mm_HandSolder
Rfb1: 18k; R_0603_1608Metric_Pad0.98x0.95mm_HandSolder
Rfb2: 3.3k; R_0603_1608Metric_Pad0.98x0.95mm_HandSolder
Rilim1: 180; R_0603_1608Metric
Rpg1: 51k; R_0603_1608Metric
Rt1: 33k; R_0603_1608Metric
Ruv1: 75k; R_0603_1608Metric
Ruv2: 12k; R_0603_1608Metric
TP1: TestPoint; Pin_D0.7mm_L6.5mm_W1.8mm_FlatFork
U5: VQFN-20_L4.5-W3.5-P0.50-BL-EP

Connections:
+5.1V: Cout1.2, Cout2.2, Cout3.1, Cout4.1, Cout5.1, Cout6.1, Cout7.1, J2.1, L2.2, Rc2.2, Rfb1.2
+7.5V: Cvcc1.1, Rpg1.2, U5.14 (VCC)
+24V: Cin1.1, Cin2.1, Cin3.1, Cin4.1, Cin5.1, Cin6.1, Cin7.1, Cin8.1, Cin9.1, Cin10.1, Cin11.1, Cin12.1, Cvin1.1, Q1.2 (D), R1.2, Ruv1.1, U5.20 (VIN)
GND: Cin1.2, Cin2.2, Cin3.2, Cin4.2, Cin5.2, Cin6.2, Cin7.2, Cin8.2, Cin9.2, Cin10.2, Cin11.2, Cin12.2, Cout1.1, Cout2.1, Cout3.2, Cout4.2, Cout5.2, Cout6.2, Cout7.2, Css1.1, Cvcc1.2, Cvin1.2, J1.2, J2.2, Q2.3 (S), Rfb2.1, Rt1.1, Ruv2.2, U5.6 (AGND), U5.8 (SYNCIN), U5.12 (PGND), U5.15 (EP), U5.16 (NC), U5.21 (EP)
unnamed: Cc1.1, Rc1.1
unnamed: Cc3.1, Rc2.1
unnamed: J1.1, R1.1
unnamed: Q1.1 (G), U5.18 (HO)
unnamed: Cbst1.2, L2.1, Q1.3 (S), Q2.2 (D), Rilim1.2, U5.19 (SW)
unnamed: Q2.1 (G), U5.13 (LO)
unnamed: Cbst1.1, U5.17 (BST)
unnamed: Cc1.2, Cc2.2, U5.4 (COMP)
unnamed: Ruv1.2, Ruv2.1, U5.1 (EN/UVLO)
unnamed: Cc2.1, Cc3.2, Rc1.2, Rfb1.1, Rfb2.2, U5.5 (FB)
unnamed: Rilim1.1, U5.11 (ILIM)
unnamed: Rt1.2, U5.2 (RT)
unnamed: Css1.2, U5.3 (SS/TRK)
PGOOD: Rpg1.1, TP1.1, U5.10 (PGOOD)
