rogy-AquaLab/sinsei_UMIUSI_pcb/(commit log)

2025-04-14 DCDCコンバーター設計開始
    [control_unit.kicad_sch]
2025-04-15 ファイル追加
    [LM25145_quickstart_calculator_A5.xlsm, control_unit.kicad_sch]
2025-04-16 DCDCコンバーター設計完了
    [LM25145_quickstart_calculator_A5.xlsm, control_unit.kicad_sch]
2025-04-20 入力コンデンサ、出力コンデンサを直した
    [LED基板概要.dxf, control_unit.kicad_sch]
2025-04-20 LEDドライバのデータシート追加
    [LM25145_quickstart_calculator_A5.xlsm, control_unit.kicad_sch]
2025-04-26 若干修正
    [control_unit.kicad_sch]
2025-04-26 テスト基盤回路図作成、基板作成中
    [LM25145_quickstart_calculator_A5.xlsm, LM25145_test.kicad_pcb, LM25145_test.kicad_sch, バンド幅重視.xlsx]
2025-04-28 LM25145テスト基板完成、実験用レポートひな形準備
    [BOM-LM25145_test.csv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]
2025-04-28 スラスターLED用基板を追加
    [Component8.step, UmiusiThrusterLEDUnit-User_1.dxf, UmiusiThrusterLEDUnit.kicad_pcb, UmiusiThrusterLEDUnit.kicad_sch, UmiusiThrusterLEDUnit.step, bom.csv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]
2025-04-28 gitignoreを追加
2025-04-28 不要なファイルを削除
2025-04-29 LM25145_testの基板サイズを小さくして、発注
    [BOM-LM25145_test.csv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]
2025-05-09 OKL [200~過渡応答を
    [LM25145_test.kicad_sch, control_unit.kicad_pcb, control_unit.kicad_sch, スケッチ13.dxf, タイプ3位相補償、5パターン.xlsx, パーツリスト.csv]
2025-05-12 制御基板配線開始
    [LM25145_quickstart_calculator_A5.xlsm, LM25145_test.kicad_sch, control_unit.kicad_pcb, control_unit.kicad_sch, スケッチ13.dxf, スケッチ17.dxf, スケッチ26.dxf, タイプ3位相補償、5パターン.xlsx]
2025-05-18 制御基板PCB7割完成
    [LM25145_quickstart_calculator_A5.xlsm, LM25145_test.kicad_pcb, control_unit.kicad_pcb, control_unit.kicad_sch, タイプ3位相補償、5パターン.xlsx]
2025-05-20 配線完了
    [control_unit.kicad_pcb, control_unit.kicad_sch]
2025-05-22 control_unit Rev00発注
    [BOM-control_unit.csv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]
2025-05-28 制御基板のファイル整理と微調整
    [HeadLight.kicad_pcb, HeadLight.kicad_sch, LM25145_quickstart_calculator_A5.xlsm, bom.csv, control_unit.kicad_pcb, control_unit.kicad_sch]
2025-06-03 基板防水(LAN)作成開始
    [HeadLight.kicad_pcb, HeadLight.kicad_sch, HeadLight.step, LM25145_quickstart_calculator_A5.xlsm, Pin Header - RaspberryPi - Stacking - 2.54mm_V2.step, control_unit.kicad_pcb, control_unit.kicad_sch, high power LED.dxf]
2025-06-10 gitignoreにOSが自動生成する不要ファイルを追加
2025-06-10 スラスターLED用基板を修正
    [UmiusiThrusterLEDUnit.kicad_pcb, UmiusiThrusterLEDUnit.kicad_sch, bom.csv, designators.csv, positions.csv]
2025-06-10 started creating headlight_upper_side
    [HeadLight.kicad_pcb, HeadLight.step, battery_holder_back v3.stl, battery_holder_front v5.stl, headlight_lower_side.dxf, headlight_lower_side.kicad_pcb, headlight_lower_side.kicad_sch, headlight_lower_side.step]
2025-07-05 基板防水REV00発注完了
    [2mmスペーサ- 3Dプリンター製 v2.stl, 4mmスペーサ- 3Dプリンター製 v2.stl, AQUA_VESC.kicad_pcb, AQUA_VESC.kicad_sch, BOM-headlight_lower_side.csv, BOM-headlight_upper_side.csv, BOM-pcb_connector_lan(outer).csv, BOM-pcb_connectors.csv]
2025-07-05 ヘッドライト基盤REV01作成
    [headlight_lower_side.kicad_pcb, headlight_lower_side.kicad_sch, headlight_upper_side.kicad_pcb]
2025-07-21 VESC7割
    [AQUA_VESC.kicad_pcb, AQUA_VESC.kicad_sch, DRV8301.kicad_sch, LM25145_quickstart_calculator_A5.xlsm, LMR16030.kicad_sch, Power mosfets.kicad_sch, RGBLED_Driverkicad_sch.kicad_sch, STM32F405.kicad_sch]
2025-07-24 AQUA VESC仮完成
    [AQUA_VESC-CuBottom.gbr, AQUA_VESC-CuTop.gbr, AQUA_VESC-EdgeCuts.gbr, AQUA_VESC-MaskBottom.gbr, AQUA_VESC-MaskTop.gbr, AQUA_VESC-NPTH.drl, AQUA_VESC-PTH.drl, AQUA_VESC-SilkBottom.gbr]
2025-07-28 VESC発注
    [AQUA_VESC-CuBottom.gbr, AQUA_VESC-CuTop.gbr, AQUA_VESC-EdgeCuts.gbr, AQUA_VESC-MaskBottom.gbr, AQUA_VESC-MaskTop.gbr, AQUA_VESC-NPTH.drl, AQUA_VESC-PTH.drl, AQUA_VESC-SilkBottom.gbr]
2025-07-31 スラスタLED基盤 REV02作成
    [AQUA_VESC.kicad_pcb, BOM-UmiusiThrusterLEDUnit.csv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]
2025-08-18 AQUA_VESC REV01作成
    [2mmスペーサ- 3Dプリンター製 v2.stl, 4.5mmスペーサ- 3Dプリンター製 v3.stl, 4mmスペーサ- 3Dプリンター製 v2.stl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]
2025-08-26 旧基板防水をpcb_connector_oldに移動
    [BOM-pcb_connectors.csv, bom.csv, designators.csv, pcb_connector_azimuth_thruster.kicad_pcb, pcb_connector_azimuth_thruster.kicad_sch, pcb_connector_azimuth_thruster.step, pcb_connector_led_tape.kicad_pcb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]
2025-09-15 制御基板REV01完成
    [AQUA_VESC-to-relay-pcb.kicad_pcb, AQUA_VESC-to-relay-pcb.kicad_sch, AQUA_VESC.kicad_pcb, AQUA_VESC.kicad_sch, BOM-control_unit.csv, DRV8301.kicad_sch, LM25145_quickstart_calculator_A5.xlsm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]
2025-09-19 方針変更、back_connector_escにMT60を使用しないことに
    [AQUA_VESC.kicad_pcb, AQUA_VESC.kicad_sch, DRV8301.kicad_sch, LM76002.kicad_sch, Power mosfets.kicad_sch, RGBLED_Driverkicad_sch.kicad_sch, STM32F405.kicad_sch, can.kicad_sch]
2025-10-03 ESC周りの配線用基板進捗
    [AQUA_VESC-to-relay-pcb.kicad_pcb, AQUA_VESC-to-relay-pcb.kicad_sch, AQUA_VESC-to-relay-pcb.step, AQUA_VESC.kicad_pcb, AQUA_VESC.kicad_sch, DRV8301.opj, Power mosfets.kicad_sch, TK3R2E06PL.OLB]
